waggle-sensor/sensors/sensors/README.md

<!--
waggle_topic=IGNORE
-->

# Chem_conv and beehive_plot

* **Chem_conv**: Codes in Chem_conv folder convert chemsense reading (in nA) stored in beehive database to ppm
* **conv_only**: Codes in conv_only folder convert chemsense reading, but no downloading data from beehive
* **beehive_plot**: Codes in beehive_plot folder plot temperature, humidity, and pressure data (easily add other parameters)
* **MetAddOn**: Datasheets for decagon soil moisture sensor and OnSet rain gauge
* **airsense**: Datasheets for all sensors on metsense board
* **lightsense**: Datasheets for all sensors on lightsense board
* **chemsense**: Datasheets for all sensors on chemsense board
* **opc**: Datasheets and relative data for opc particle sensor
* **images**: Images for the sensor boards
