waggle-sensor/sensors/sensors/conv_only/README.md

<!--
waggle_topic=IGNORE
-->

# Documentation:

 python scripts for Linux or Mac in this directory can be used to create new sensor data csv file. 
 You much have numpy and math python libraries, and sensor_data_set.csv and calib_data.csv files.
 
Usage:

$ python3 beehive_csv.py
