waggle-sensor/sensors/v4/documentation/README.md

<!--
waggle_topic=/sensors/v4.1,Data Format v4.1
-->

# Sensor Format V4.1

Please refer to [v4dataExchange.pdf](https://github.com/waggle-sensor/sensors/blob/master/v4.1/documentation/v4dataExchange.pdf).

If you do not have the file or the file is not found, use the following command to create it.

```bash
make
```
