waggle-sensor/sensors/v3/documentation/sensor-documentation/README.md

<!--
waggle_topic=/sensors/v3,Data Format v3
-->

# Sensor Format V3

Please refer to [sensorStreamFormat.pdf](https://github.com/waggle-sensor/waggle/blob/master/coresensors/docs/sensorStreamFormat/sensorStreamFormat.pdf).

If you do not have the file or the file is not found, use the following command to create it.

```bash
make
```
