waggle-sensor/sensors/v4/documentation/v4dataExchange.tex

\documentclass{article}

\usepackage{longtable}
\usepackage{footnote}

\usepackage{indentfirst}
\usepackage{tabto}

\usepackage[utf8]{inputenc}
\usepackage[T1]{fontenc}
\usepackage{fancyhdr}
\usepackage{geometry}
\usepackage{array}
\usepackage[usenames,dvipsnames,svgnames,table]{xcolor}
\usepackage{multirow}
\usepackage{morefloats}
\usepackage{float}
\usepackage{soul}
\usepackage{color}
\usepackage{seqsplit}
\usepackage{gensymb}
\usepackage{siunitx}
\usepackage{graphicx}
\usepackage{pdfpages}
\usepackage[framemethod=TikZ]{mdframed}
\setcounter{secnumdepth}{3}

\usepackage[procnames]{listings}
\usepackage{color}

\definecolor{keywords}{RGB}{255,0,90}
\definecolor{comments}{RGB}{0,0,113}
\definecolor{red}{RGB}{160,0,0}
\definecolor{green}{RGB}{0,150,0}

\lstset{language=Python,
        basicstyle=\ttfamily\small,
        keywordstyle=\color{keywords},
        commentstyle=\color{comments},
        stringstyle=\color{red},
        % showstringspaces=false,
        identifierstyle=\color{green},
        procnamekeys={def,class}}

\restylefloat{table}

\fontfamily{cmss}\selectfont

\geometry{top = 1in, bottom = 1in, left = 0.5in, right = 0.5in}

\setlength{\parindent}{4em}
\setlength{\parskip}{1em}
\renewcommand{\baselinestretch}{1.5}

\pagestyle{fancy}
\renewcommand{\footrulewidth}{1pt}
\lhead{Waggle Sensor Array}
\chead{Interface and Data Format Specification}
\rhead{Version 1.0}
\lfoot{Waggle Group}
\rfoot{info@wa8.gl, park708@purdue.edu}

\setlength{\tabcolsep}{10pt}
\renewcommand{\arraystretch}{1.0}

%%%%%%%%%%%%%%%%%%%%%%%%%%%%%%%%%%%%%%%%%%%%%%%%%%%%%%%%%%%%%%%%%%%%%%%%%%%%

\begin{document}

\begin{titlepage}
   \vspace*{\stretch{1.0}}
   \begin{center}
        \Huge\textbf{\textsc{Interface and \\ Data Format Specification \\ for sensors \\
        \Large\textsc(v3 sensor boards with Alpha sensor, \\ Firmware version 4.1)}}\\[0.5cm]
        \Large\textsc{Waggle Group \\ Waggle Sensor Array}\\[1cm]
        \large\textsc{November 2017, }
        \large\textsc{Version 1.0}\\
   \end{center}
   \vspace*{\stretch{2.5}}
\end{titlepage}

\tableofcontents
\newpage

\input{interfaceImg.tex}
\input{packetStructure.tex}
\input{SensorData.tex}
\input{SensorDataMetLight.tex}
\input{SensorDataChem.tex}
\input{SensorDataAlpha.tex}
\input{DataUnits.tex}

\end{document}
