waggle-sensor/sensors/v3/documentation/additional-sensors-documentation/interfaceImg.tex

\section{Physical Connections and Interfaces}

Physical connections between a Metsense board and additional sensor will be shown in a figure below.
The sensors will be connected through male-female connectors.
