waggle-sensor/sensors/v3.8/structure_design/waggle_cs_fw_structure_design.pptx

FW

Plugin + config
(HRF → packet)

Sensor

- config
- enable
- disable
- read
- write

Bus

- read
- write

Multiple Plugin in NC
(customized plugin for each user)

Sensor

- init
- config
- read
- write

Bus

- read
- write

single FW in CS

Driver + config

Sensor

- config
- enable
- disable
- read
- write

Bus

- read
- write

Single Drive in NC

request

request

answer

answer

## Slide 2

FW

Reading method

Sensor_id
(representative)

- i2c
- rs232
- spi
- analog
- digital

Function

- i2c
- rs232
- spi
- analog
- digital

- init (called when FW starts)
- config
- read
- write

Sensor

- Core
- New Added

- read
- write

## Slide 3

Sensor

Type

Functions

Sensor

Type

Functions

TMP112

i2c

init read

Onset-rain

digital

interrupt init(pin)

HTU21D

HIH4030

i2c

analog

read

read

soil-moisture

Water-level

rs232

analog

init(serial on) read

read

BMP180

i2c

Init (coeff) read

PMS7003

rs232

init(serial on) read

PR103J2

TSL250

analog

analog

read

read

PMS3003

rs232

init(serial on) read

MMA

i2c

analog

init (coeff) read

SPV

TSYS01

i2c

read

init(coeff) read

HMC

HIH6130

i2c

i2c

Init read

read

MCP(mux)

i2c

init(chip) read

→ APDS, TSL250, TSL260, MLX, ML (5 sensors)

TMP421

Chem

i2c

rs232

read

init(serial on) read

Alpha

spi

Init(pw on) config read
