waggle-sensor/sensors/v4/documentation/v4dataExchange.pdf

# Interface and

# Data Format Specification

# for sensors

(v3 sensor boards with Alpha sensor,

## Firmware version 4.1)

Waggle Group

Waggle Sensor Array

November 2017, Version 1.0

Waggle Sensor Array | Interface and Data Format Specication | Version 1.0

## Contents

1 Physical Connections and Interfaces | 2
2 Data Transmission | 3
3 Sub-packets from Coresense | 7
4 Sensor Data Units | 17
Waggle Group | 1 | info@wa8.gl, park708@purdue.edu

## 1 Physical Connections and Interfaces

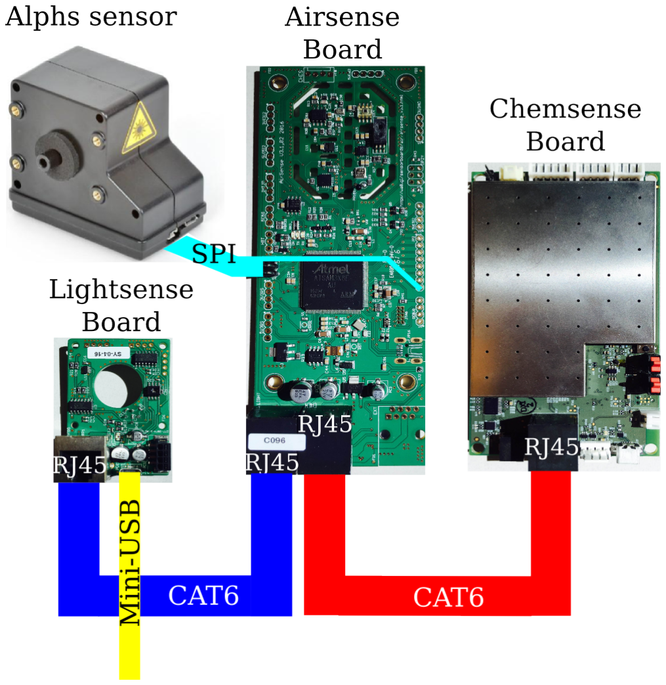
[picture p17: figure]

Figure 1: Connections between the sensor boards and the sensor

`v3 sensor boards with alpha sensor' means a set of sensors that are implemented on a v3.1 Metsense board, a v3.1

Lightsense board, and a Chemsense board and an independent alpha sensor.

Physical connections between sensor boards and an alpha sensor are shown in the Figure 1. A lightsense board

and a chemsense board are connected to a metsense board through CAT6 cable. The metsense and the lightsense deliver

data through I2C communication, and the chemsense board delivers data through serial3 communication. Alpha sensor is

conncted to the metsense on SPI pins and one of GPIT pins. User requests and collects data from alpha sensor using SPI

communication. All sensor data from metsense board, lightsense board, chemsense board, and alpha sensor are delivered to

nodecontroller thourgh USB line attached on lightsense board using Serial communication.

Waggle Group | 2 | info@wa8.gl, park708@purdue.edu

## 2 Data Transmission

The data from the sensor boards are packetized in a transmission pacekt with the form of as they had read from

the sensor. A transmission packet can be composed of several data sub-packets, each of which carries information pertaining

to the parameter. The transmission packet format and the data sub-packets are described here.

2.1 Transmission Packet

A transmission packet can be separated into 6 segments. The structure of the transmission packet relies on posi-

tions of Bytes and predened values for those Byte segments. Table 1 below illustrates how the segments are organized in a

transmission packet.

Preamble | a a | Data Length | b b | Data | CRC | Postscript
1st Byte | 2nd Byte | 3rd Byte | 4th Byte | next Bytes up to 255 Bytes | Penultimate Byte | Final Byte
aPacket Type | Protocol Version
bLast Packet Flag | Sequence

Table 1: Transmission Packet structure

A description how the segments are organized in a transmission packet is shown in table 2 below.

Field | Value | Segment | Length
Preamble | 0xAA | 1 | 1 Byte
Packet Type | 0x00: request 0x01: sensor reading 0x02: bus reading | 2 | 1 Nibble
Protocol version | 0x02 | | 1 Nibble
Length of data | Variable | 3 | 1 Byte
Last Packet ag | 0x01: last packet for one request 0x00: not last packet | 4 | 1 bit
Packet sequence | Variable | | 7 bits
Data | Variable | 5 | Variable
CRC of data | Variable | 6 | 1 Byte
Postscript | 0x55 | 7 | 1 Byte

Table 2: Transmission Packet Segments

Waggle Group | 3 | info@wa8.gl, park708@purdue.edu

The rst segment is the start byte, or the preamble. The preamble is followed by the packet type and protocol

version, each of which are 4 bits long and are together packed into a single byte. Packet type is diered with regard to the

purpose of the packet. When the packet sent from plugin to rmware, the type is requres, and when the packet sent from

rmware, type of the packet could be sensor reading or bus reading. Type sensor reading means the data packetized in

the packet are readings from sensors, which are sorted with sensor id given by Waggle group, and bus reading means the

data packetized in the packet are readings from sensors that do not have given sensor id but connected on metsense board

so that rmware can collect data from. Next, one byte eld that reports the rst 1 bit of last packet ag and 7 bit sequence

number. Following byte reports length of the data which comes along until its immediately. The data segment is followed

by a single CRC byte, and nally the packet ends with a one byte crc and postscript. Table 2 lists the packet and the static

values, if any, for each of the segments.

2.2 Data Sub-packets

The data segment of the transmission packet can be further separated into many sub-packets. Two types of sub-

packets are implemented, each of sub-packets are for sending request from coresense plugin to coresense rmware and visa

versa.

Table 3 below shows the organization of a sub-packet requesting sensor data. The sub-pacekt starts with 4-bits call

function id and 4-bits parameter length including source identier, which is sensor id. The next bytes are parameters starting

with target sensor id. Additional parameters can be attached after the sensor id. For more detail, refer sensor description

le (SDF).

Table 4 below shows the organization of a sub-packet sending sensor reading. The sub-packet starts with a source

identier, which is sensor id. One bit validity eld and seven bits length of the sub-packet eld are packed together as the

next byte. The length eld counts the number of bytes following it which make up the sub-packet. The validity bit is set to

1 if the sensor reading is valid and set to 0 if the sensor is dead, disabled, unconnected, unresponsive or if data could not be

collected from the sensor in the time window. The size of the sub-packet is restricted to 127 Bytes by the seven bits length eld.

Call Function ID | 1-bit Acknowledge | Parameter Length | Parameters a
1 byte | 1 Byte | up to 252 Bytes

aFor sensors have sensor id, 1st Byte is SENSOR ID; For sensors collect data through bus functions, 1st Byte is bus type and 2nd Byte is BUS

ADDRESS

Table 3: Transmission Packet Segments from plugin to rmware

Waggle Group | 4 | info@wa8.gl, park708@purdue.edu

Source ID | 1-bit Validity [0: invalid, 1: valid] | 7-bits Data Length | Data a
1 Byte | 1 Byte | up to 127 Bytes

aFor sensors have sensor id, 1st Byte is SENSOR ID; For sensors collect data through bus functions, 1st Byte is bus type and 2nd Byte is BUS

ADDRESS

Table 4: Transmission Packet Segments

2.3 Data Packer CRC

To validate the data transmitted from and to the sensor board, a CRC value for the data is calculated and transmitted

as part of the data packet. The Maxim 1-Wire CRC polynomial is used for calculating the CRC. On receiving the packet,

the CRC is recalculated and compared with the value transmitted as part of the packet. If the two CRC values match, the

transmission is error-free. The equivalent polynomial function of the CRC is shown in Equation 1.

CRC = x

8 + x

5 + x

4 + 1 | (1)

Further description of the Maxim 1-Wire CRC is available in Maxim Application Note 27. Below are the Python

and C implementations of the CRC calculator. The CRC implementations below take a data Byte and the previous CRC as

inputs, and return the new CRC as return value.

Python Code:

def calc_crc ( data_Byte , CRC_Value )

CRC_Value = ord( data_Byte ) ^ CRC_Value

for j in range (8):

if ( CRC_Value | & 0x01 ):
CRC_Value | = ( CRC_Value | >> 0x01) ^ 0x8C

else :

CRC_Value | = | CRC_Value | >> 0x01

return CRC_Value

C Code:

unsigned char CRC_CALC ( unsigned char data , unsigned char crc)

{

unsigned char i;

Waggle Group | 5 | info@wa8.gl, park708@purdue.edu

crc ^= data ;

for (i=0 x00; i < 0x08; i++)

{

if (crc & 0x01 ) { crc = (crc >> 0x01 )^0 x8C ; }

else { crc = crc >> 0x01 ; }

}

return (crc );

}

Waggle Group | 6 | info@wa8.gl, park708@purdue.edu

## 3 Sub-packets from Coresense

As shortly explained in document section 2.2, data sub-packets from metsense board, lightsense board, chemsense

board, and alpha sensor are generated depending on its data reading from each sensor if valid. The rst byte of the sub-

packets from those sensor boards/sensor is sensor ID, and the rst bit of second byte means validity of the packet and next

7 bits of the second byte is length of the sensor data. Data length and type of sensor reading are shown in Table 5. Detail

of sub-packet and sensor data will be explined following sections.

3.1 Parameters

The sensor boards output a set of parameters which are identied by a unique ID. Each parameter has a set of

values associated with it which are encoded in an appropriate data format. The table below lists the various parameters

produced by the sensor boards, the unique source ID used to identify them, the values produced by them.

Table 5: Data sub-packet structure (each row is a chunk)

Parameter | Source ID | Values | Data Length
Firmware version | 0xFF | Version (HW/SW) | 2 bytes
| | Build time | 4 bytes
| | Build git | 2 bytes

Metsense board

Metsense/Lightsense MAC address | 0x00 | MAC Address | 6 bytes
TMP112 | 0x01 | Temperature | 2 bytes
HTU21D | 0x02 | Temperature | 2 bytes
| | Relative humidity | 2 bytes
HIH4030 | 0x03 | Relative humidity | 2 bytes
BMP180 | 0x04 | Temperature | 2 bytes
| | Pressure | 3 bytes
PR103J2 | 0x05 | Temperature | 2 bytes
TSL250RD | 0x06 | Visible Light | 2 bytes
MMA8452Q | 0x07 | Acceleration in X | 2 bytes
| | Acceleration in Y | 2 bytes
| | Acceleration in Z | 2 bytes
SPV1840LR5H-B | 0x08 | RMS Sound Level | 128 bytes

Continued on next page

Waggle Group | 7 | info@wa8.gl, park708@purdue.edu

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

3.2 Data packets

The context of each parameter, its utility and the arrangement of its values is described below. In all the tables

below, the validity bit is set to 1, which means the data is valid. The parameter described below are aggregated based on

the sensor-board they are situated on - Metsense, Lightsense and Chemsense.

3.2.1 Firmware Version

This is a 8 bytes version information that identies hardware version, software version, and build information of the

waggle node. The build time and the build git are included to varify the eectiveness of the software. Firmware version is

bit masked and encoded through format 1, and build git is encoded through format 1.

0xFD | 0x88 | Firmware version | Build time | Build git
Byte[0] | Byte[1] | Bytes[2 3] | Bytes[4 7] | Bytes[8 9]

Table 6: Sub-packet of Firmware version

3 bit major HW ver. | 3 bit minor HW ver. | 2 bit major SW ver. | Byte[2]
2 bit major SW ver. | minor SW ver. × 10 + sub SW ver. | Byte[3]

Table 7: Firmware version

3.2.2 | Metsense
- Metsense/Lightsense MAC address: | This is a 6-byte ID that uniquely identies each Airsense board. This MAC

address is also applied to each Lightsense board which has the same board number. The ID is provided by a DS2401 1-Wire

DSN chip. The 1-byte family ID and CRC provided by the DSN chip are omitted, and the rest 6 bytes are used as the Unique

ID.

0x00 | 0x86 | MAC address
Byte[0] | Byte[1] | Bytes[2 7]

Table 8: Sub-packet of met/lightsense board MAC address

- TMP112, HIH4030, PR103J2, TSL250RD, TSYS01: TMP112, PR103J2, and TSYS01 are temperature sensors,

HIH4030 is a humidity sensor, and TSL250RD is a light sensor. The coresense rmware collectes data from TMP112 through

I2C, and from other sensors using analog read. All the reading values from the sensors are packetized as the raw value as

they are collected. The raw reading will be converted relatively to temperature in centigrade, humidity in %RH, and light in

lux.

Waggle Group | 10 | info@wa8.gl, park708@purdue.edu

Sensor ID (0x01, 0x03, 0x05, 0x06, 0x09) | 0x82 | Raw sensor reading
Byte[0] | Byte[1] | Bytes[2 3]

Table 9: Sub-packet for the sensor listed above

- HTU21D: HTU21D is a temperature and relative humidity sensor. The coresense rmware collects data from HTU21D

through I2C and the readings are packetized as the raw value as they are collected. The raw readings will be converted to

temperature in centigrate, humidity in %RH.

0x02 | 0x84 | Raw temperature reading | Raw humidity reading
Byte[0] | Byte[1] | Bytes[2 3] | Bytes[4 5]

Table 10: Sub-packet of a temperature and relative humidity sensor, HTU21D

- BMP180: BMP180 is a temperature and barometric pressure sensor. The coresense rmware collects data from BMP180

through I2C and the readings are packetized as the raw value as they are collected. The raw readings will be converted to

temperature in centigrade and barometric pressure in hPa.

0x04 | 0x84 | Raw temperature reading | Raw pressure reading
Byte[0] | Byte[1] | Bytes[2 3] | Bytes[4 5]

Table 11: Sub-packet of a temperature and barometric pressure sensor, BMP180

- MMA8452Q: MMA8452Q is a three-axis accelerometer. The accelerations in three orthogonal directions, x, y and z,

as a multiple of acceleration due to gravity (g) are obtained from the sensor. The coresense rmware collects data from this

sensor through I2C and the readings are packetized as the raw value as they are collected. The raw reading will be converted

to a vibration value (represented as multiple of g) and three directional acceleration in g.

0x07 | 0x86 | Raw Ax reading | Raw Ay reading | Raw Az reading
Byte[0] | Byte[1] | Bytes[2 3] | Bytes[4 5] | Bytes[6 7]

Table 12: Sub-packet of a three-axis accelerometer, MMA8452Q

- SPV1840LR5H-B: SPV1840LR5H is a MEMS microphone that is sampled at high frequency to obtain the peaks and

calculate the sound intensity for a time window. The coresense rmware collects data from this sensor through analog read

and the readings are packetized as the raw value as they are collected. The raw readings will be converted to sound level in dB.

Waggle Group | 11 | info@wa8.gl, park708@purdue.edu

0x08 | 0xFF | 64 times of Raw reading
Byte[0] | Byte[1] | Bytes[2 129]

Table 13: Sub-packet of a sound level sensor, SPV1840LR5H-B

3.2.3 Lightsense

- HMC5883L: HMC5883L is a three-axis magnetometer. The magnetic eld strengths in three orthogonal directions, x,

y and z are obtained from the sensor. The coresense rmware collects data from this sensor through I2C and the readings

are packetized as the raw value as they are collected. The raw readings will be converted to three directional magnetic eld

in G.

0x0A | 0x86 | Raw Hx reading | Raw Hy reading | Raw Hz reading
Byte[0] | Byte[1] | Bytes[2 3] | Bytes[4 5] | Bytes[6 7]

Table 14: Sub-packet of a three-axis magnetometer, HMC5883L

- HIH6130: HIH6130 is a temperature and relative humidity sensor. The coresense rmware collects data from HIH6130

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

temperature in centigrate, humidity in %RH.

0x0B | 0x84 | Relative Humidity in Format 6 | Temperature in Format 6
Byte[0] | Byte[1] | Bytes[2 3] | Bytes[4 5]

Table 15: Sub-packet of a temperature and relative humidity sensor, HIH6130

- APDS-9006-020, TSL260, TSL250, MLX75305, and ML8511: APDS-9006-020, TSL260, TSL250, MLX75305,

and ML8511 are light sensors that produce the analog voltage representing in general luminance, irradiance measured in

µW/cm²
, or UV index. The coresense rmware collects data from sensors listing above through I2C and the reading is

packetized as the raw value as it is collected. The raw reading will be converted to temperature in centigrate, humidity in

%RH.

Sensor ID (0x0C ∼ 0x10) | 0x82 | Voltage output in Format 1
Byte[0] | Byte[1] | Bytes[2 3]

Table 16: Sub-packet of light intensity sensors, APDS-9006-020, TSL260, TSL250, MLX75305, and ML8511

Waggle Group | 12 | info@wa8.gl, park708@purdue.edu

- TMP421: TMP421 is a temperature sensor. The coresense rmware collects data from TMP421 through I2C and the

reading is packetized as the raw value as it is collected. The raw reading will be converted to temperature in centigrate.

0x13 | 0x82 | Temperature in Format 6
Byte[0] | Byte[1] | Bytes[2 3]

Table 17: Sub-packet of a temperature sensor, TMP421

3.2.4 Chemsense:

Chemsense board sends data through Serial3 communication line in metsense board. All sensor values from chem-

sense board are caluated in its own rmware. The raw serial readings from the board are packetized as the raw value as they

are collected, and the reading will be sorted out in database.

- Chemsense reading: To fully collect all the data from chemsense board, the rmware collect data three times in a row,

so that coresense rmware sends three packets when it gets request of reading of chemsense board.

0x2A | Varies | Raw reading
Byte[0] | Byte[1] | Bytes[Vareis]

Table 18: Sub-packet of a chemsense board

- Chemsense rmware conguration: THIS DATA DO NOT FOLLOW CORESENSE PACKET FORMAT,

NO FORMAT AT ALL Chemsense Fiwmware conguration is one-time collectable charactor data, when the board is

powered on. The coresense rmware collectes data when the board is powered on, and store the data into an array. The user

can call this data with their own plugin (request and answer collecting functions).

1st line | Start sending Chemsense FW conguration
2nd 48th line | Each raw reading line (Character)
last line | End sending Chemsense FW conguration

Table 19: Sub-packet of chemsense rmware conguration

3.2.5 Alpha Sensor:

Coresense rmware communicates with alpha sensor through SPI. The raw SPI readings from the board are packe-

tized as the raw value as they are collected, and the reading will be sorted out in database. In this document, concise Alpha

sensor information is provided. For more information, refer to `Firmware commands version 18.xls' and `OPC-N2

Manual Issue December 2015.pdf ' at `waggle/docs/alphasense-opc-n2'.

Waggle Group | 13 | info@wa8.gl, park708@purdue.edu

- Histogram Histogram of alpha sensor is 62 bytes of reading. This parameter provides various information as listed

below. All data from the alpha sensor is LSB rst.

0x28 | 0xBE | Various sensor information as listed above
Byte[0] | Byte[1] | Bytes[2 63]

Table 20: Sub-packet Alpha sensor histogram

- Bin Counts (Bin0 - Bin15) are unsinged 16 bit integer variables (Bytes[2 33]).
- An unsigned 8-bit integer represents the average amount of time that particles sized in the stated bin took cross the

laser beam of the sensor. Value 10 represents 3.33 µs (Bytes[34 37]).

- The sample ow rate in ml/s is provided as a oat variable (Bytes[38 41]).
- Temperature and Pressure alternating. Temperature is an unsigned 32-bit integer that represents temperature in

Celsious multiplied by 10. Pressure is an unsigned 32-bit integer that represents pressure in pascals (Bytes[42 45]).

- Actual sampling period of a measure of the historgam in seconds provided as 4 bytes of oat variables (Bytes[46 49]).
- The least signicat 16-bit of the sum of the counts in all the histogram bins is provided by unsigned 16bit integers

(Bytes[50 51]).

- A oat variable occupying 4 bytes for PM1. Unit is µg/m³
(Bytes[52 55]).
- A oat variable occupying 4 bytes for PM2.5. Unit is µg/m³ (Bytes[56 59]).
- A oat variable occupying 4 bytes for PM10. Unit is µg/m³ (Bytes[60 63]).
Parameter | Data location
Bin Count (32 Bytes) | Bytes[2 - 33]
Average Time (4 Bytes) | Bytes[34 37]
Sample ow rate (4 Bytes) | Bytes[38 41]
Temp/Pressure(alter) (4 Bytes) | Bytes[42 45]
Sampling period (4 Bytes) | Bytes[46 49]
Sum of the counts (2 Bytes) | Bytes[50 51]
PM1 (4 Bytes) | Bytes[51 55]
PM2.5 (4 Bytes) | Bytes[56 59]
PM10 (4 Bytes) | Bytes[60 63]

Table 21: Detail sub-packet of Alpha sensor histogram

- Serial Serial of alpha sensor is 20 bytes of reading. This parameter provides the serial number of the alpha sensor by

character.

Waggle Group | 14 | info@wa8.gl, park708@purdue.edu

0x29 | 0x94 | Raw values
Byte[0] | Byte[1] | Bytes[2 21]

Table 22: Sub-packet of Alpha sensor serial number

- Firmware Firmware of alpha sensor is 2 bytes of reading. This parameter provides the Firmware version of the alpha

sensor by two unsigned 8-bit integer.

0x30 | 0x82 | Raw values
Byte[0] | Byte[1] | Bytes[2 3]

Table 23: Sub-packet of Alpha sensor rmware

- Status Status of alpha sensor is 4 bytes of reading. This parameter provides status of the alpha sensor in terms of if fan

and laser are on/o and DAC value of the fan and laser.

0x2B | 0x84 | Raw values
Byte[0] | Byte[1] | Bytes[2 5]

Table 24: Sub-packet of Alpha sensor rmware

Parameter | Data location
Fan on/o (1 Byte, 0 or 1) | Bytes[2]
Laser on/o (1 Byte, 0 or 1) | Bytes[3]
Fan DAC value (1 Byte) | Bytes[4]
Laser DAC value (1 Byte) | Bytes[5]

Table 25: Detail sub-packet of Alpha sensor histogram

- Conguration THIS DATA DO NOT FOLLOW CORESENSE PACKET FORMAT, NO FORMAT AT

ALL Conguration of alpha sensor is 256 bytes of reading. This parameter provides various information as listed below.

Since this conguration data is too long to t into a sub-packet, the data are not packed into coresense packet.

1st line | Start sending alpha sensor conguration
2nd line | 256 bytes of raw reading (Binary)
last line | End sending alpha sensor conguration

Table 26: Sub-packet of alpha sensor conguration

Waggle Group | 15 | info@wa8.gl, park708@purdue.edu

- Bin Boundaries (BB0 - BB14) are unsinged 16 bit integer variables, and two spare bytes.
- Bin Particle Volumes (BPV0 - BPV15) are oat variables occupyting 4 bytes each.
- Bin Particle Densities (BPD0 BPD15) are oat variables occupying 4 bytes each.
- Bin Sample Volume Weightings (BSVW0 BSVW15) are oat variables occupying 4 bytes each.
- Gain Scaling Coecient (GSC) is oat variable occupying 4 bytes.
- Sample ow rate is a oat variable occupying 4 bytes.
- Laser DAC value is unsigned 8bit interger variable.
- Fan DAC value is unsigned 8bit integer variable.
- Time of Flight to Sample Flow Rate conversion factor is unsigned 8bit integer variable.
- 21 spare bytes follow Conguration variables.
Parameter | Data location
Bin Boundaries (32 Bytes) | Bytes[0 31]
Bin Particle Volumes (64 Bytes) | Bytes[32 95]
Bin Particle Densities (64 Bytes) | Bytes[96 159]
Bin Sample Volume Weightings (64 Bytes) | Bytes[160 223]
Gain Scaling Coecient (4 Bytes) | Bytes[224 227]
Sample Flow Rate (4 Bytes) | Bytes[228 231]
Laser DAC (1 Byte) | Byte[232]
Fan DAC (1 Byte) | Byte[233]
Conversion factor (1 Byte) | Byte[244]
Spare Bytes (21 Bytes) | Bytes[245 255]

Table 27: Detail second lind of Alpha sensor conguration

Waggle Group | 16 | info@wa8.gl, park708@purdue.edu

4 | Sensor Data Units
4.1 | Raw and Processed

The sensor boards output a set of raw readings which need to be calculated for proper units for each of data. The

table below lists the various units for each sensor values. `Current Units' in the table means the unit after conversion through

designated equations stored in database currently (Nov, 2017), and `Processed Units' means the unit which will be updated

in the future.

Table 28: Sensor units

Sensor/Parameter | Current Units | Processed Units | Comments
Firmware version | No Units | No Units

Airsense board

Met/Lightsense MAC | No Units | No Units
TMP112 | ◦C | ◦C
HTU21D | ◦C, %RH | ◦C, %RH
BMP180 | ◦C, Pa | ◦C, Pa
PR103J2 | ◦C | ◦C
TSL250RD | Raw reading* | µw/m²
MMA8452Q | g, g, g | g, g, g, g
SPV1840LR5H-B | Raw reading*
TSYS01 | ◦C | ◦C

Lightsense board

HMC5883L | G, G, G | G, G, G
HIH6130 | ◦C, %RH | ◦C, %RH
APDS-9006-020 | Raw reading | lux
TSL260RD | Raw reading* | µw/m²
TSL250RD | Raw reading* | µw/m²
MLX75305 | Raw reading* | µw/m²
ML8511 | Raw reading* | UV index
TMP421 | ◦C | ◦C

Chemsense board

Chemsense conguration | No unit | No unit | Don't need conversions
Chemsense reading | Raw reading* | See Table 29

Continued on next page

Waggle Group | 17 | info@wa8.gl, park708@purdue.edu

Table 28 continued from previous page

Sensor/Parameter | Current Units | Processed Units | Comments

Alpha sensor

Serial | No unit | No unit
Firmware | No unit | No unit

Alpha sensor Status

FanON | No unit | No unit
LaserON | No unit | No unit
FanDACVal | No unit | No unit
LaserDACVal | No unit | No unit

Alpha sensor Histogram

Bin count | No unit | No unit
Average time | Raw reading* | µs | value 10 = 3.33 µs
Sample ow rate | Raw reading* | ml/s
Temp/Pressure(alter) | Raw reading* | ◦C / hPa (alter)
Sampling period | Raw reading* | s
Sum of the counts | No unit | No unit
PM1 | Raw reading* | µg/m³
PM2.5 | Raw reading* | µg/m³
PM10 | Raw reading* | µg/m³

Alpha sensor Conguration

Bin boundaries | No unit | No unit
Bin particle volumes | Raw reading*
Bin particle densities | Raw reading*
Bin sample volume weightings | Raw reading*
Gain scaling coecient | Raw reading*
Sample ow rate | Raw reading*
Laser DAC | Raw reading*
Fan DAC | Raw reading*
Conversion factor | Raw reading*
Spare bytes | No unit | No unit

*Raw reading means the reading has no unit currently, and conversion equation for the sensor is not implemented in database. The data stored

in database for this sensor is just integer form of raw reading.

Waggle Group | 18 | info@wa8.gl, park708@purdue.edu

Source ID | Parameter | Current Units | Processed Units | Comments
0x15 | Total reducing gases | Raw reading* | ppm
0x17 | Nitrogen dioxide
0x18 | Ozone
0x19 | Hydrogen sulphide
0x1A | Total oxidizing gases
0x1B | Carbon monoxide
0x1C | Sulfur dioxide
0x1D | SHT25 | 100ths of ◦C / %RH | ◦C, %RH
0x1E | LPS25H | 100ths of ◦C, Pa | ◦C, Pa
0x1F | Si1145 | Raw reading* | | Uncompleted FW
0x20 | Intel MAC address | No Units | No Units
0x21 | CO ADC temp | 100ths of ◦C | ◦C
0x22 | IAQ IRR ADC temp
0x23 | O3 NO2 ADC temp
0x24 | SO2 H2S ADC temp
0x25 | CO LMP temp
0x26 | Accelerometer | Raw reading* | | Not in Chem v2 Uncompleted for v1&2
0x27 | Gyro | Raw reading*

*Raw reading means the reading has no unit currently, and conversion equation for the sensor is not implemented in database. The data stored

in database for this sensor is just integer form of raw reading.

Table 29: Transmission packet structure of chemsense board reading

Waggle Group | 19 | info@wa8.gl, park708@purdue.edu
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
