waggle-sensor/sensors/v3/documentation/sensortable/SensorTable.pdf

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

Waggle Sensor Array Sensors Version 0.2 alpha 3 Table 1 Continued from previous page Parameter ID Values Sensor Output FW Output Beehive Output Decoder Output Conguration D 0x34 Bin Sample Vol Weightings B raw register raw register n/a raw register Gain Scaling Coecient Sample Flow Rate Laser DAC and Fan DAC Conversion factor Space Bytes Rain Gauge Rain Gauge 0xFC Rainfall voltage event counts n/a in. or mm Soil Moisture Sensor (5TE Decagon) Soil Sensor 0xFB Dielectric permittivity No Unit No Unit n/a No Unit Electric conductivity dS/m dS/m n/a dS/m Temperature

◦C

◦C | n/a

◦C

* Decoder means a decoder for testing coresense rmware, which is in waggle/coresense/v3/integrated/software.

* If output of Beehive and Decoder are dierent, that means conversion equation used in decoder is not yet completely veried.

* Conversion equations used in the decoder are explained in Waggle Doc (v3dataExchange.pdf) in waggle/coresense/v3/docs.

* Data from Alpha sensor using SPI communication is not yet completed, which is through the coresense FW. The data can just translated into human readable

values through coresense decoder.

Waggle Group 4 info@wa8.gl, park708@purdue.edu
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
