waggle-sensor/sensors/sensors/conv_only/calib_data.csv

088726-0013 | 5410EC38B845 | 042617010352 | 110902 | RESP | 1705 | -62.19 | 042617050316 | 999078 | SO2 | 1705 | 11.76 | 051217020232 | 999036 | O3 | 1705 | -84.4 | 042617030318 | 110802 | IAQ | 1705 | 17.00 | 042617040431 | 999062 | H2S | 1705 | 320.75 | 051217010238 | 999061 | NO2 | 1705 | -29.96 | 042617020231 | 110109 | CO | 1705 | 3.40 | 51.288675692313 | 13.6226477391924 | 8.33108934220041 | 171.78732369033 | 37.236515228787 | 22.0693620740967 | 3.12767524618886 | 3.5651 | 37.6159333333333 | 1.28136666666667 | 5.05256666666667 | 0.762066666666667 | 0.5216 | 10.9864 | 12.5733 | 124.719033333333 | 3.438 | 12.0967666666667 | 0.3472 | 0.871666666666667 | 52.0714333333333 | 40.0782333333333 | 436.0858
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
