waggle-sensor/sensors/v3/qa_testing/design_dev_tests/Airsense_Initialization/coresense/README.md

<!--
waggle_topic=IGNORE
-->

## Testing Procedure
*   Setup 1:
    -   Complete electrical connections.
    -   Perform test by issuing command *make run* in the coresense directory.

*   Setup 2:
    ~~-  In the Wagman folder - First issue the command *make install*.~~
    -  On completing the above, perform test by issuing command *make run* in the coresense directory.

*   Setup 3:
    -   Complete electrical connections.
    -   Perform test by issuing command *make run* in the coresense directory.

## Example Output
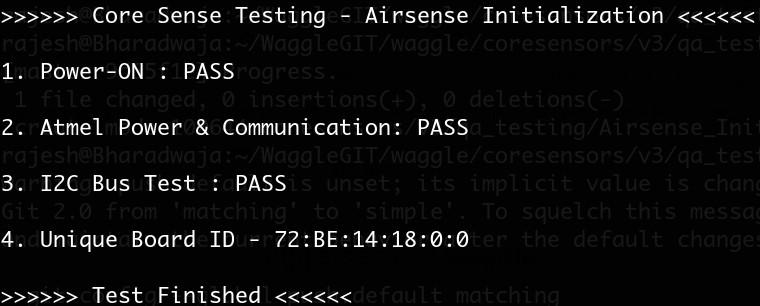
[picture p18: v3/qa_testing/production_tests/Board_Tests_Air+Light/resources/TestOutput.jpg]
