waggle-sensor/sensors/v3/testing/integrated_old/README.md

#Core sensors
TODO: describe what this software does along with the sensors.
