waggle-sensor/sensors/v3/qa_testing/design_dev_tests/Airsense_Heartbeat/README.md

<!--
waggle_topic=IGNORE
-->

# Test Scope and Coverage

This test evaluates the following aspects of Airsense design. </br>
*   Airsense's ability to generate a heartbeat signal which can be sensed by Wagman. </br>

# Test Setup Procedure

## Test Events Timeline
* Wagman is loaded with firmware that tests the presence of Airsense heartbeat.
* Airsense is loaded with firmware that generates the heartbeat.

## Electrical Connection
-   Connect Lightsense to Airsense using CAT6 cable between Lightsense's RJ45 jack and Airsense's RJ45 jack
    labeled __Light__.  </br>
    
-   Connect a micro USB cable between Lightsense and QA computer.
-   Connect the 4 wires (Red, Black, White and Yellow) between Lightsense and Wagman's Port 3 (J6). </br>
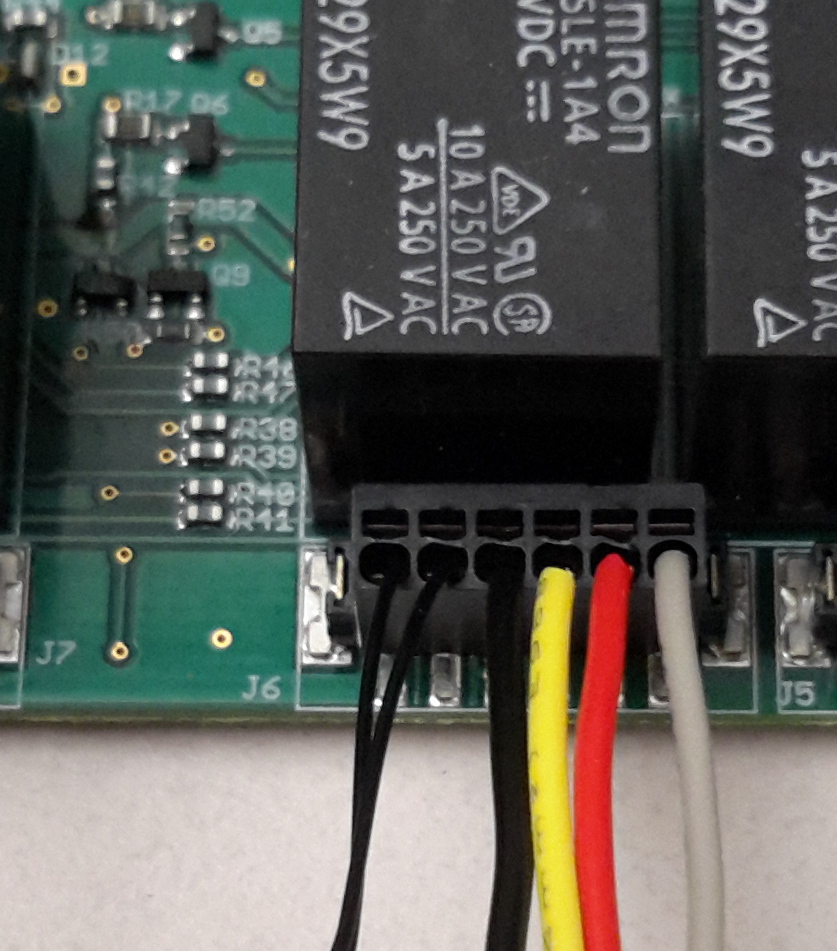
[picture p23: v3/qa_testing/design_dev_tests/Airsense_Heartbeat/resources/Wagman_LightSense.jpg]
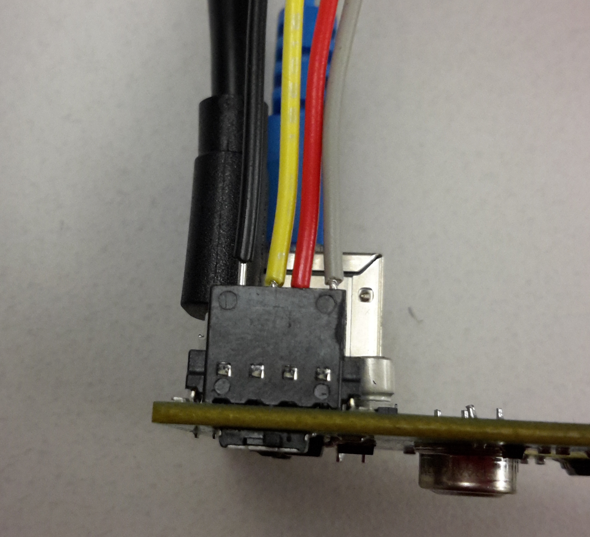
[picture p24: v3/qa_testing/design_dev_tests/Airsense_Heartbeat/resources/Light_sense_Wagman_connection.jpg]
    
-   Set the mode slide switch on Lightsense toward the left (closer to R1 label on the board).</br>
    
-   Connect micro-USB cable between Wagman's J3 and QA computer.
-   Connect 5V DC power to Wagman.

__Please make sure only the Wagman, Airsense and Lightsense under test are connected to the QA computer.
No other Arduino Micro and Due/derivatives can be connected at this time.__

## Testing Procedure
__The Coresense boards are powered by Wagman during the test.__</br>

*  In the Wagman folder - First issue the command *make program*.
*  On completing the above, change to the coresense folder, and issue command *make program*
*  On completing the above, change back to the Wagman folder and issue the command *make test*

__To exit the screen session created for the test, press Control+a, followed by k and y.__

## Test Log
This test is evaluated and scored on the __Coresense QA Test__ document.

# Success Criteria
The test is considered __PASSED__ if all the sub-tests under the Airsense Heartbeat Test pass.
