waggle-sensor/sensors/v3/qa_testing/design_dev_tests/Airsense_Heartbeat/wagman/README.md

<!--
waggle_topic=IGNORE
-->

## Testing Procedure
__Only the Coresense boards are powered by Wagman during the test.__</br>
__The Odroids XU4 and C1P have to be powered on independently.__</br>
*  In the Wagman folder - First issue the command *make program*.</br>
~~*  On completing the above, change to the coresense folder, and issue command *make program*~~</br>
*  On completing the above, change back to the Wagman folder and issue the command *make test*
