waggle-sensor/sensors/v3/integrated/tests/alphasense_opcn2/Dat2_PM1_Multispace.pdf

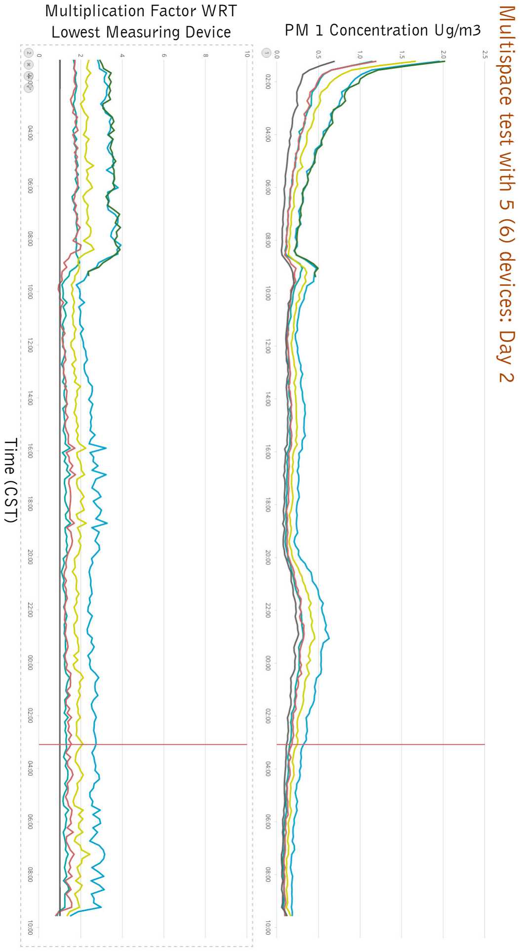
[picture p26: page 1]

Time (CST)

Multiplication Factor WRT
Lowest Measuring Device | PM 1 Concentration Ug/m3

## Multispace test with 5 (6) devices: Day 2
