waggle-sensor/sensors/v3/integrated/tests/alphasense_opcn2/Day2_PM2.5_Multispace.pdf

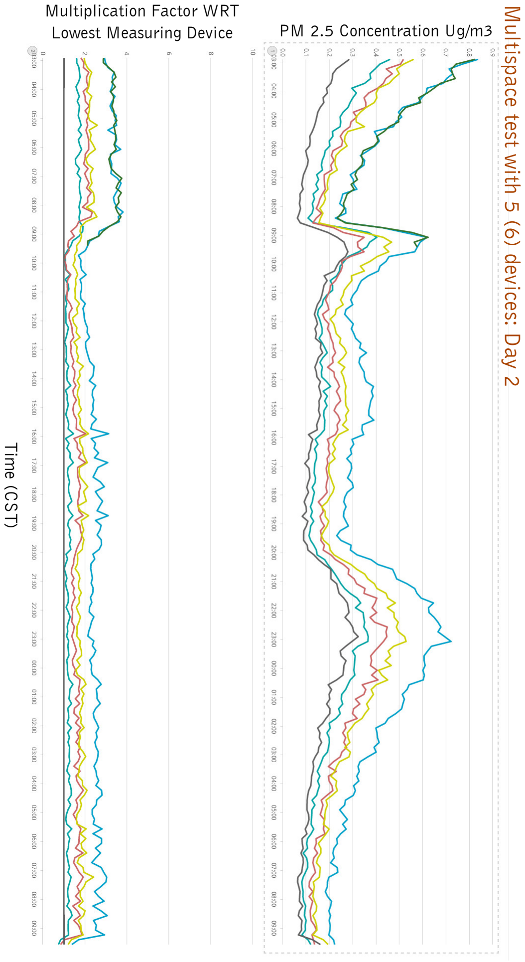
[picture p27: page 1]

Time (CST)

Multiplication Factor WRT
Lowest Measuring Device | PM 2.5 Concentration Ug/m3

## Multispace test with 5 (6) devices: Day 2
