waggle-sensor/sensors/v3/qa_testing/production_tests/QA_Scoresheet/QA_Test.ods

 | Pass / Fail | Coresense QA Test |  | H/W Ver 3.1 2016/Mar/27
Board Unique ID: |  |  |  | Doc Rev. 0.1
S.No | Test | Output | Result | Test Result
I | Airsense Initialization |  |  | Pass / Fail
Setup 1
1 | Power-ON |  | Pass / Fail
2 | Atmel Power & Communication |  | Pass / Fail
3 | I2C Bus Test |  | Pass / Fail
4 | Unique ID |  | Pass / Fail
Setup 2
1 | Power-ON |  | Pass / Fail
2 | Atmel Power & Communication |  | Pass / Fail
3 | I2C Bus Test |  | Pass / Fail
4 | Unique ID |  | Pass / Fail
Setup 3
1 | Power-ON |  | Pass / Fail
2 | Atmel Power & Communication |  | Pass / Fail
3 | I2C Bus Test |  | Pass / Fail
4 | Unique ID |  | Pass / Fail
II | Airsense Heartbeat |  |  | Pass / Fail
1 | Hearbeat Test |  | Pass / Fail
III | Airsense-Lightsense Connectivity |  |  | Pass / Fail
1 | Connectivity Test |  | Pass / Fail
IV | Chemsense Power Control and Connectivity |  |  | Pass / Fail
1 | Serial Connectivity |  | Pass / Fail
2 | Heartbeat and Reset |  | Pass / Fail
3 | Powercontrol
V | External RJ45 Connectivity Test |  |  | Pass / Fail
1 | I2C communication Test. |  | Pass / Fail
VI | Airsense Environmental Sensors Test |  |  | Pass / Fail
1 | TMP112 |  | Pass / Fail
2 | HTU21D |  | Pass / Fail
3 | HIH4030 |  | Pass / Fail
4 | BMP180 |  | Pass / Fail
5 | PR103J2 |  | Pass / Fail
6 | TSL250RD |  | Pass / Fail
7 | MMA8452Q |  | Pass / Fail
8 | SPV1840LR5H-B |  | Pass / Fail
9 | TSYS01 |  | Pass / Fail
10 | HMC5883L |  | Pass / Fail
VII | Lightsense Environmental Sensors Test |  |  | Pass / Fail
1 | HIH6130 |  | Pass / Fail
2 | APDS-9006-020 |  | Pass / Fail
3 | TSL260RD |  | Pass / Fail
4 | TSL250RD |  | Pass / Fail
5 | MLX75305 |  | Pass / Fail
6 | ML8511 |  | Pass / Fail
7 | MLX90614 |  | Pass / Fail
8 | TMP421 |  | Pass / Fail
VIII | OPC-N2 Connectivity Test |  |  | Pass / Fail
1 | Connectivity Test |  | Pass / Fail
