waggle-sensor/sensors/v3/integrated/tests/alphasense_opcn2/Day1_PM10_Outdoor.pdf

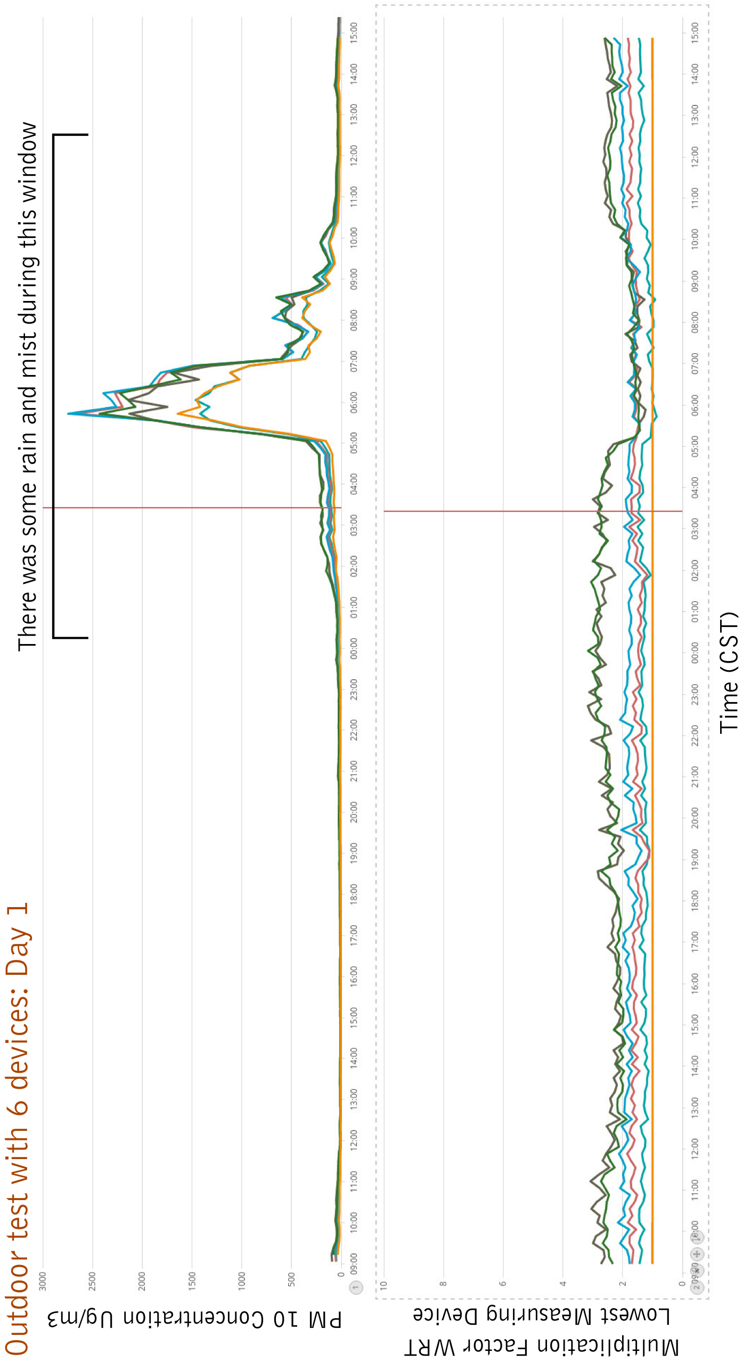
[picture p28: page 1]
