waggle-sensor/sensors/v3/integrated/tests/alphasense_opcn2/Day1_PM1_Outdoor.pdf

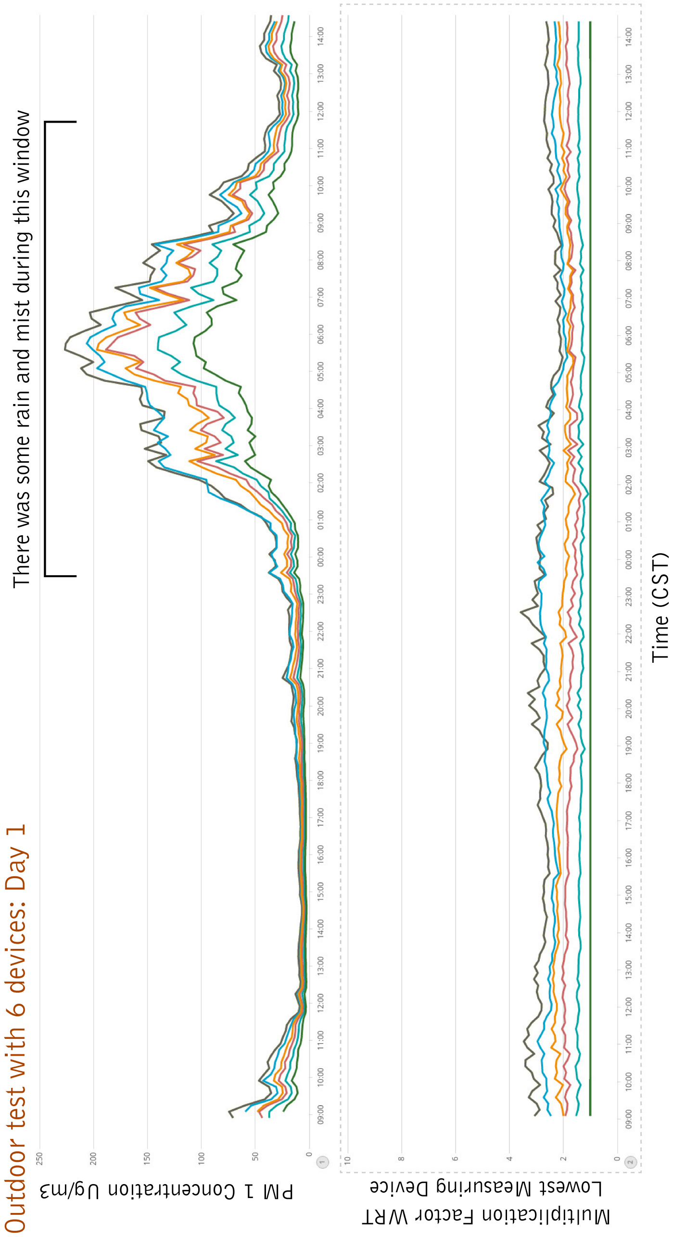
[picture p29: page 1]
