waggle-sensor/sensors/v3/integrated/tests/alphasense_opcn2/Day1_PM2.5_Outdoor.pdf

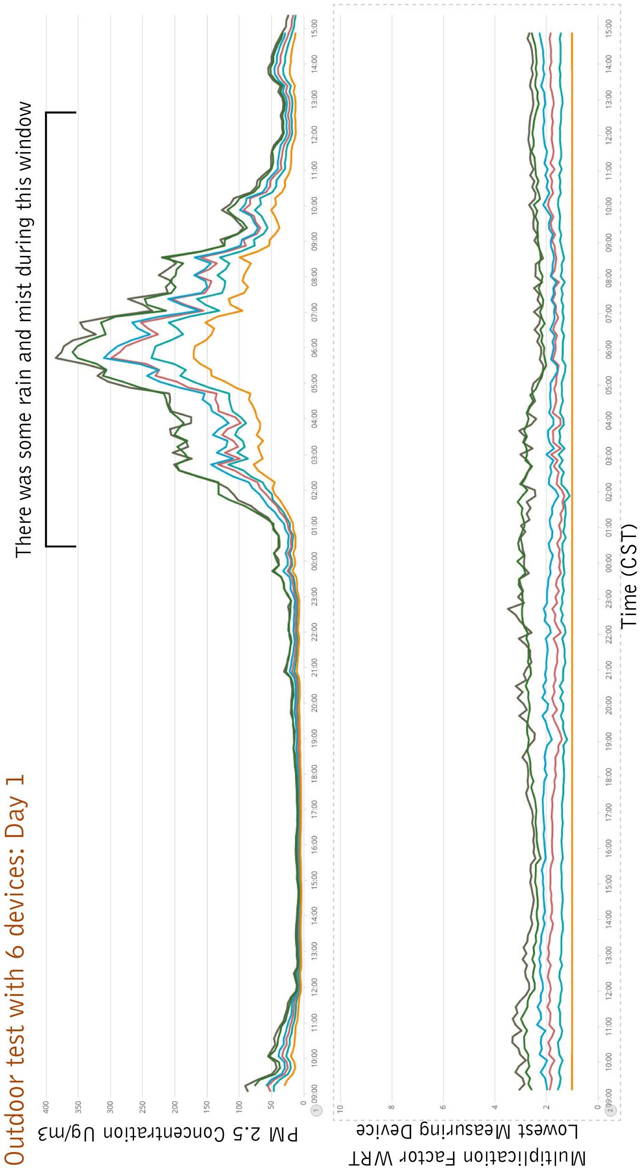
[picture p30: page 1]
