waggle-sensor/sensors/v3/integrated/tests/met_sense/combined_tests/humid_HTU21D_goretex_pod_nopod.pdf

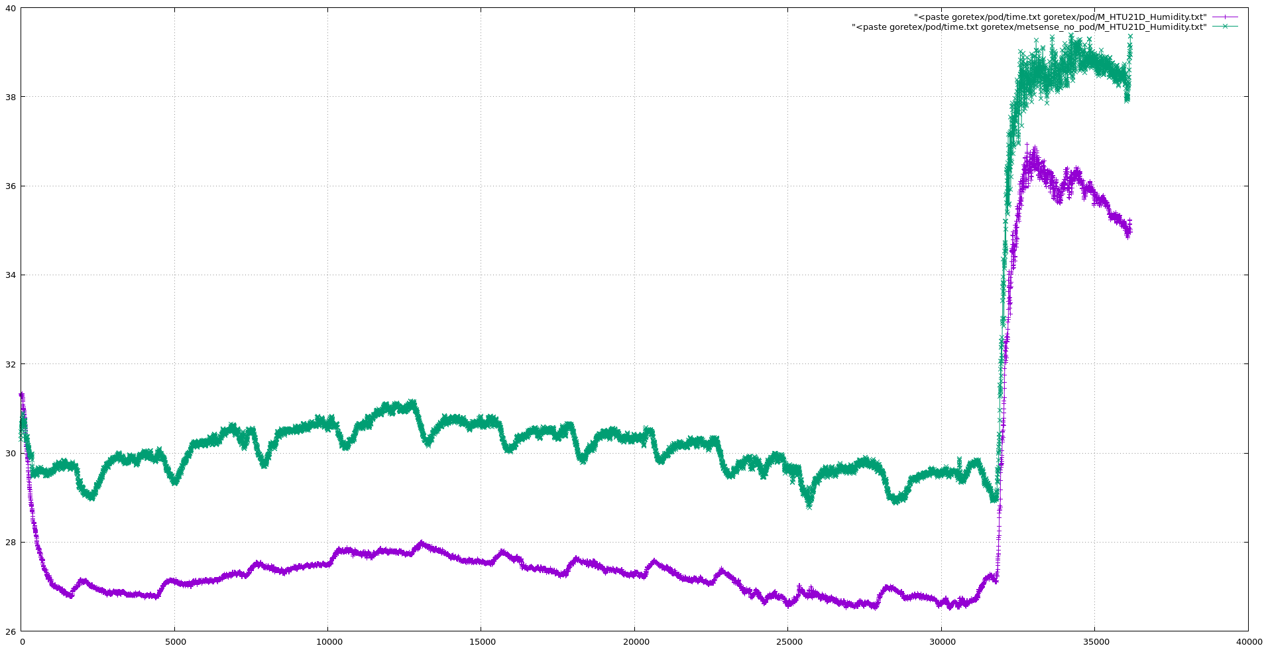
[picture p31: page 1]
