waggle-sensor/sensors/v3/integrated/tests/met_sense/combined_tests/humid_HTU21D_nogoretex_pod_nopod.pdf

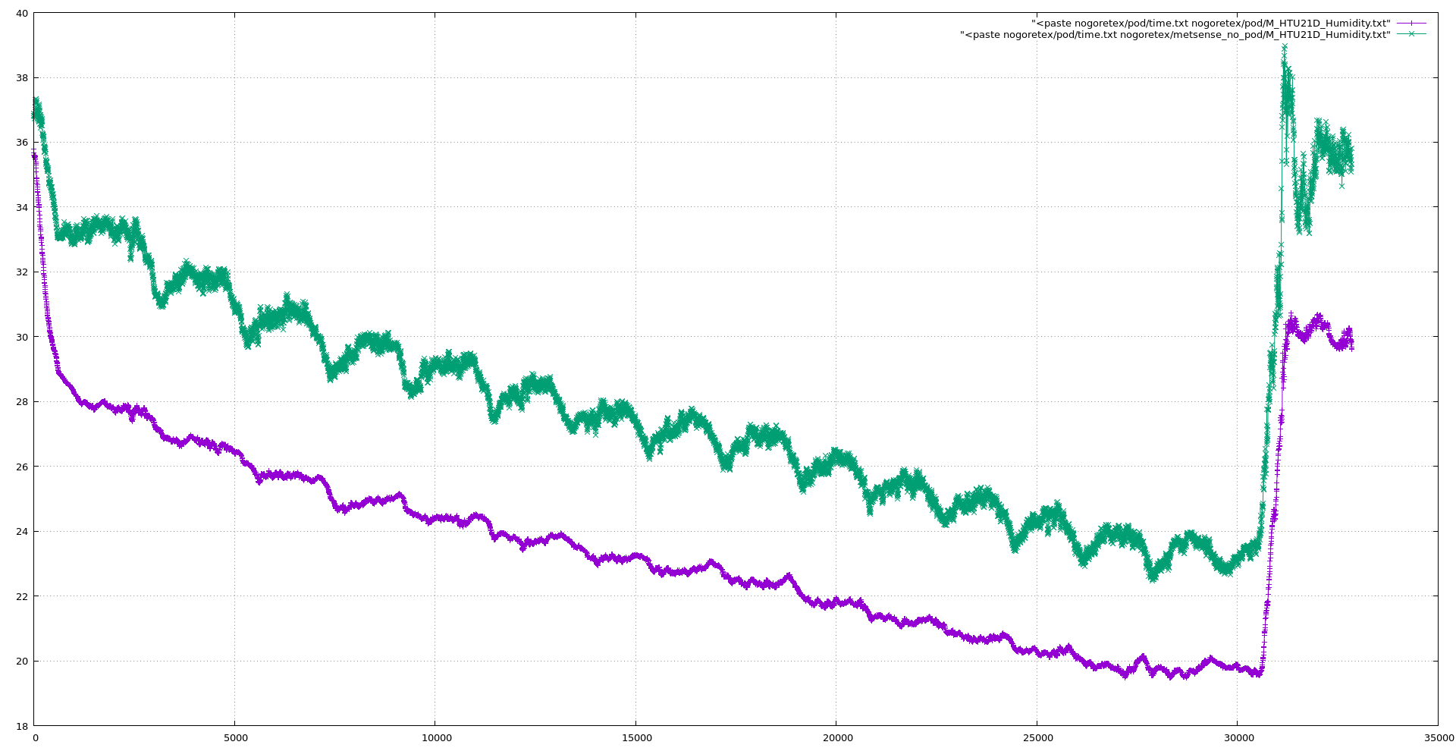
[picture p32: page 1]
