waggle-sensor/sensors/v3/integrated/tests/met_sense/combined_tests/pressure_BMP180_goretex_pod_nopod.pdf

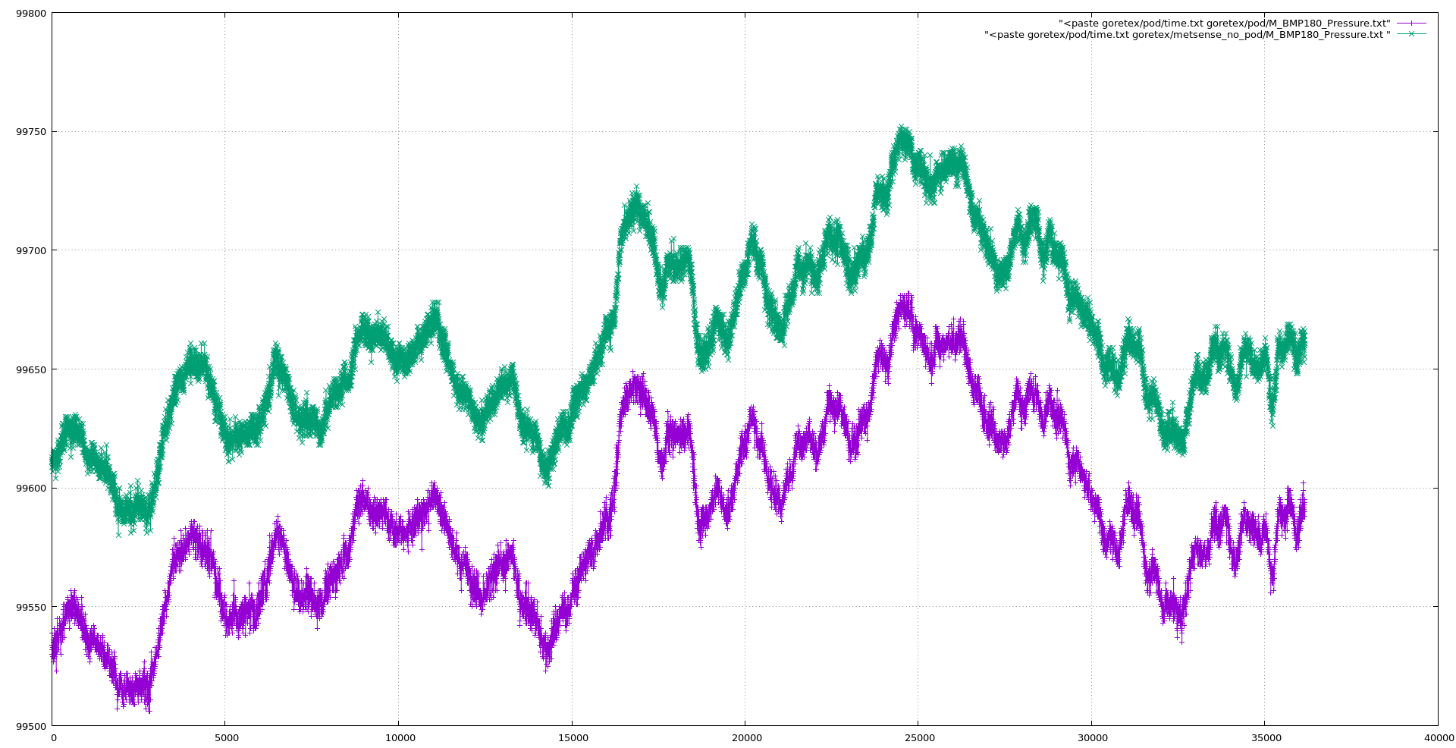
[picture p33: page 1]
