waggle-sensor/sensors/v3/integrated/tests/met_sense/combined_tests/pressure_BMP180_nogoretex_pod_nopod.pdf

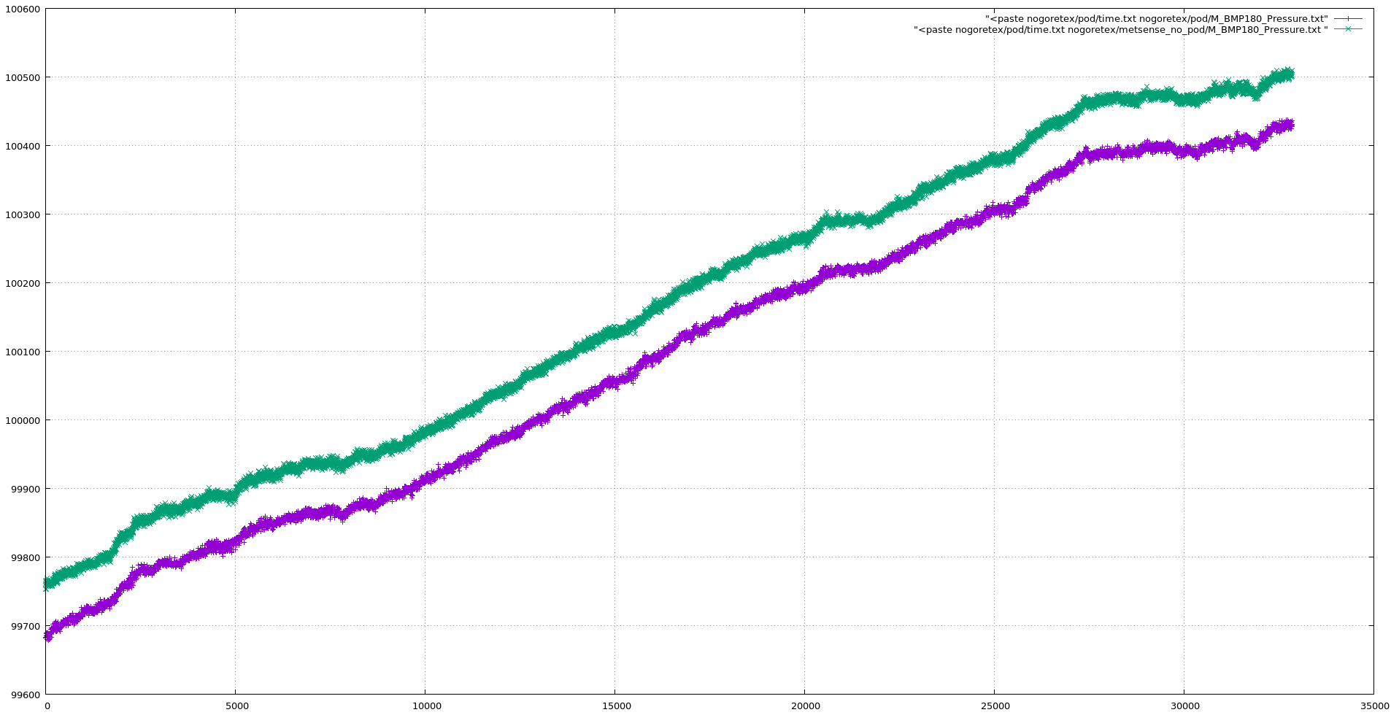
[picture p34: page 1]
