waggle-sensor/sensors/v3/integrated/tests/met_sense/combined_tests/temp_diff_with_goretex.pdf

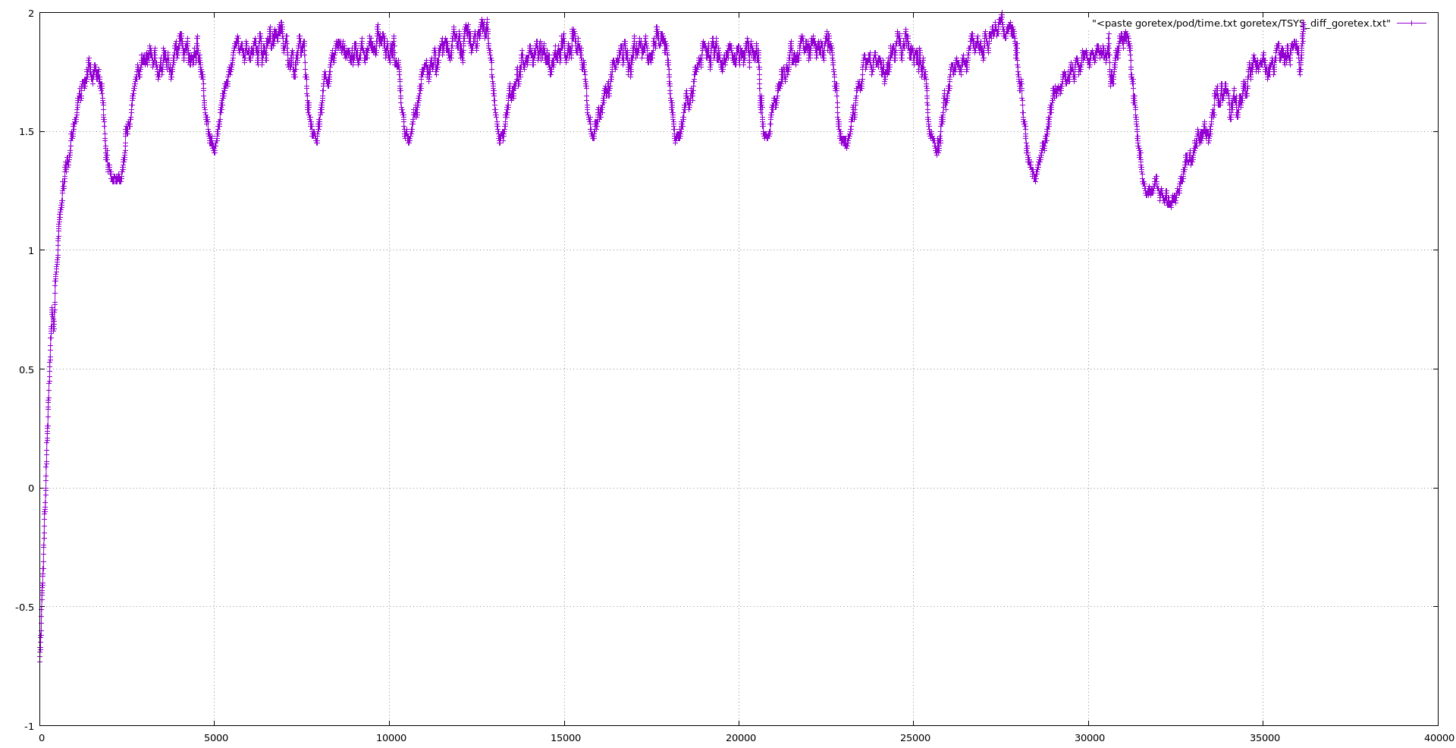
[picture p35: page 1]
