waggle-sensor/sensors/v3/integrated/tests/met_sense/combined_tests/temp_diff_with_nogoretex.pdf

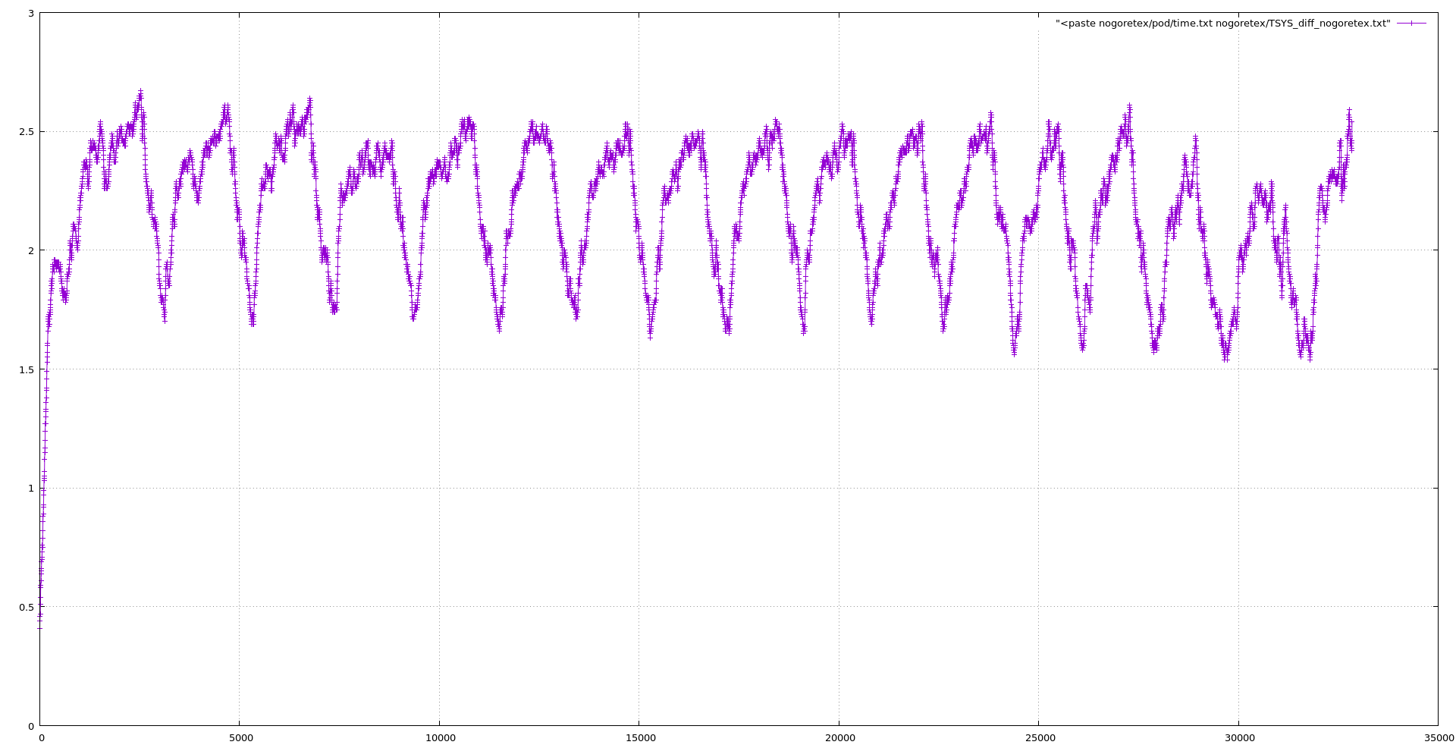
[picture p36: page 1]
