waggle-sensor/sensors/v3/integrated/tests/met_sense/combined_tests/temp_TSYS_goretex_pod_nopod.pdf

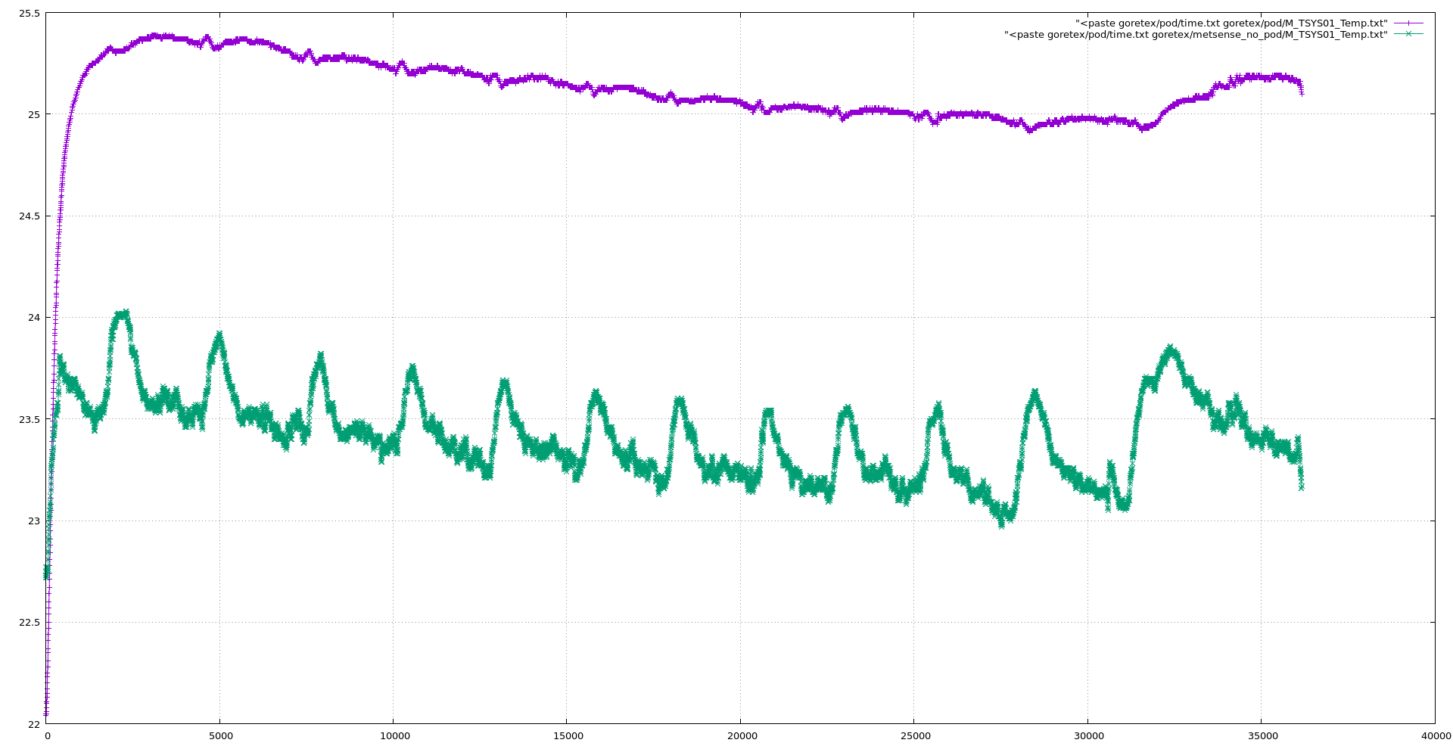
[picture p37: page 1]
