waggle-sensor/sensors/v3/integrated/tests/met_sense/combined_tests/temp_TSYS_nogoretex_pod_nopod.pdf

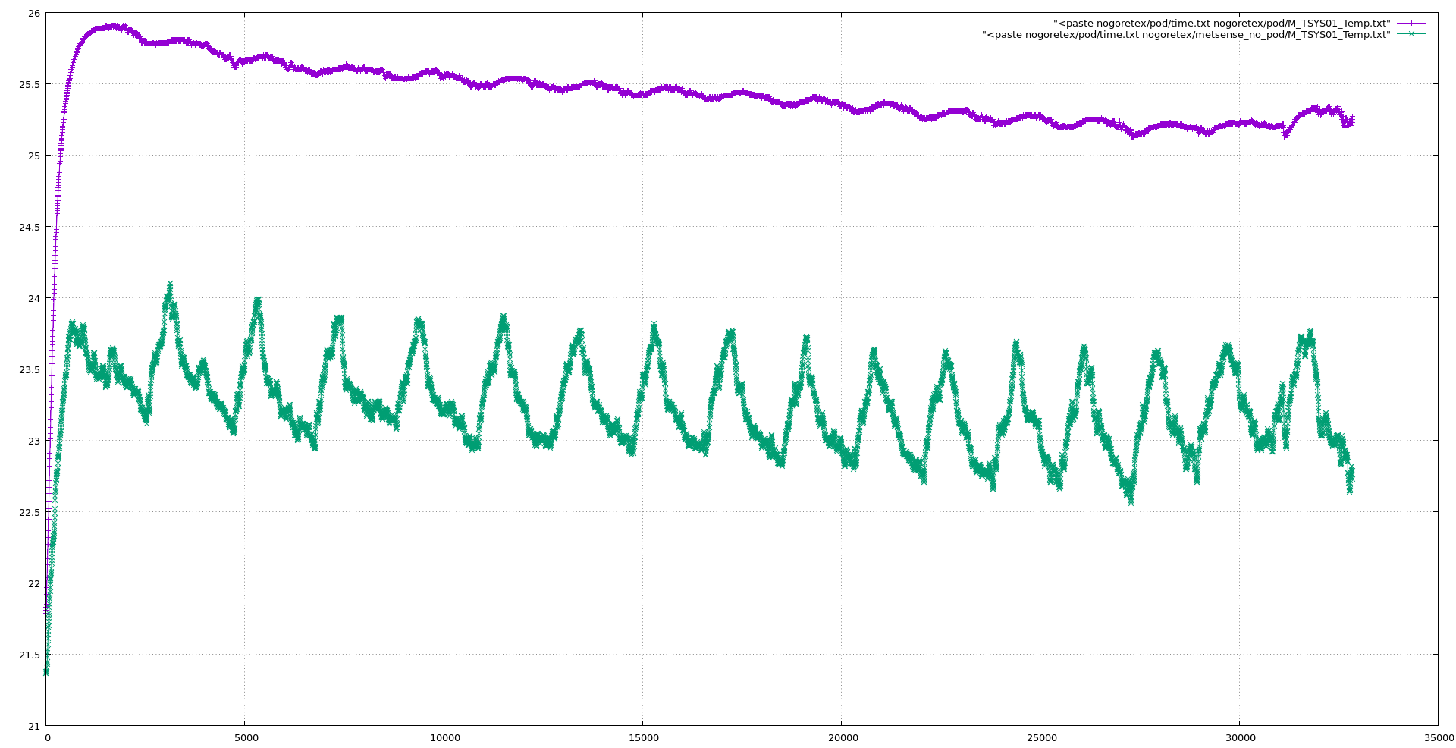
[picture p38: page 1]
