waggle-sensor/sensors/v3/integrated/tests/met_sense/board_tests/cold_boot_short_test/ATM_Pressure.pdf

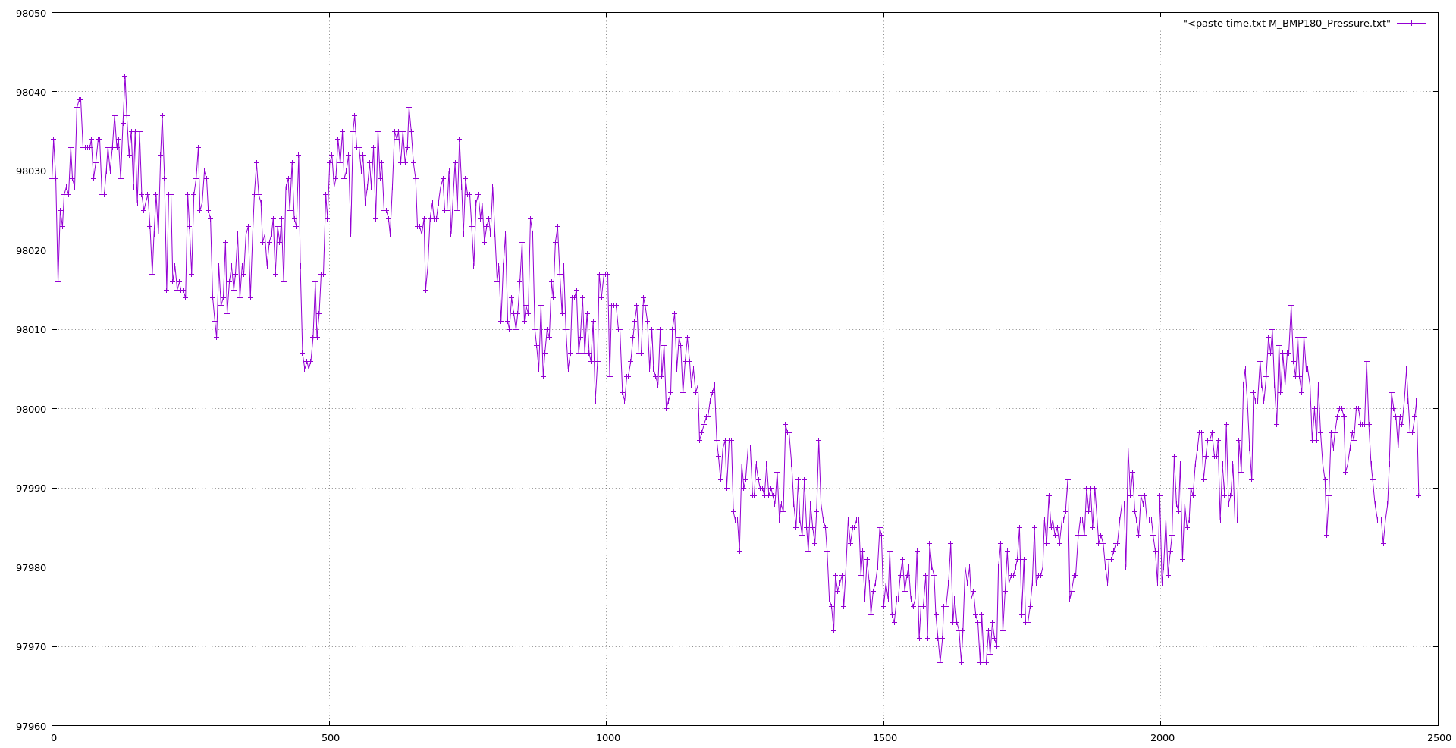
[picture p39: page 1]
