waggle-sensor/sensors/v3/integrated/tests/met_sense/board_tests/cold_boot_short_test/HTU_TSYS_Temp_Diff.pdf

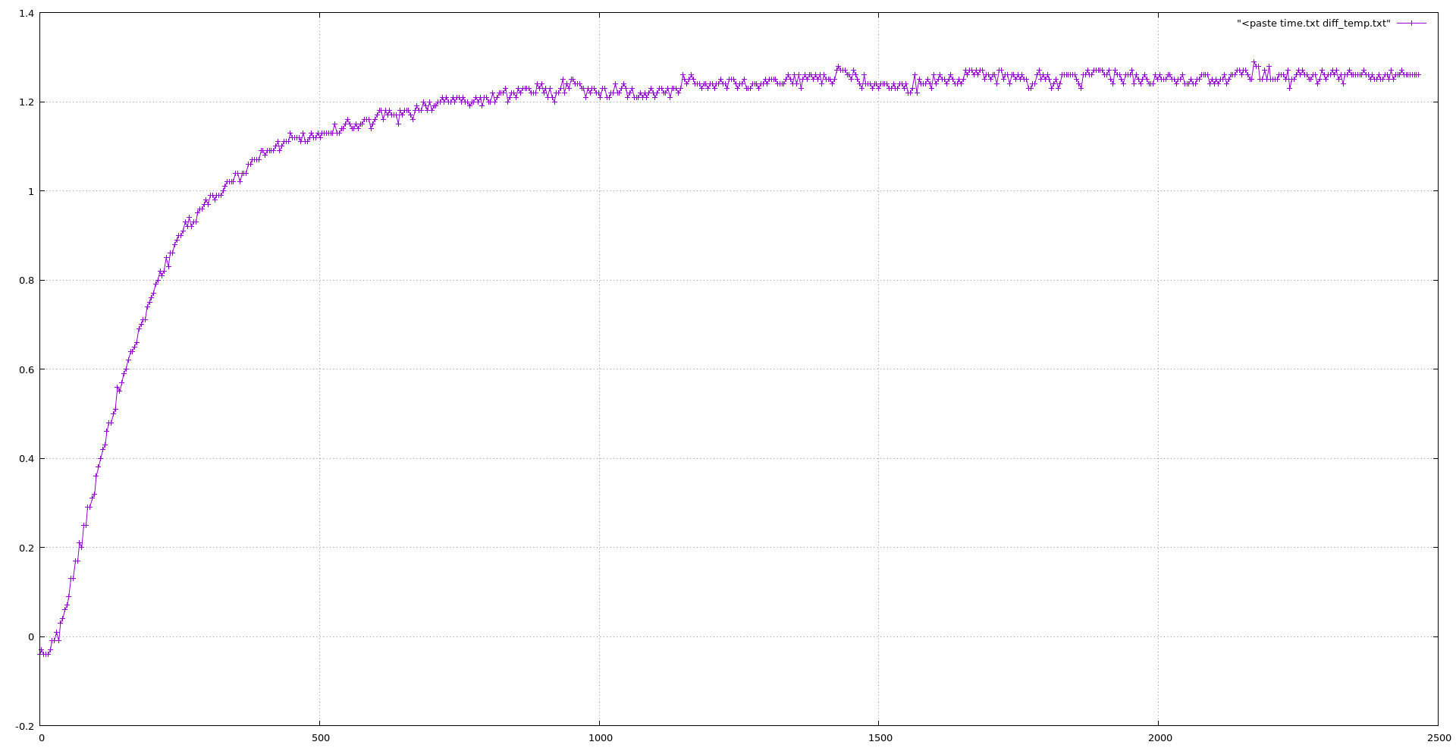
[picture p40: page 1]
