waggle-sensor/sensors/v3/integrated/tests/met_sense/board_tests/cold_boot_short_test/Humidity.pdf

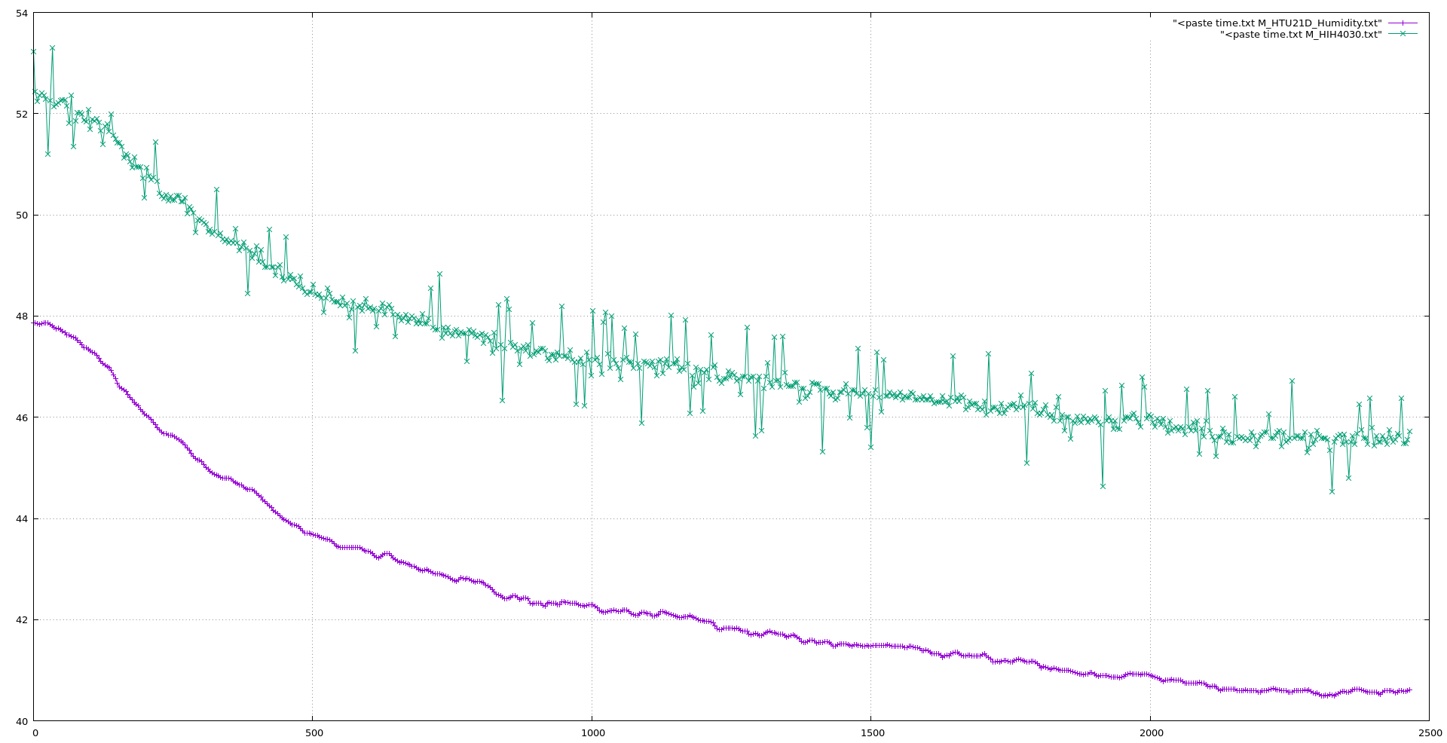
[picture p41: page 1]
