waggle-sensor/sensors/v3/integrated/tests/met_sense/board_tests/cold_boot_short_test/Temp_Humid_Delta.pdf

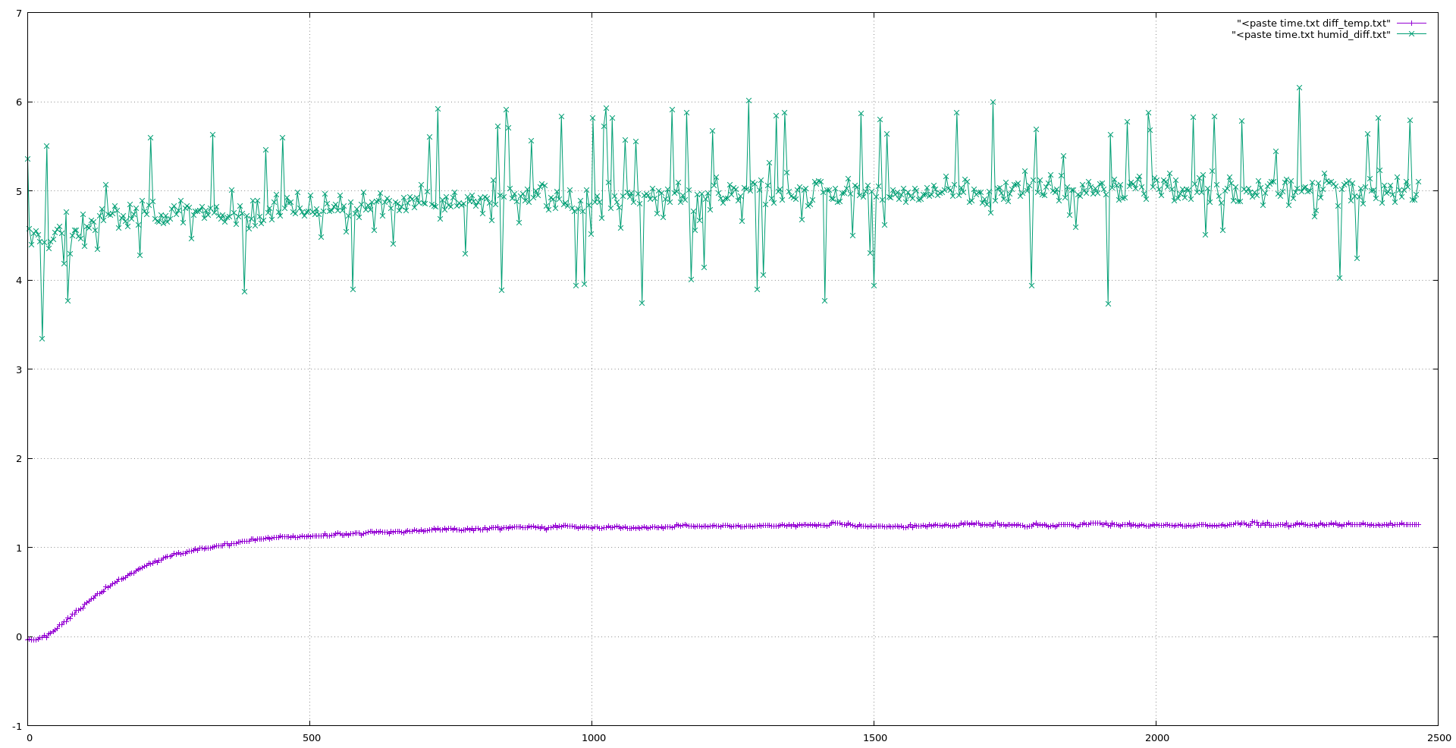
[picture p42: page 1]
