waggle-sensor/sensors/v3/integrated/tests/met_sense/board_tests/cold_boot_short_test/Temp_initial.pdf

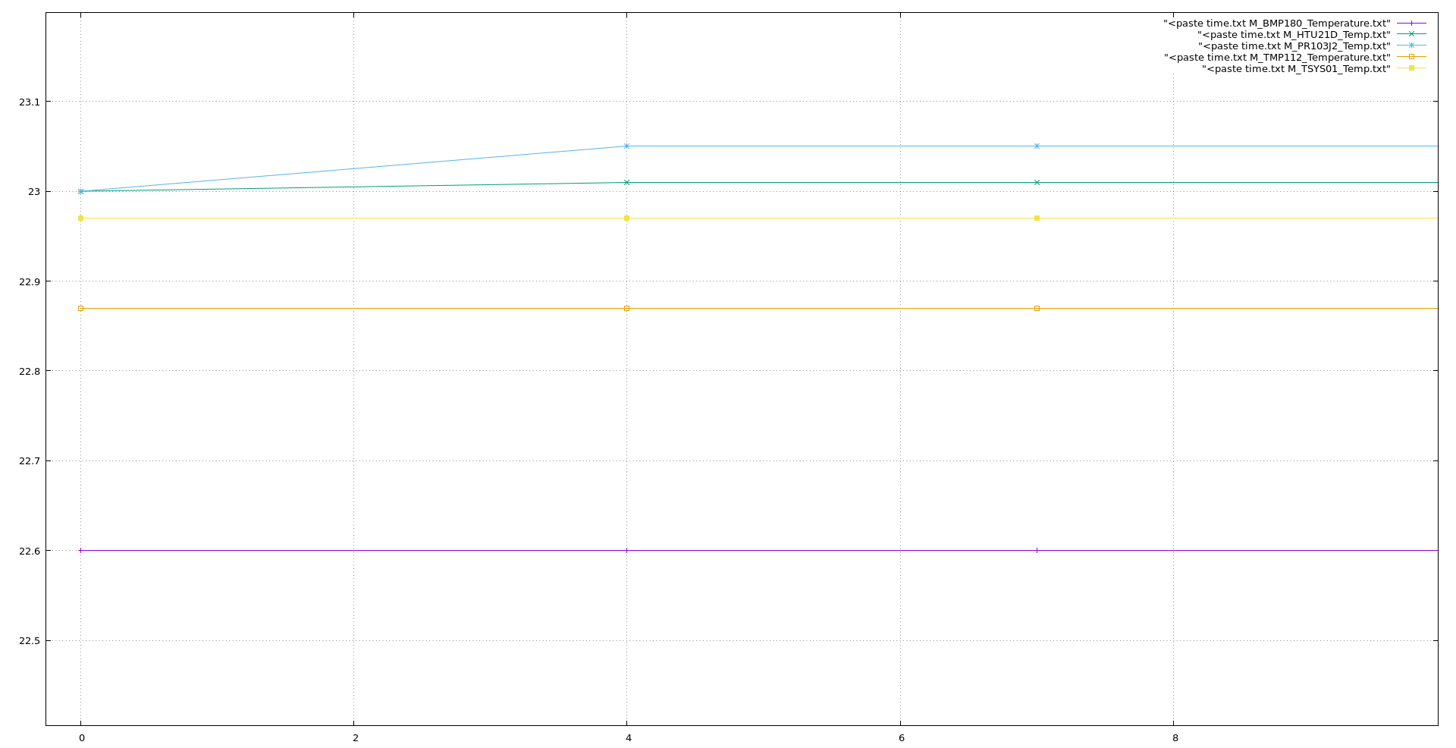
[picture p43: page 1]
