waggle-sensor/sensors/v3/integrated/tests/met_sense/board_tests/cold_boot_short_test/Temp_initial_Divergence.pdf

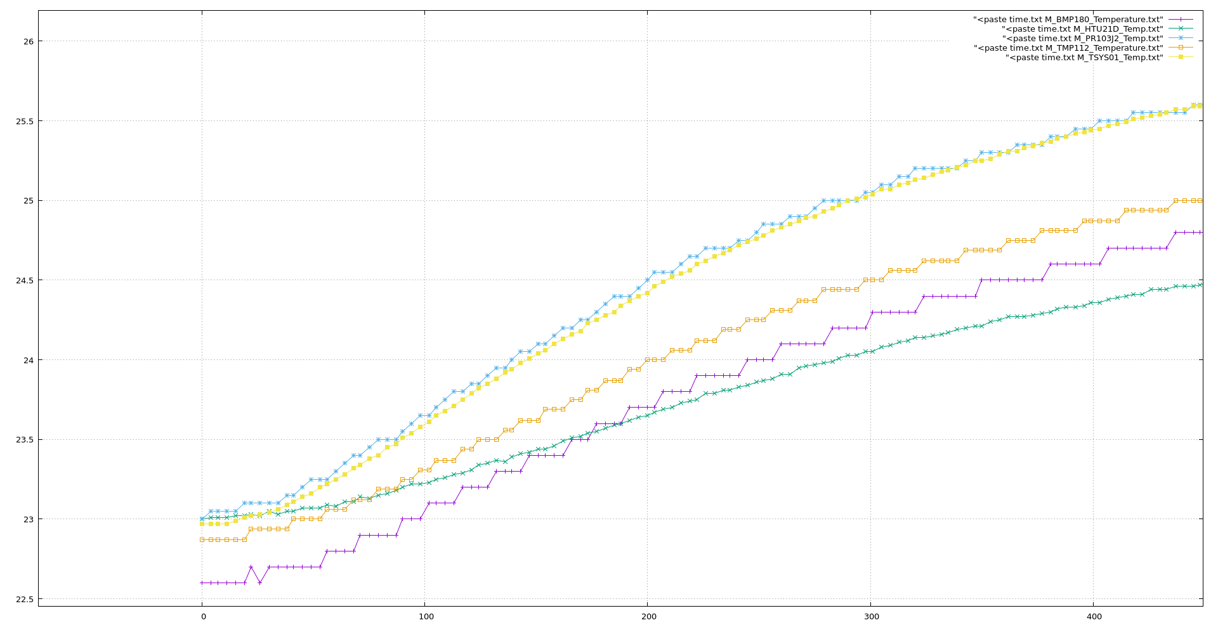
[picture p44: page 1]
