waggle-sensor/sensors/v3/integrated/tests/met_sense/board_tests/cold_boot_short_test/Temperature.pdf

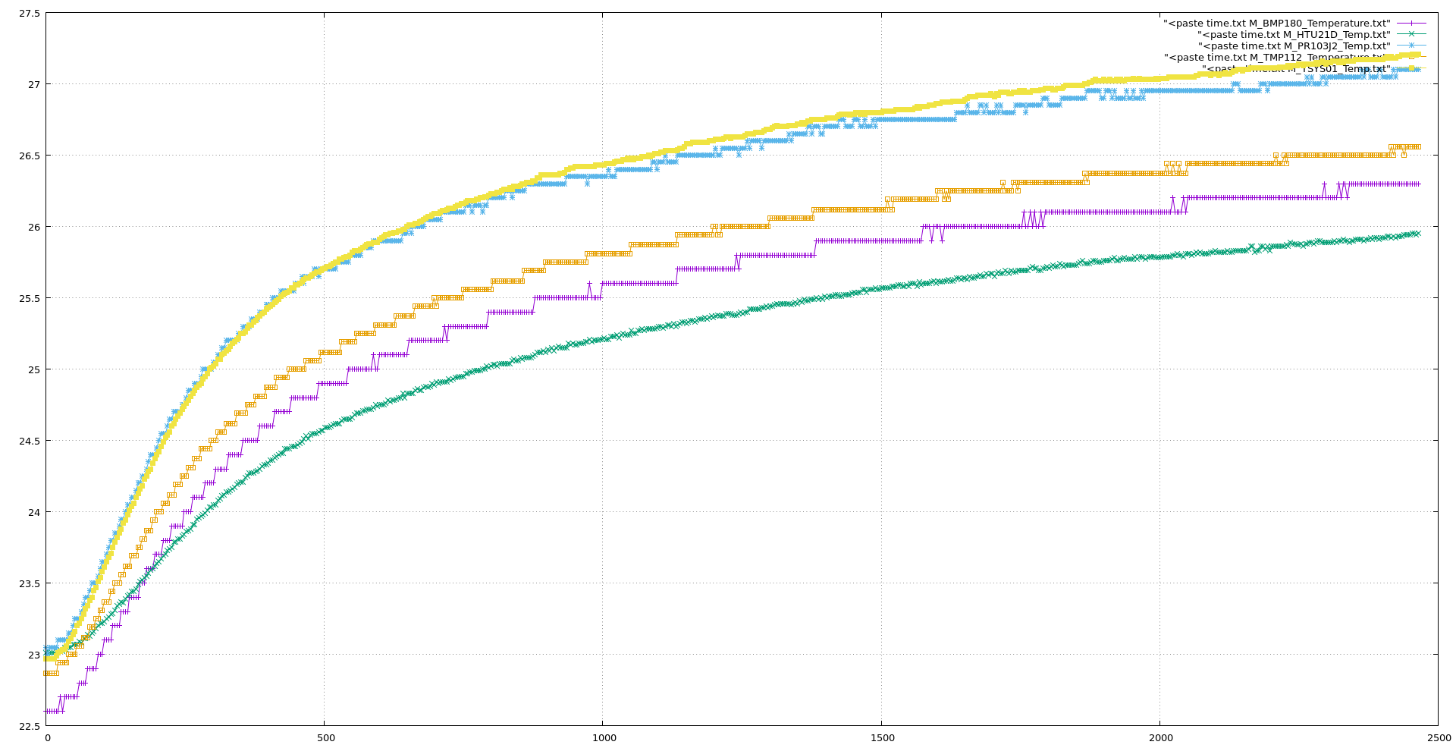
[picture p45: page 1]
