waggle-sensor/sensors/v3/integrated/tests/met_sense/board_tests/freezer_test/HTU_TSYS_Temp_Diff.pdf

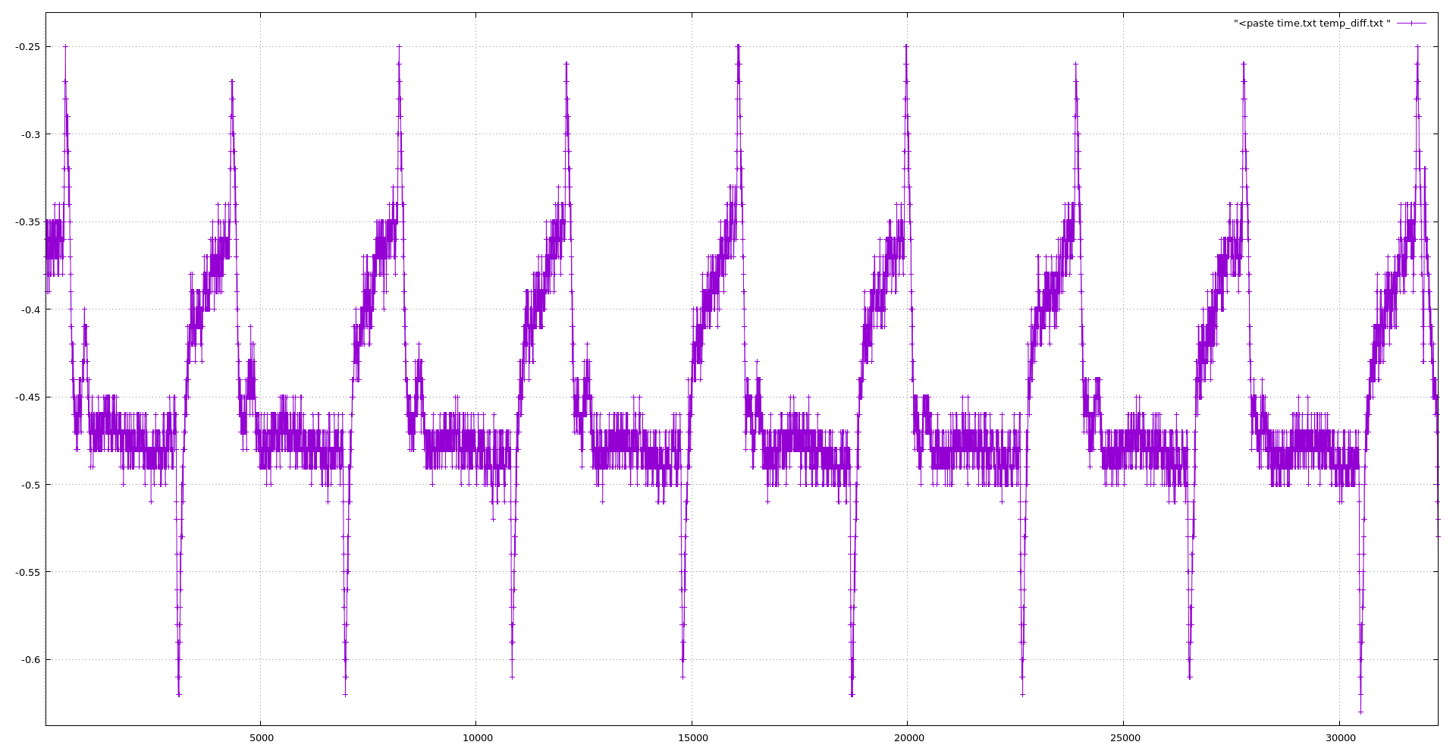
[picture p46: page 1]
