waggle-sensor/sensors/v3/integrated/tests/met_sense/board_tests/freezer_test/Humidity.pdf

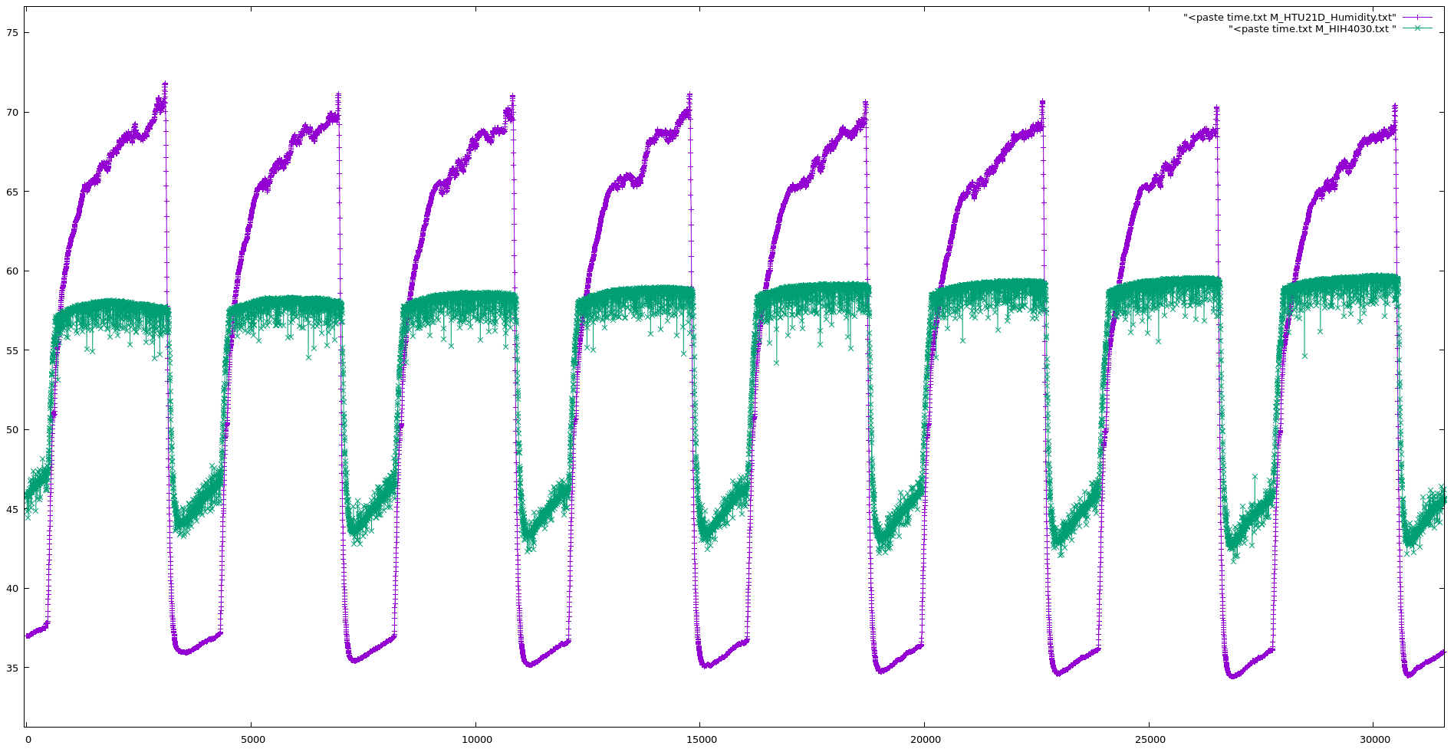
[picture p47: page 1]
