waggle-sensor/sensors/v3/integrated/tests/met_sense/board_tests/freezer_test/Humidity_Cycle.pdf

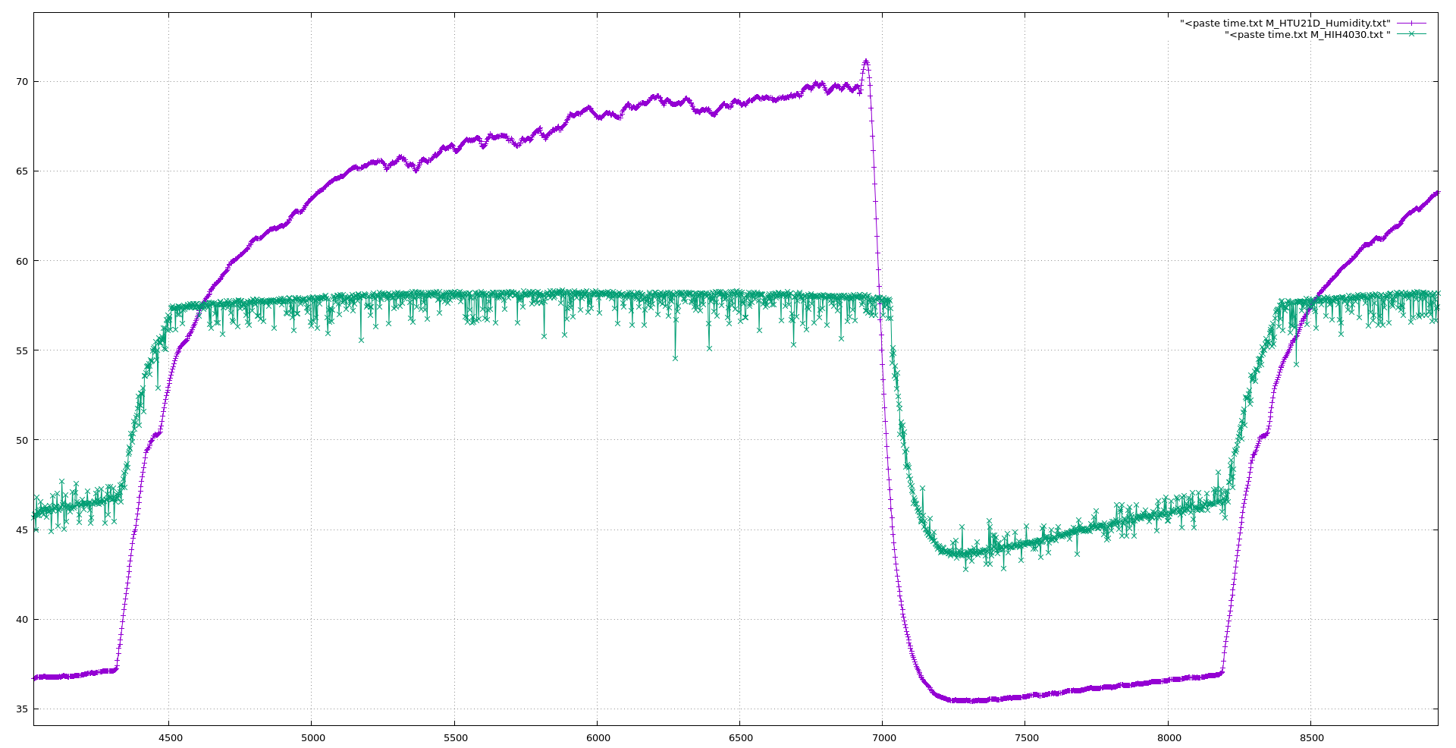
[picture p48: page 1]
