waggle-sensor/sensors/v3/integrated/tests/met_sense/board_tests/freezer_test/Temperature.pdf

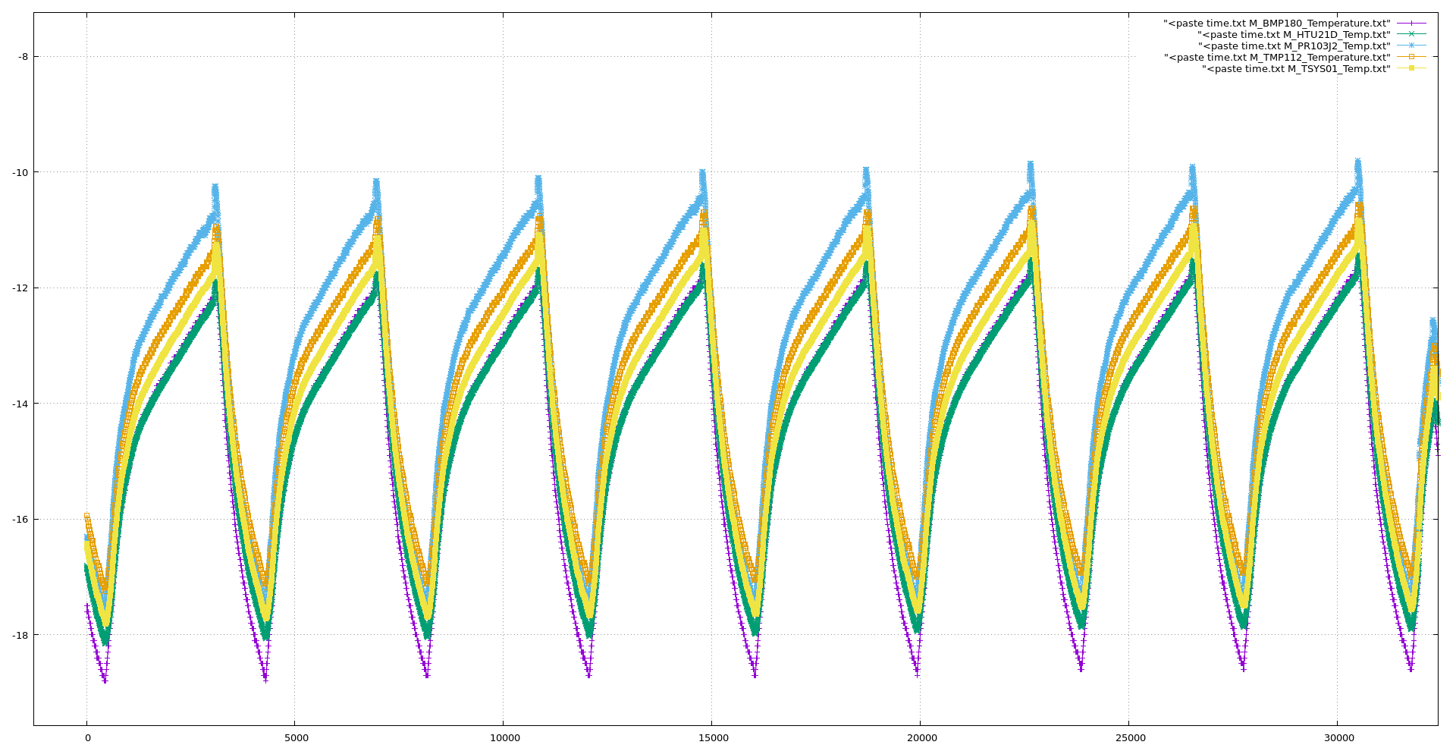
[picture p49: page 1]
