waggle-sensor/sensors/v3/integrated/tests/met_sense/board_tests/freezer_test/Temperature_cycle.pdf

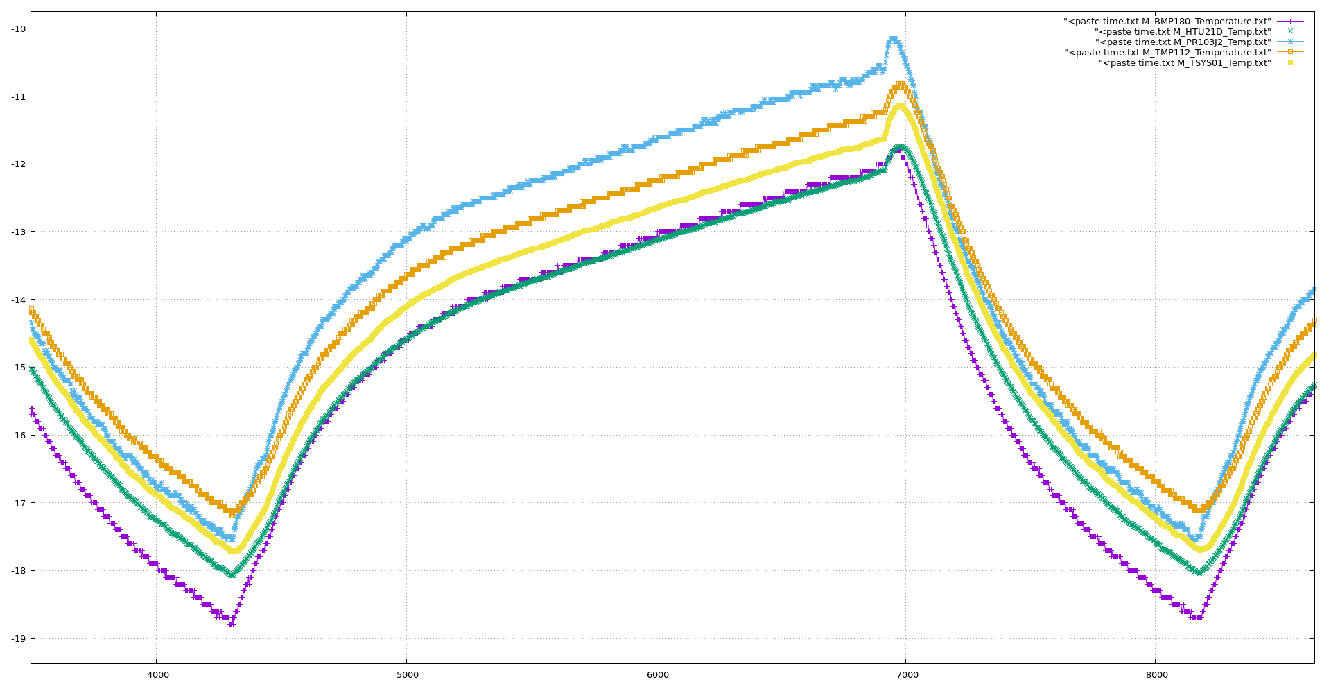
[picture p50: page 1]
