waggle-sensor/sensors/v3/integrated/tests/met_sense/board_tests/freezer_test/Temperature_diff_close_up.pdf

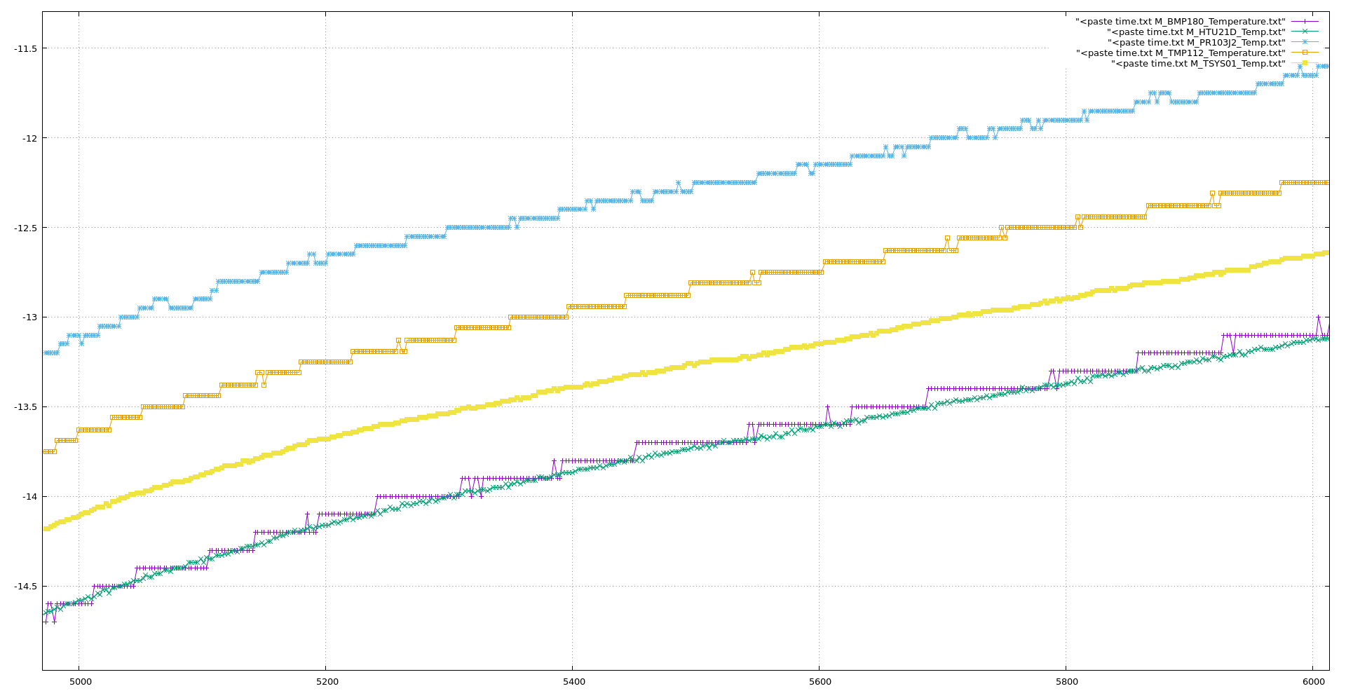
[picture p51: page 1]
