waggle-sensor/sensors/v3/integrated/tests/met_sense/board_tests/freezer_test/Tempereature_initial.pdf

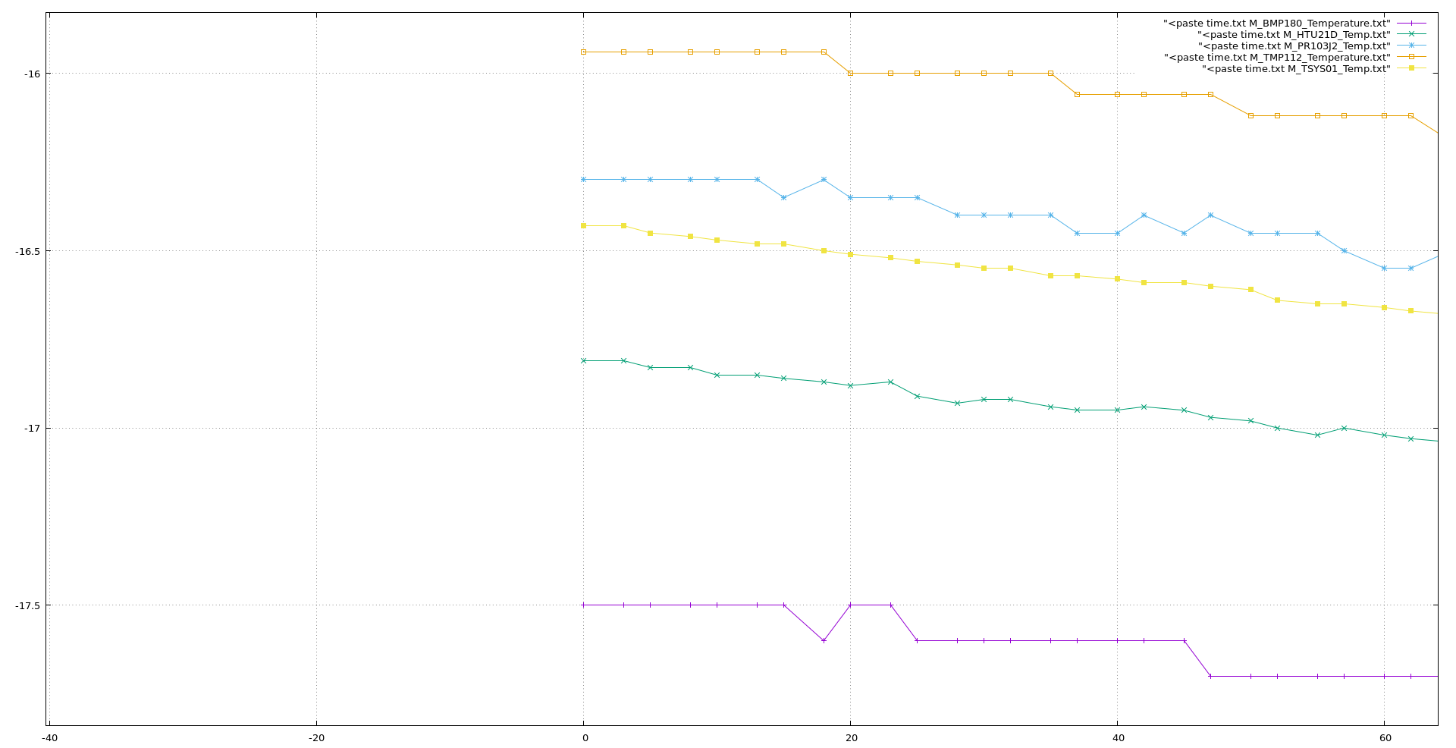
[picture p52: page 1]
