waggle-sensor/sensors/v3/integrated/tests/met_sense/board_tests/heater_test/ATM_Barometric.pdf

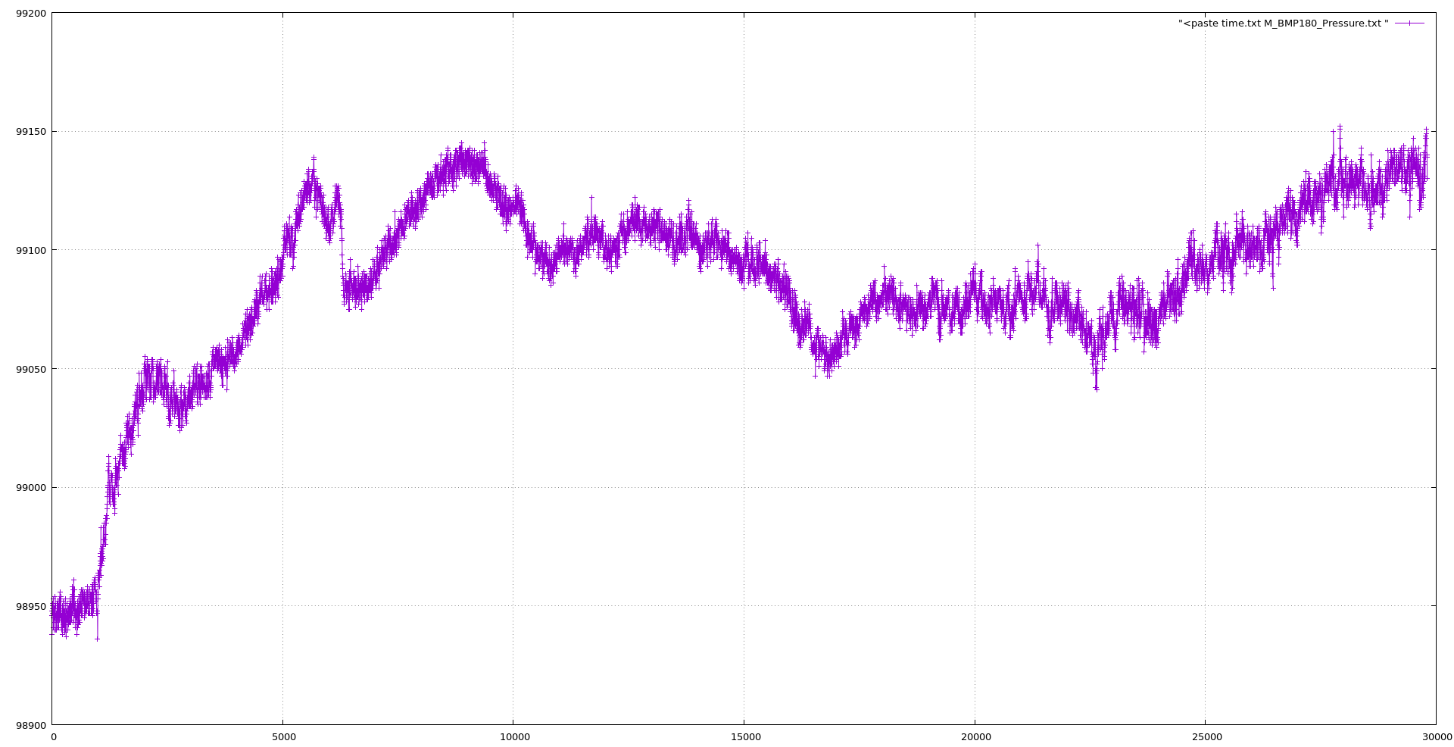
[picture p53: page 1]
