waggle-sensor/sensors/v3/integrated/tests/met_sense/board_tests/heater_test/Humidity.pdf

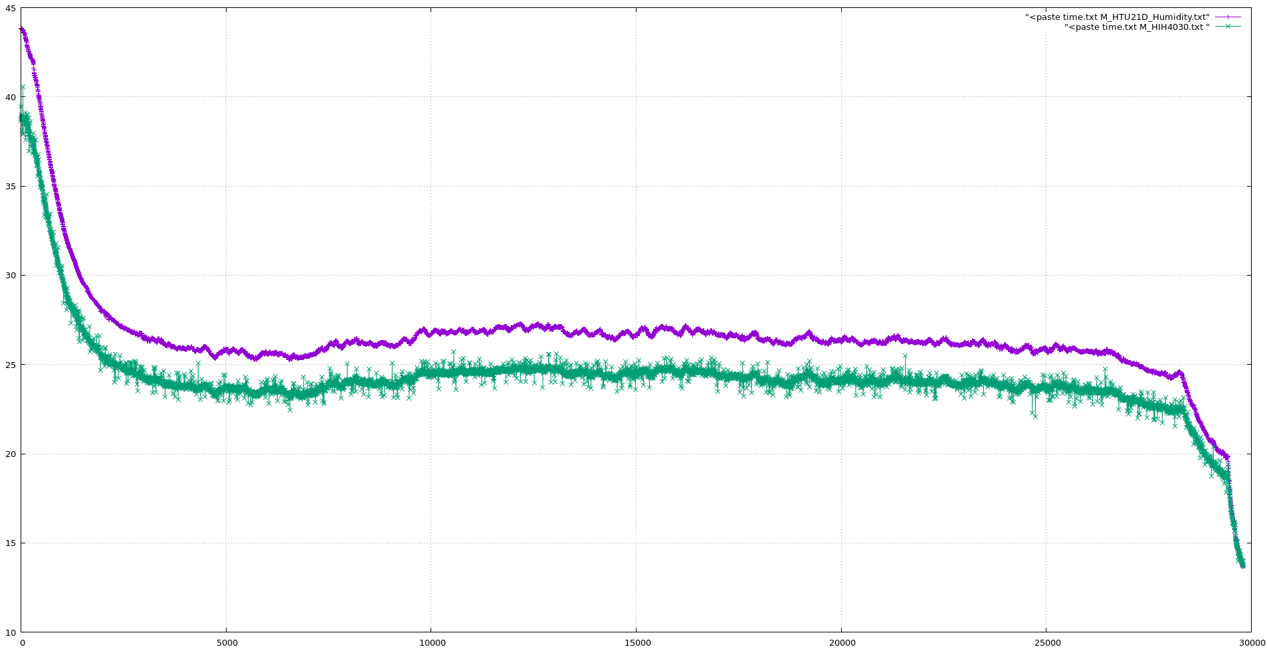
[picture p54: page 1]
