waggle-sensor/sensors/v3/integrated/tests/met_sense/board_tests/heater_test/Humidity_fall_on_heating_quickly.pdf

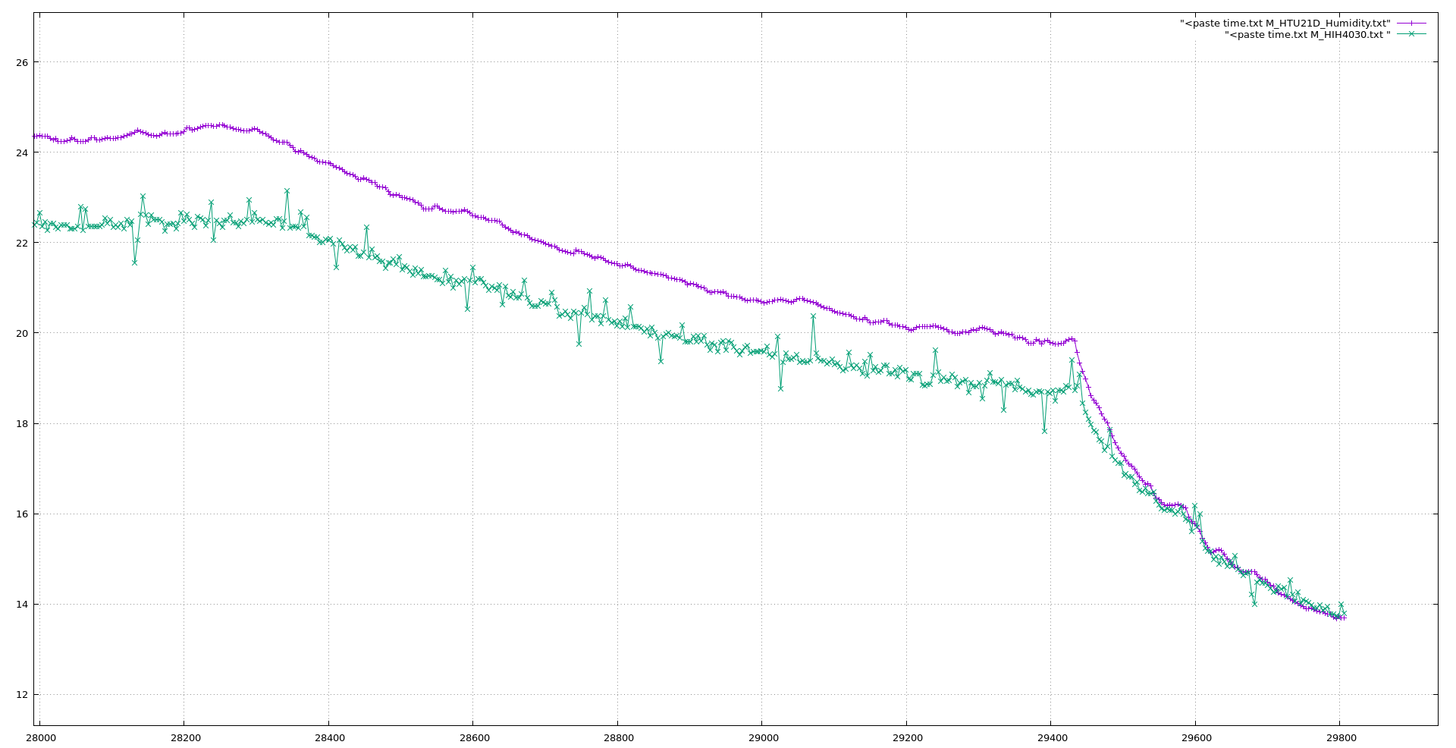
[picture p55: page 1]
