waggle-sensor/sensors/v3/integrated/tests/met_sense/board_tests/heater_test/Humidity_Initial.pdf

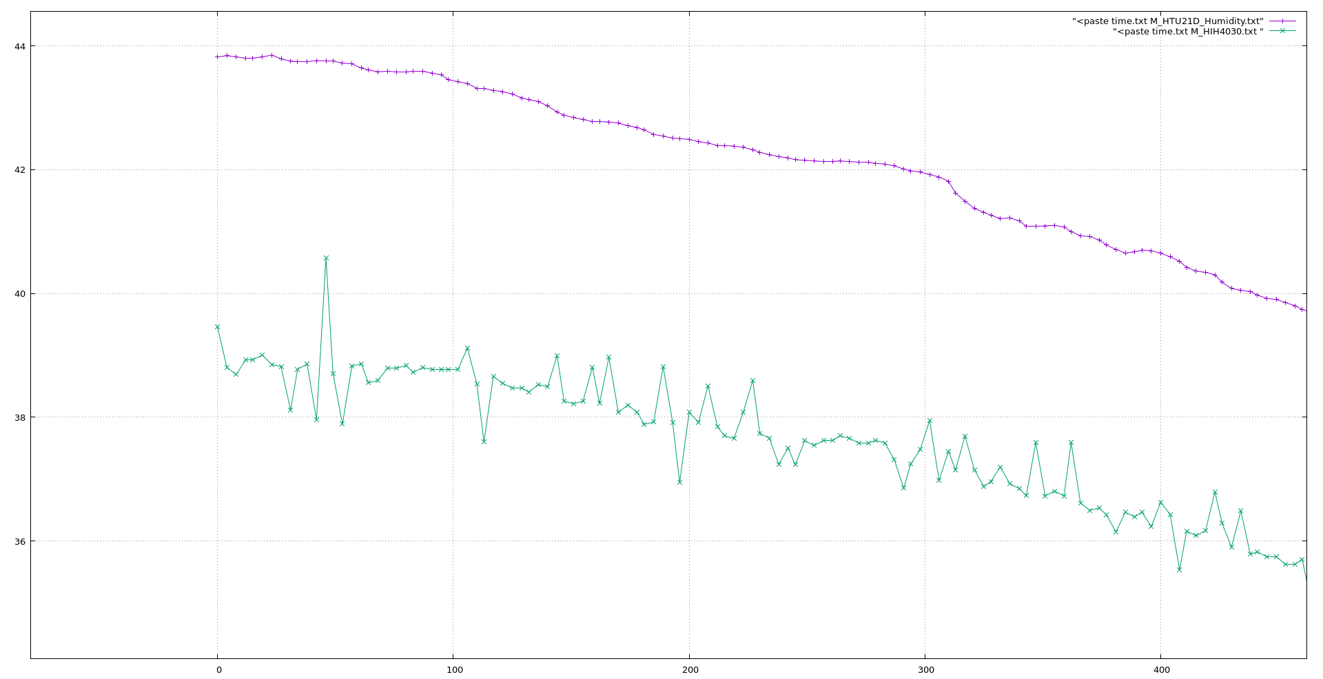
[picture p56: page 1]
