waggle-sensor/sensors/v3/integrated/tests/met_sense/board_tests/heater_test/Temp_quick_raise.pdf

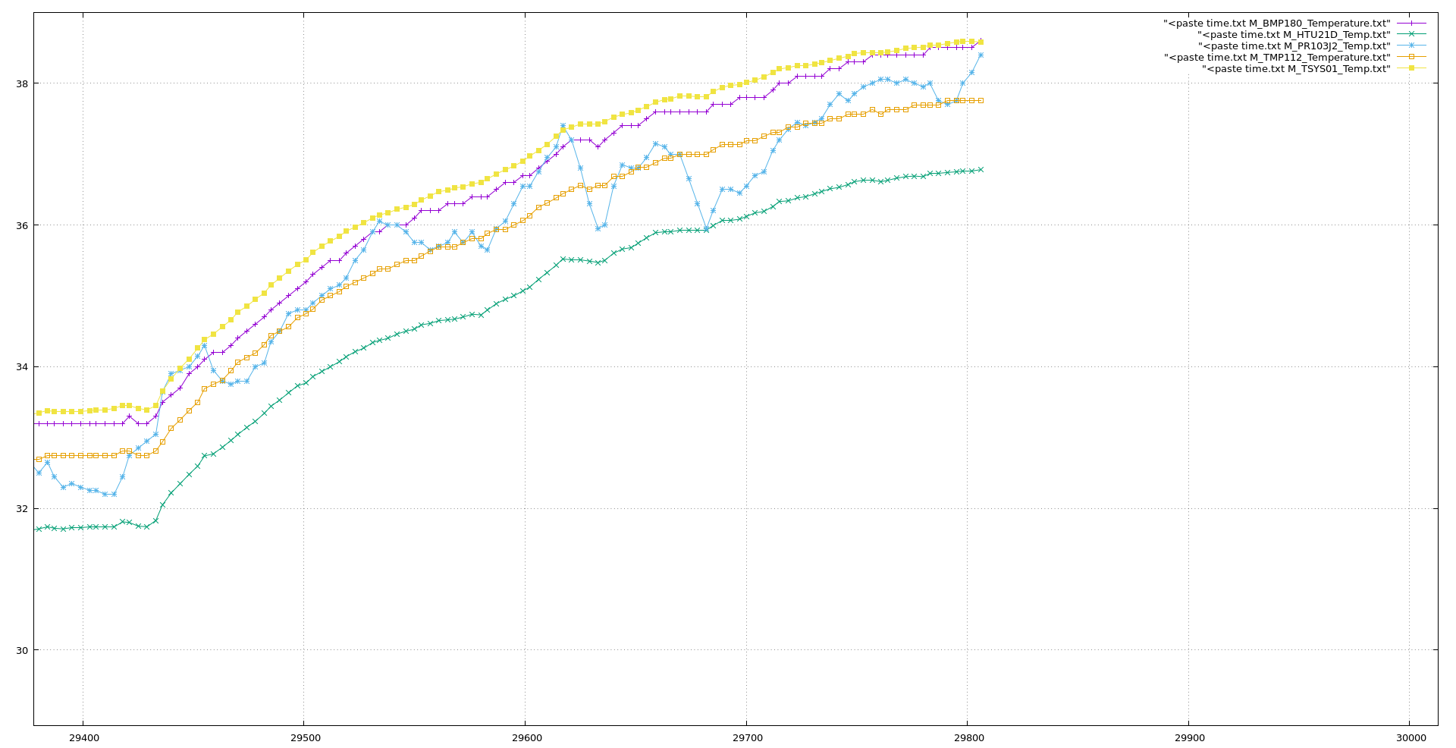
[picture p57: page 1]
