waggle-sensor/sensors/v3/integrated/tests/met_sense/board_tests/heater_test/Temperate_stable_segment.pdf

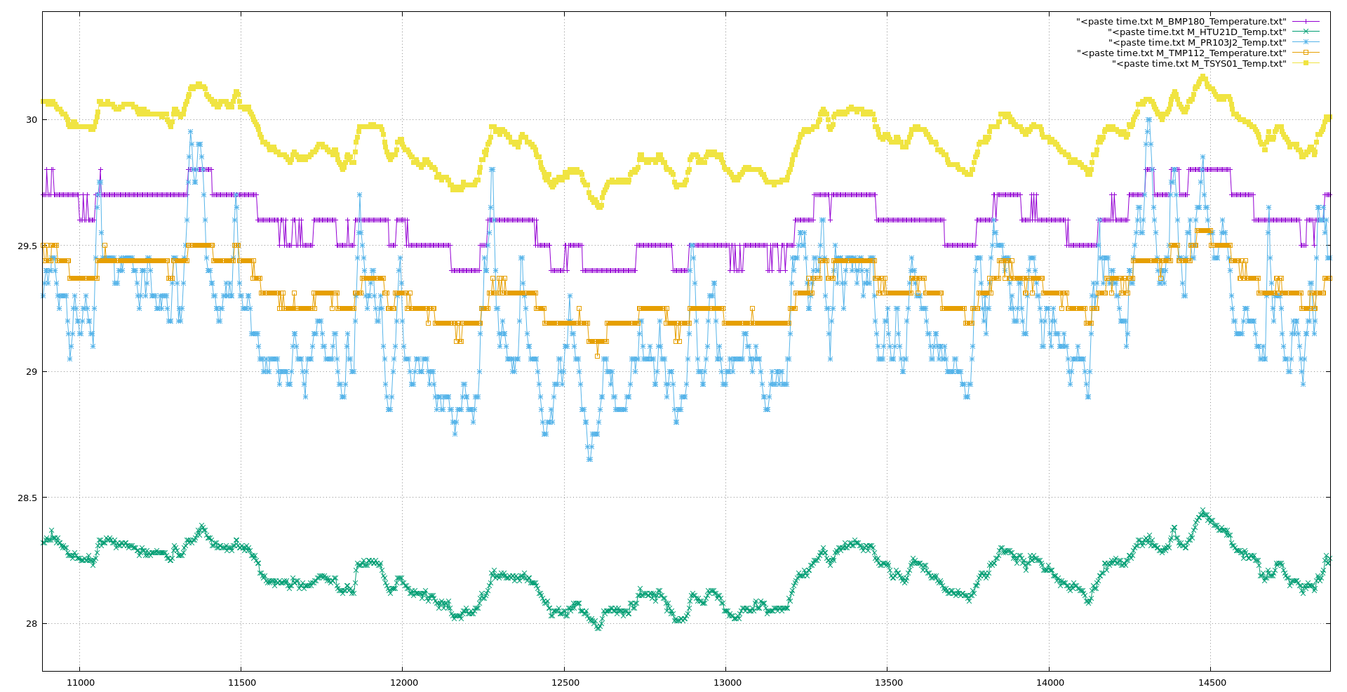
[picture p58: page 1]
