waggle-sensor/sensors/v3/integrated/tests/met_sense/board_tests/heater_test/Temperature.pdf

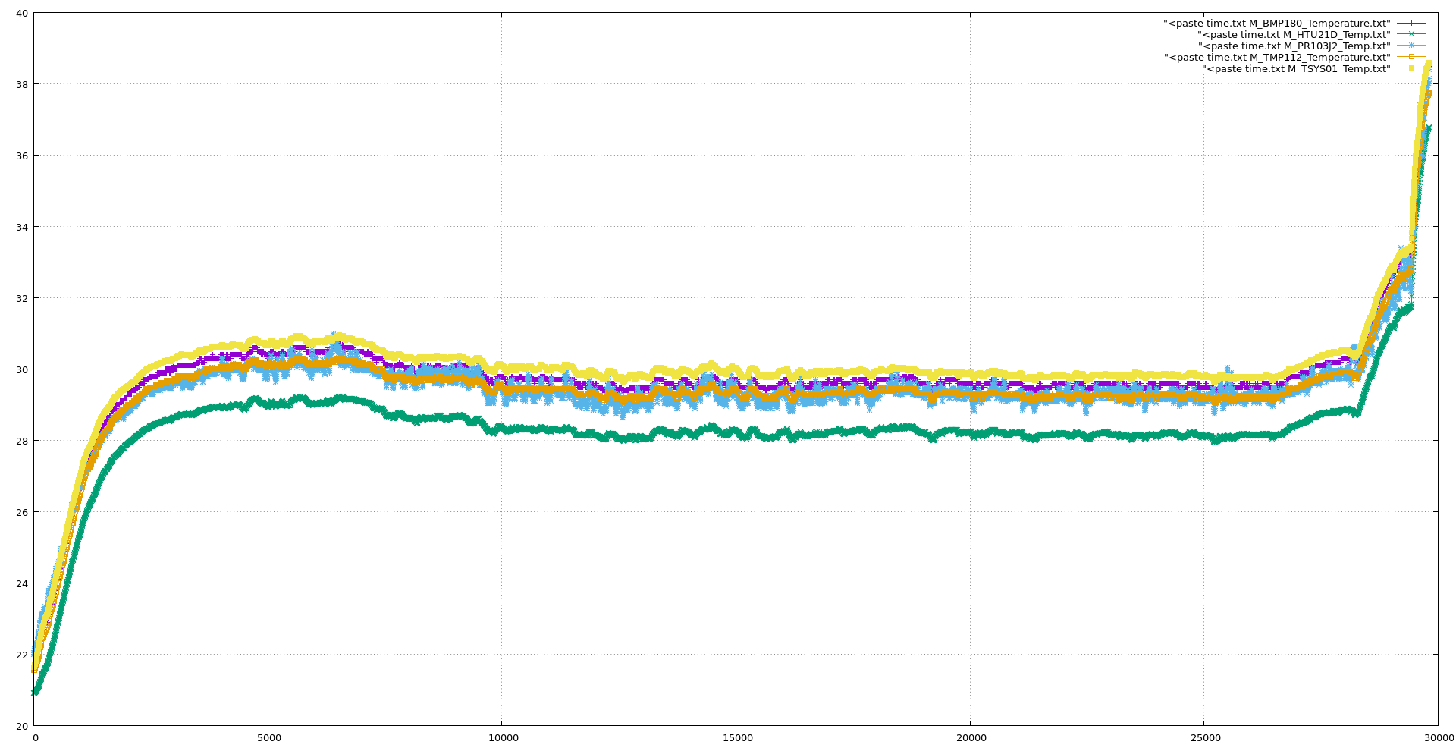
[picture p59: page 1]
