waggle-sensor/sensors/v3/integrated/tests/met_sense/board_tests/heater_test/Temperature_diff.pdf

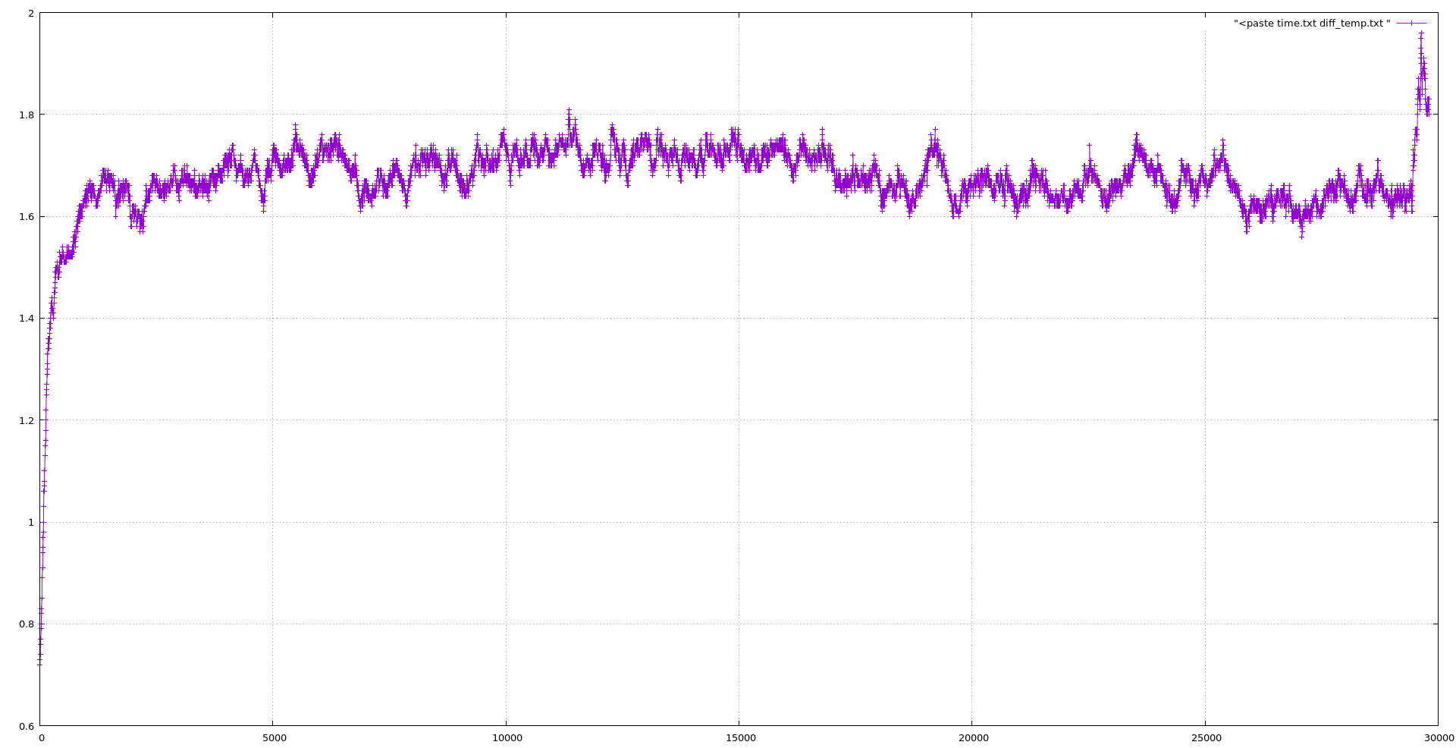
[picture p60: page 1]
