waggle-sensor/sensors/v3/integrated/tests/met_sense/board_tests/heater_test/Temperature_Raise1.pdf

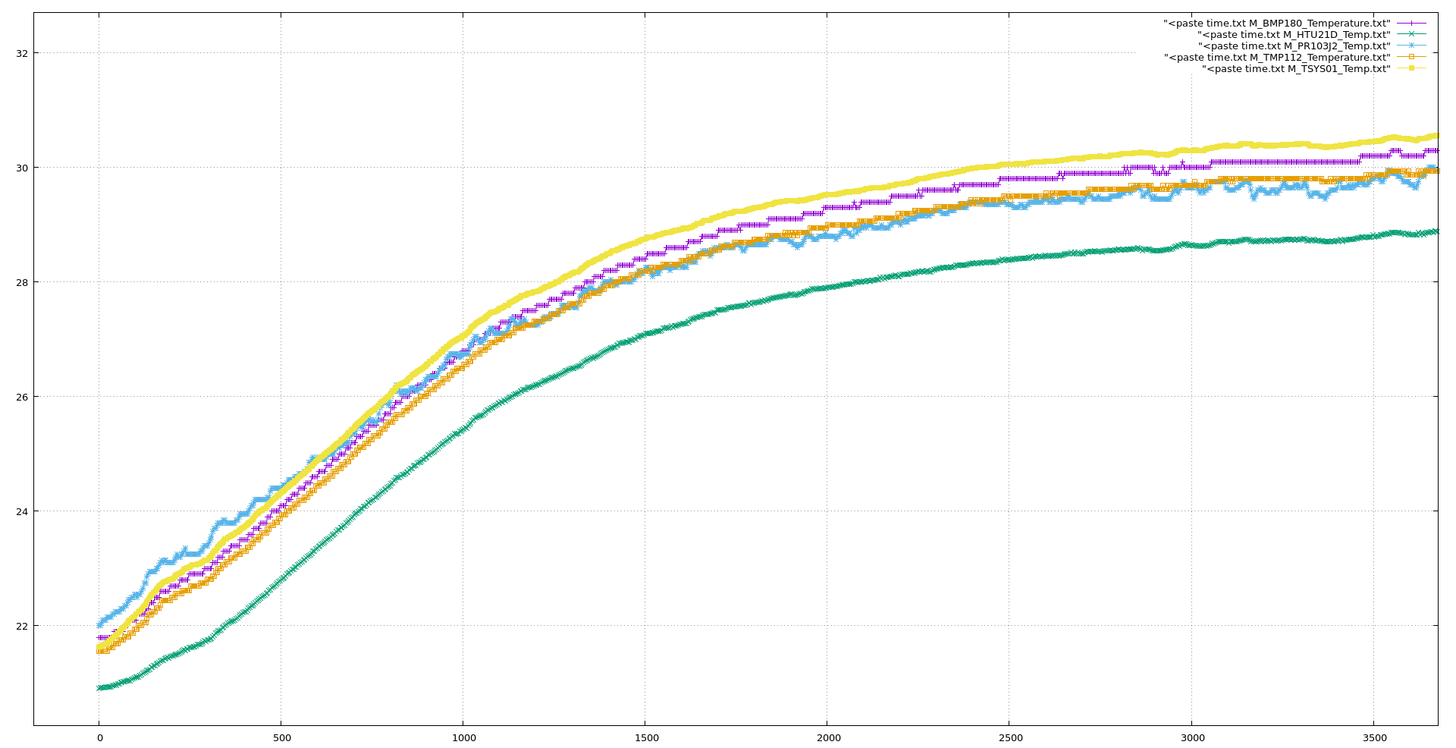
[picture p61: page 1]
