waggle-sensor/sensors/v3/integrated/tests/met_sense/pod_tests/longterm_pod_coldboot_test/ATM_pressure.pdf

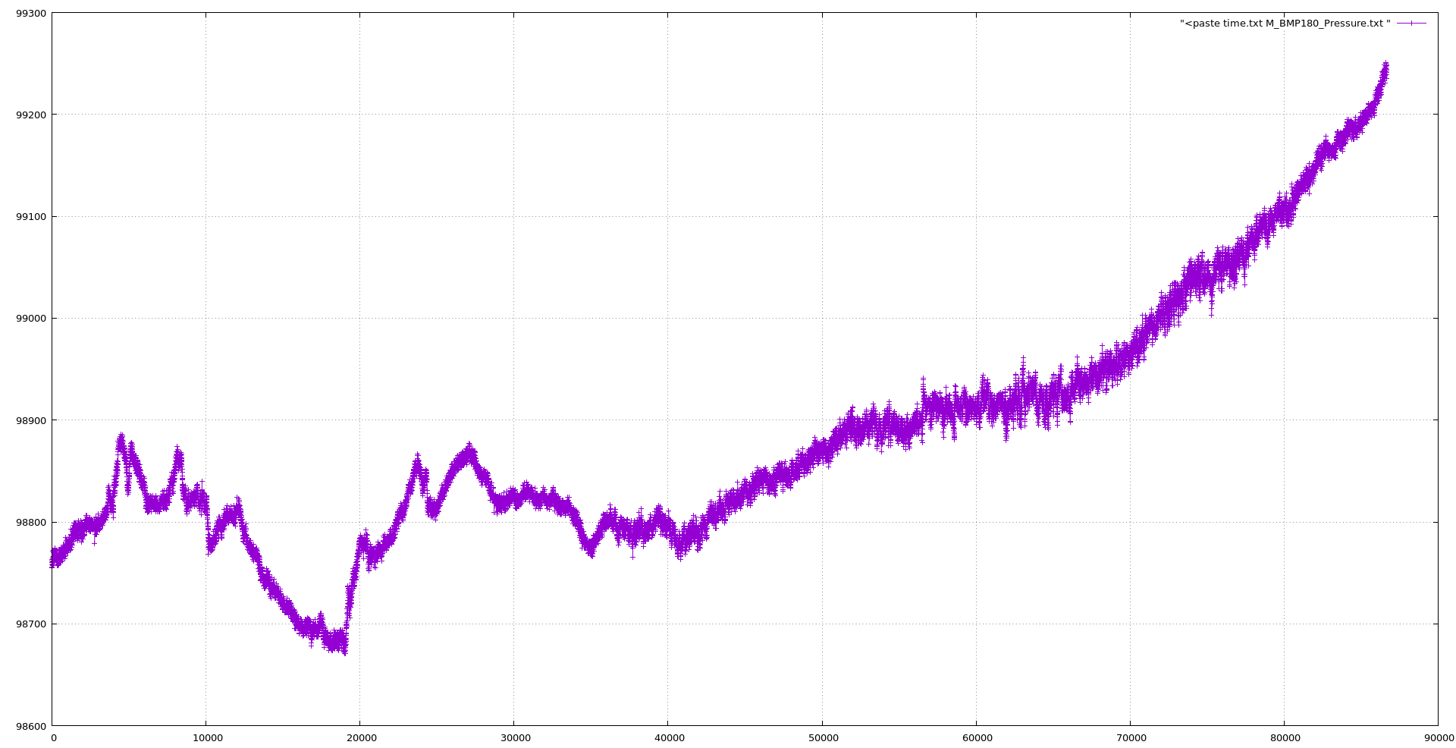
[picture p62: page 1]
