waggle-sensor/sensors/v3/integrated/tests/met_sense/pod_tests/longterm_pod_coldboot_test/Humidity.pdf

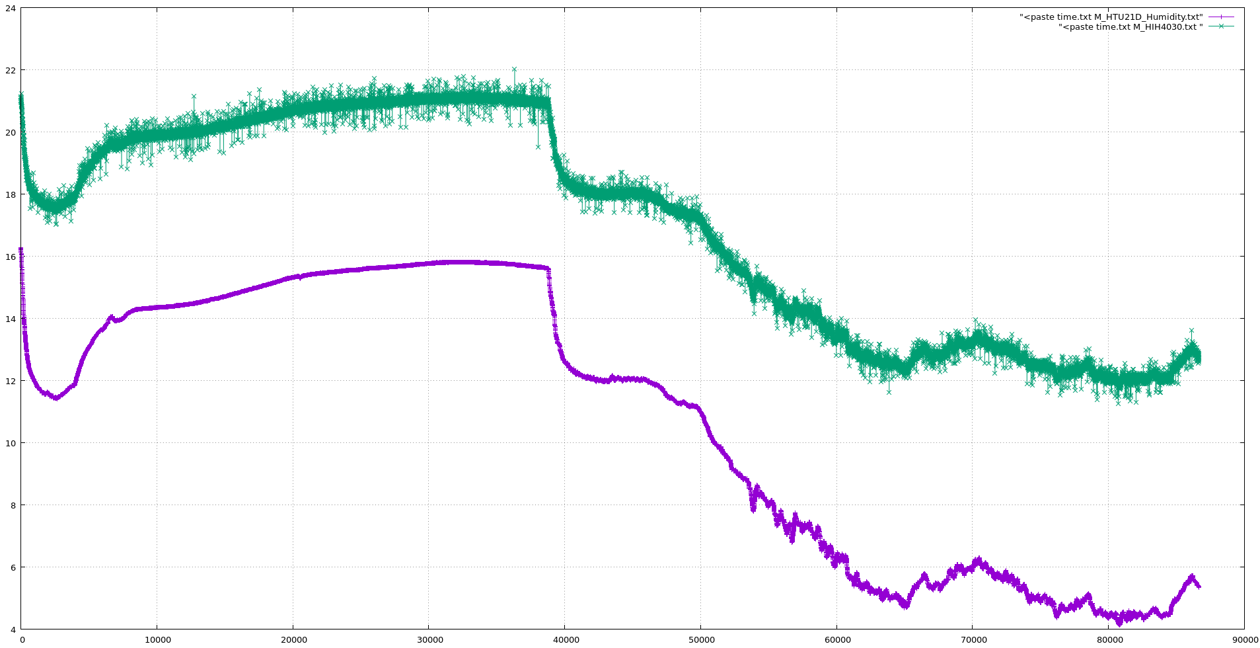
[picture p63: page 1]
