waggle-sensor/sensors/v3/integrated/tests/met_sense/pod_tests/longterm_pod_coldboot_test/Humidity_diff.pdf

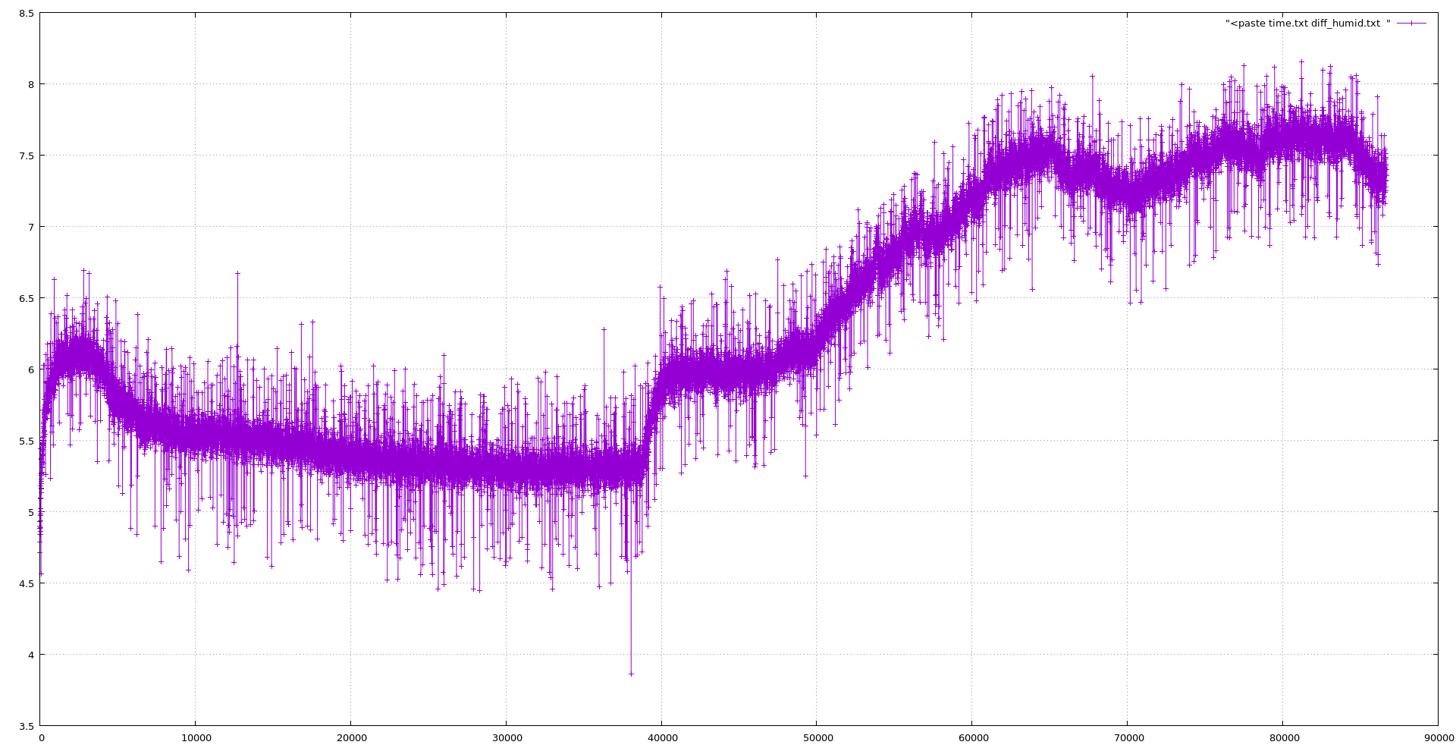
[picture p64: page 1]
