waggle-sensor/sensors/v3/integrated/tests/met_sense/pod_tests/longterm_pod_coldboot_test/Temp_diff.pdf

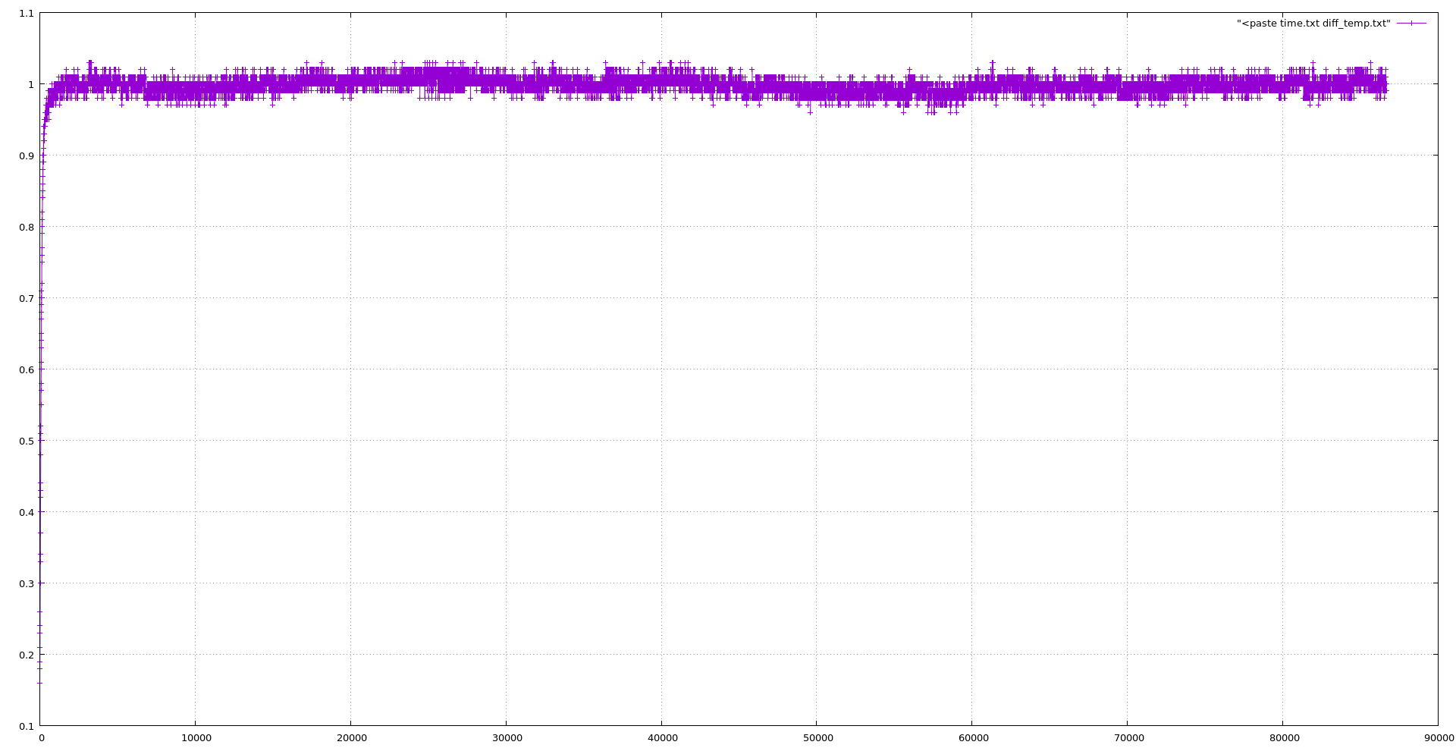
[picture p65: page 1]
