waggle-sensor/sensors/v3/integrated/tests/met_sense/pod_tests/longterm_pod_coldboot_test/Temp_diff_raise.pdf

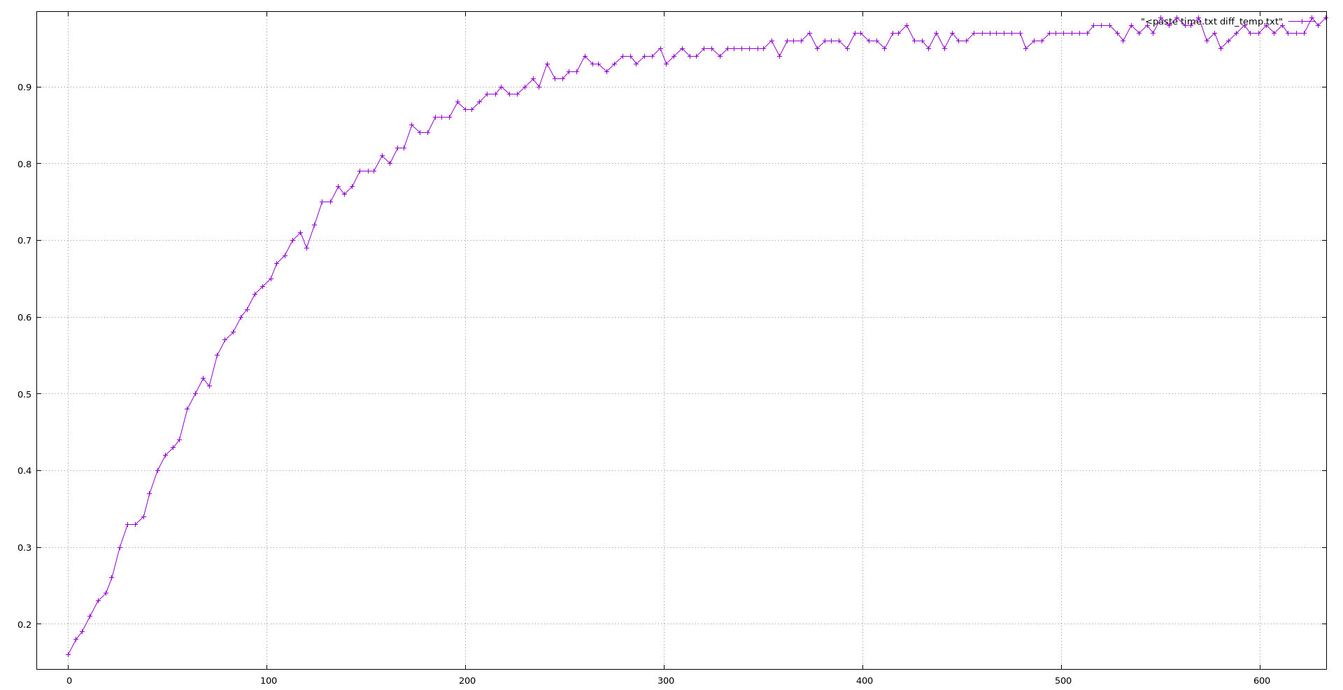
[picture p66: page 1]
