waggle-sensor/sensors/v3/integrated/tests/met_sense/pod_tests/longterm_pod_coldboot_test/Temp_steady_state.pdf

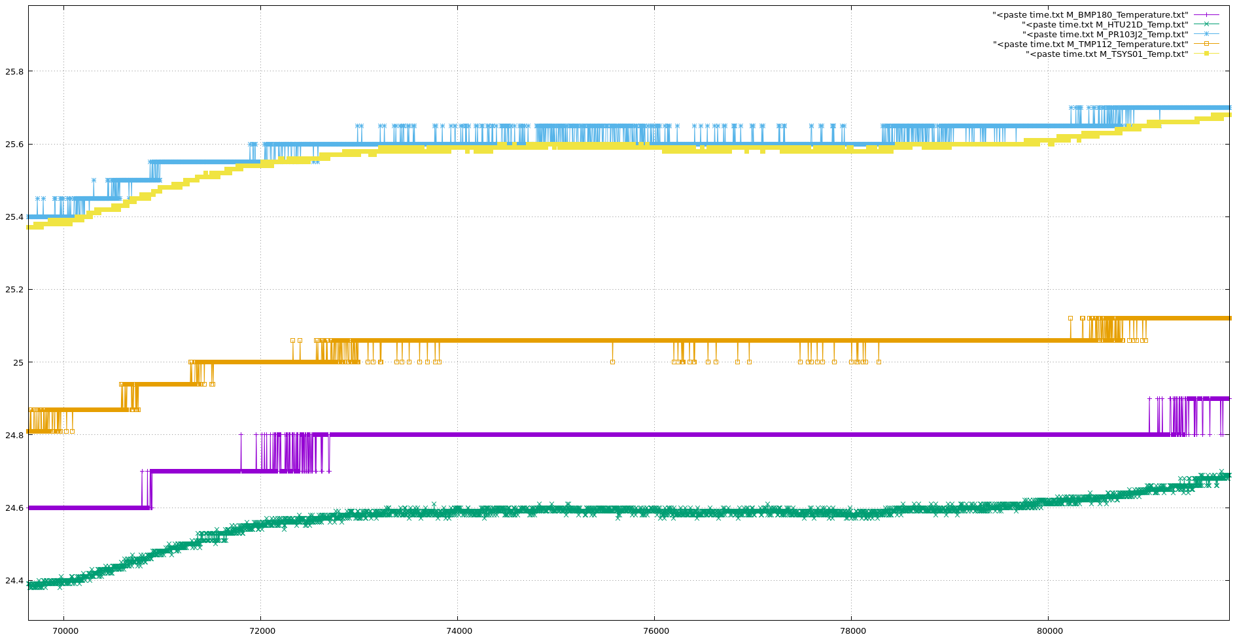
[picture p68: page 1]
