waggle-sensor/sensors/v3/integrated/tests/met_sense/pod_tests/longterm_pod_coldboot_test/Temperature_diverge.pdf

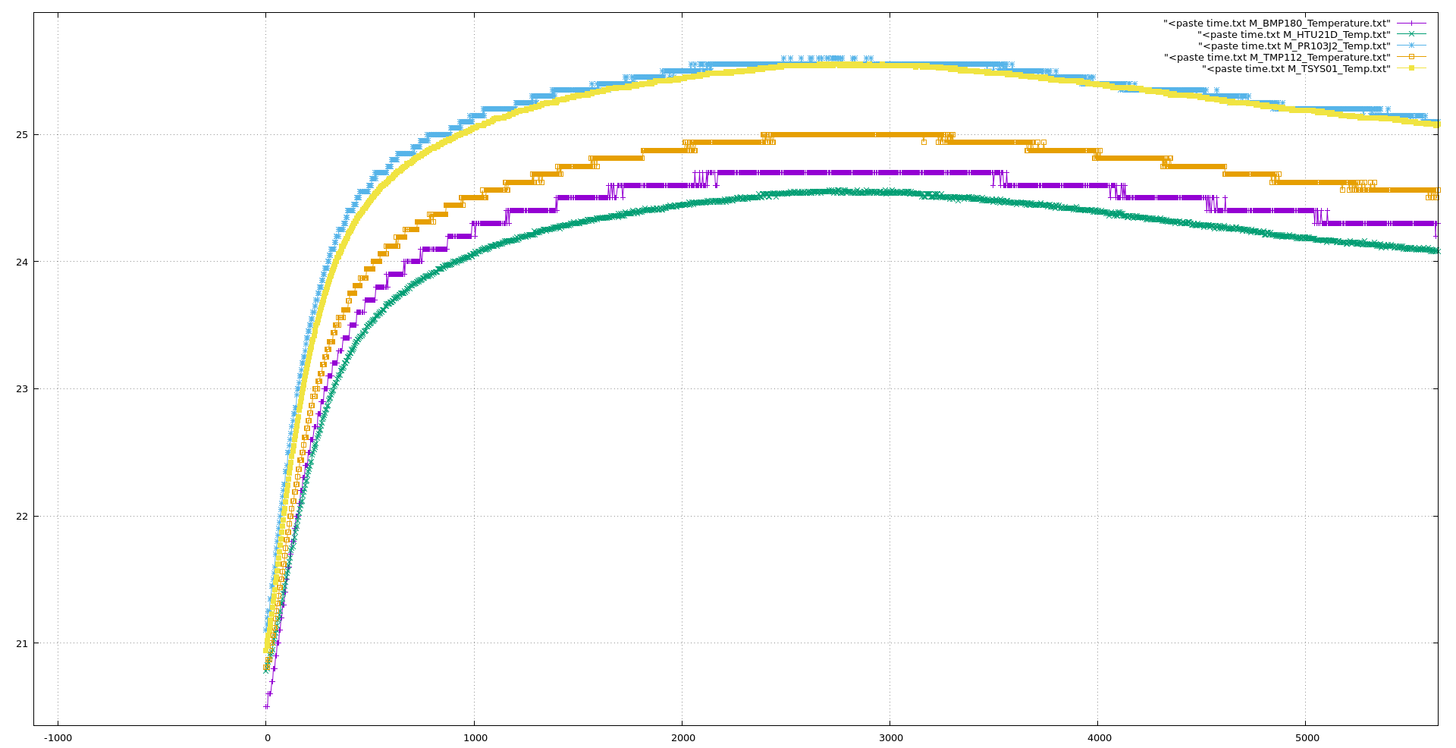
[picture p70: page 1]
