waggle-sensor/sensors/(threads)

Thread 9 (2019-03-22):

Recovery from repeated read errors

seanshahkarami, 2019-03-22:
I noticed recently that the board can just repeatedly keep reading bad values from the bus. We may want to change the logic so that we can automatically reset the bus logic or stop heartbeating to allow a full reset.

Thread 10 (2019-05-07):

Handle nonexistent sensor request gracefully.

seanshahkarami, 2019-05-07:
I _think_ that if a nonexistent sensor is queried, an error value is included in the sensor stream. We may want a way to handle this case gracefully, too.

(Of course, in practice, this may look the same as just a bad sensor... which is fine.)

seanshahkarami, 2019-05-07:
The main motivation for this is being able to just run a common config of everything we'd _like_ to query and gracefully handle excluding things which aren't detected.

I've found that even if the firmware / plugin support reading a specific sensor, we also have to handle a config per-node to read what we want and exclude error values for ones we don't want.
