waggle-sensor/sensors/sensors/user_sensor_ensembles/northwestern/waterLevel/waterLevelSensor.pdf

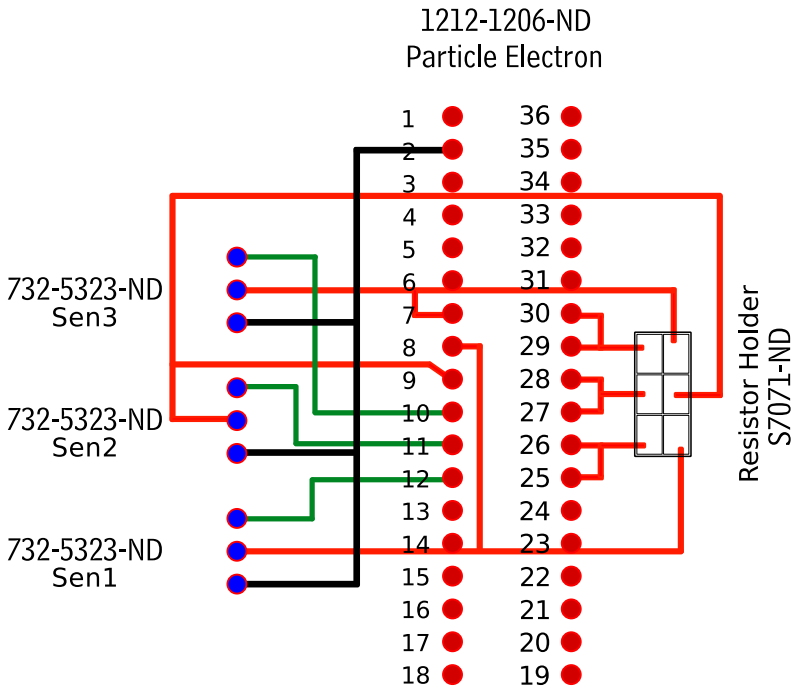
[picture p71: page 1]
