waggle-sensor/sensors/v4/sensor_definition/sensor_definition.pdf

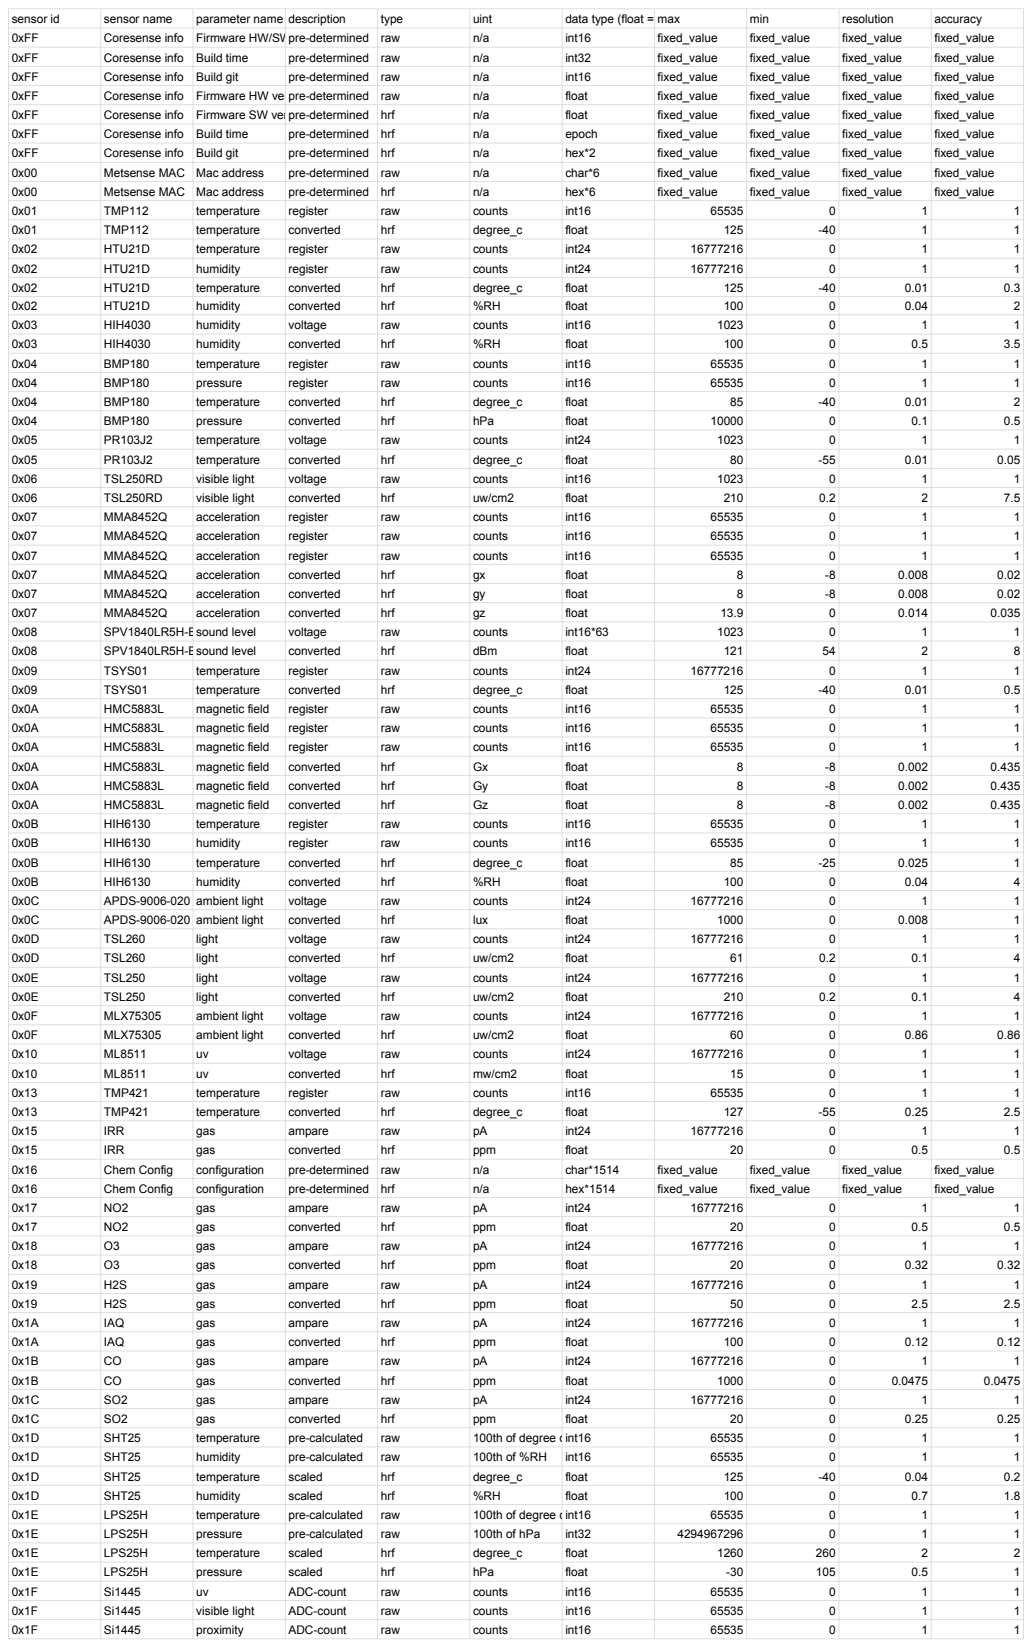
[picture p72: page 1]
sensor id; sensor name; parameter name description; type; uint; data type (float = binary32) max; min; resolution; accuracy; 0xFF; Coresense info Firmware HW/SW version pre-determined raw; int16; fixed_value; Coresense info Build time; pre-determined raw; int32; Coresense info Build git; Coresense info Firmware HW version pre-determined raw; float; Coresense info Firmware SW version pre-determined hrf; pre-determined hrf; epoch; hex*2; Metsense MAC Mac address; char*6; hex*6; TMP112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

0x1F | Si1445 | uv | converted | hrf | TBN | float | TBN | TBN | TBN | TBN
0x1F | Si1445 | visible light | converted | hrf | TBN | float | TBN | TBN | TBN | TBN
0x1F | Si1445 | proximity | converted | hrf | TBN | float | TBN | TBN | TBN | TBN
0x20 | Chemsense MACMac address | pre-determined raw | n/a | char*6 | 65535 | 0 | 1 | 1
0x20 | Chemsense MACMac address | pre-determined hrf | n/a | hex*6 | n/a | n/a | n/a | n/a
0x21 | at0 | temperature | pre-calculated | raw | 100th of degree cint16 | 65535 | 0 | 1 | 1
0x21 | at0 | temperature | pre-calculated | hrf | degree_c | float | TBN | TBN | TBN | TBN
0x22 | at1 | temperature | pre-calculated | raw | 100th of degree cint16 | 65535 | 0 | 1 | 1
0x22 | at1 | temperature | pre-calculated | hrf | degree_c | float | TBN | TBN | TBN | TBN
0x23 | at2 | temperature | pre-calculated | raw | 100th of degree cint16 | 65535 | 0 | 1 | 1
0x23 | at2 | temperature | pre-calculated | hrf | degree_c | float | TBN | TBN | TBN | TBN
0x24 | at3 | temperature | pre-calculated | raw | 100th of degree cint16 | 65535 | 0 | 1 | 1
0x24 | at3 | temperature | pre-calculated | hrf | degree_c | float | TBN | TBN | TBN | TBN
0x25 | lt0 | temperature | pre-calculated | raw | 100th of degree cint16 | 65535 | 0 | 1 | 1
0x25 | lt0 | temperature | pre-calculated | hrf | degree_c | float | TBN | TBN | TBN | TBN
0x26 | BMI160 | acceleration | register | raw | counts | int16 | 65535 | 0 | 1 | 1
0x26 | BMI160 | acceleration | register | raw | counts | int16 | 65535 | 0 | 1 | 1
0x26 | BMI160 | acceleration | register | raw | counts | int16 | 65535 | 0 | 1 | 1
0x26 | BMI160 | acceleration | register | raw | counts | int24 | 16777216 | 0 | 1 | 1
0x26 | BMI160 | acceleration | converted | hrf | g | float | TBN | TBN | TBN | TBN
0x26 | BMI160 | acceleration | converted | hrf | g | float | TBN | TBN | TBN | TBN
0x26 | BMI160 | acceleration | converted | hrf | g | float | TBN | TBN | TBN | TBN
0x26 | BMI160 | acceleration | converted | hrf | g | float | TBN | TBN | TBN | TBN
0x27 | BMI160 | gyro | register | raw | counts | int16 | 65535 | 0 | 1 | 1
0x27 | BMI160 | gyro | register | raw | counts | int16 | 65535 | 0 | 1 | 1
0x27 | BMI160 | gyro | register | raw | counts | int16 | 65535 | 0 | 1 | 1
0x27 | BMI160 | gyro | register | raw | counts | int24 | 16777216 | 0 | 1 | 1
0x27 | BMI160 | gyro | converted | raw | degree/sec | float | TBN | TBN | TBN | TBN
0x27 | BMI160 | gyro | converted | raw | degree/sec | float | TBN | TBN | TBN | TBN
0x27 | BMI160 | gyro | converted | raw | degree/sec | float | TBN | TBN | TBN | TBN
0x27 | BMI160 | gyro | converted | raw | degree/sec | float | TBN | TBN | TBN | TBN
0x28 | Alpha sensor | bin count | count | raw | counts | int16*16 | 65535 TBN | TBN | TBN
0x28 | Alpha sensor | average time | register | raw | counts | int8*4 | 256 TBN | TBN | TBN
0x28 | Alpha sensor | sample flow rate pre-determined raw | n/a | int32 | 4294967296 TBN | TBN | TBN
0x28 | Alpha sensor | temp/pressure (alter) rgister | raw | degree_c/hPa (alter) int32 | 4294967296 TBN | TBN | TBN
0x28 | Alpha sensor | sampling period pre-determined raw | /s | int32 | 4294967296 TBN | TBN | TBN
0x28 | Alpha sensor | checksum | pre-calculated | raw | n/a | int16 | n/a | n/a | n/a | n/a
0x28 | Alpha sensor | PM 1 | register | raw | counts | int32 | 4294967296 TBN | TBN | TBN
0x28 | Alpha sensor | PM 2.5 | register | raw | counts | int32 | 4294967296 TBN | TBN | TBN
0x28 | Alpha sensor | PM 10 | register | raw | counts | int32 | 4294967296 TBN | TBN | TBN
0x28 | Alpha sensor | bin count | converted | hrf | n/a | int16*16 | TBN | TBN | TBN | TBN
0x28 | Alpha sensor | average time | converted | hrf | us | int8*4 | TBN | TBN | TBN | TBN
0x28 | Alpha sensor | sample flow rate converted | hrf | ml/s | float | TBN | TBN | TBN | TBN
0x28 | Alpha sensor | temp/pressure (alter) converted | hrf | degree_c/hPa (alter) float | TBN | TBN | TBN | TBN
0x28 | Alpha sensor | sampling period converted | hrf | /s | int32 | TBN | TBN | TBN | TBN
0x28 | Alpha sensor | checksum | converted | hrf | n/a | int16 | n/a | n/a | n/a | n/a
0x28 | Alpha sensor | PM 1 | converted | hrf | ug/m3 | float | TBN | TBN | TBN | TBN
0x28 | Alpha sensor | PM 2.5 | converted | hrf | ug/m3 | float | TBN | TBN | TBN | TBN
0x28 | Alpha sensor | PM 10 | converted | hrf | ug/m3 | float | TBN | TBN | TBN | TBN
0x29 | Alpha sensor | Serial | pre-determined raw | n/a | char*20 | fixed_value | fixed_value | fixed_value | fixed_value
0x29 | Alpha sensor | Serial | pre-determined hrf | n/a | hex*20 | fixed_value | fixed_value | fixed_value | fixed_value
0x2A | Chemsense | All Chemsense pre-calculated | raw | various | various | various | various | various | various
0x2A | Chemsense | All Chemsense converted | hrf | various | various | various | various | various | various
0x2B | Alpha sensor | Status | bool | raw | n/a | int8*4 | 1 | 0 | 1 | 1
0x2B | Alpha sensor | Status | converted | hrf | n/a | int8*4 | 1 | 0 | 1 | 1
0x30 | Alpha sensor | Firmware | pre-determined raw | n/a | int8*2 | fixed_value | fixed_value | fixed_value | fixed_value
0x30 | Alpha sensor | Firmware | converted | hrf | n/a | int8*2 | fixed_value | fixed_value | fixed_value | fixed_value
0x31 | Alpha sensor | bin boundaries | pre-determined raw | n/a | int16*15 | fixed_value | fixed_value | fixed_value | fixed_value
0x31 | Alpha sensor | bin particle volumespre-determined raw | n/a | int32*16 | fixed_value | fixed_value | fixed_value | fixed_value
0x31 | Alpha sensor | bin particle dencities pre-determined raw | /cm3 | int32*16 | fixed_value | fixed_value | fixed_value | fixed_value
0x31 | Alpha sensor | bin sample volume weightings pre-determined raw | n/a | int32*16 | fixed_value | fixed_value | fixed_value | fixed_value
0x31 | Alpha sensor | gain scaling coeifficient pre-determined raw | n/a | int32 | fixed_value | fixed_value | fixed_value | fixed_value
0x31 | Alpha sensor | sampling flow ratepre-determined raw | ml/s | int32 | fixed_value | fixed_value | fixed_value | fixed_value
0x31 | Alpha sensor | laser DAC | pre-determined raw | n/a | int8 | fixed_value | fixed_value | fixed_value | fixed_value
0x31 | Alpha sensor | fan DAC | pre-determined raw | n/a | int8 | fixed_value | fixed_value | fixed_value | fixed_value
0x31 | Alpha sensor | conversion factor pre-determined raw | n/a | int8 | fixed_value | fixed_value | fixed_value | fixed_value
0x31 | Alpha sensor | spare bytes | spare | raw | n/a | int8*21 | fixed_value | fixed_value | fixed_value | fixed_value
0x31 | Alpha sensor | bin boundaries | pre-determined hrf | n/a | float*15 | fixed_value | fixed_value | fixed_value | fixed_value
0x31 | Alpha sensor | bin particle volumespre-determined hrf | n/a | float*16 | fixed_value | fixed_value | fixed_value | fixed_value
0x31 | Alpha sensor | bin particle dencities pre-determined hrf | n/a | float*16 | fixed_value | fixed_value | fixed_value | fixed_value
0x31 | Alpha sensor | bin sample volume weightings pre-determined hrf | n/a | float*16 | fixed_value | fixed_value | fixed_value | fixed_value
0x31 | Alpha sensor | gain scaling coeifficient pre-determined hrf | n/a | float | fixed_value | fixed_value | fixed_value | fixed_value
0x31 | Alpha sensor | sampling flow ratepre-determined hrf | ml/s | float | fixed_value | fixed_value | fixed_value | fixed_value
0x31 | Alpha sensor | laser DAC | pre-determined hrf | n/a | int8 | fixed_value | fixed_value | fixed_value | fixed_value
0x31 | Alpha sensor | fan DAC | pre-determined hrf | n/a | int8 | fixed_value | fixed_value | fixed_value | fixed_value
0x31 | Alpha sensor | conversion factor pre-determined hrf | n/a | int8 | fixed_value | fixed_value | fixed_value | fixed_value
0x31 | Alpha sensor | spare bytes | spare | n/a | n/a | int8*21 | fixed_value | fixed_value | fixed_value | fixed_value
0x2C | Rain gauge | precipitation | count | raw | counts | int16 | 65535 | 0 | 1 | 1
0x2C | Rain gauge | precipitation | converted | hrf | mm | float | 16645.89 | 0 | 0.254 | 0.254
0x2D | Decagon | volumetric water content register | raw | n/a | int16 | 65535 | 0 | 1 | 1
0x2D | Decagon | electric conductivityregister | raw | dS/m | int16 | 65535 | 0 | 1 | 1
0x2D | Decagon | temperature | register | raw | degree_c | int16 | 65535 | 0 | 1 | 1
0x2D | Decagon | volumetric water content converted | hrf | n/a | float | 1 | 80 | 0.75 | 1
0x2D | Decagon | electric conductivityconverted | hrf | dS/m | float | 23 | 0 | 0.05 | 0.7

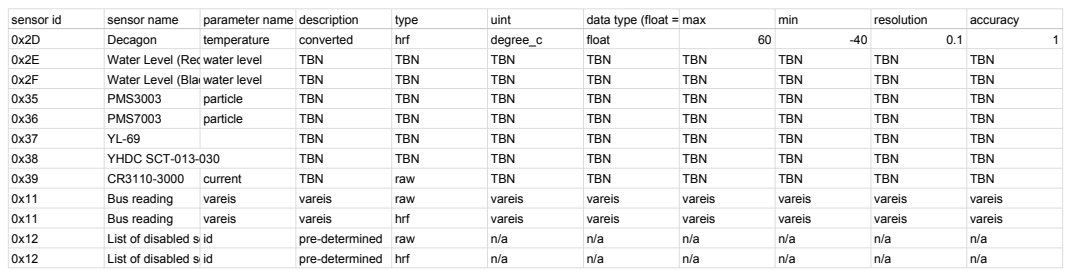
[picture p73: page 3]
Decagon; temperature; converted; hrf; degree_c; float; Water Level (Red)water level; TBN; Water Level (Black) water level; PMS3003; particle; PMS7003; YHDC SCT-013-030; current; raw; Bus reading; vareis; List of disabled sensors id; pre-determined raw; pre-determined hrf
