waggle-sensor/sensors/v3/integrated/tests/met_sense/board_tests/multi_board_test/HIH6130.pdf

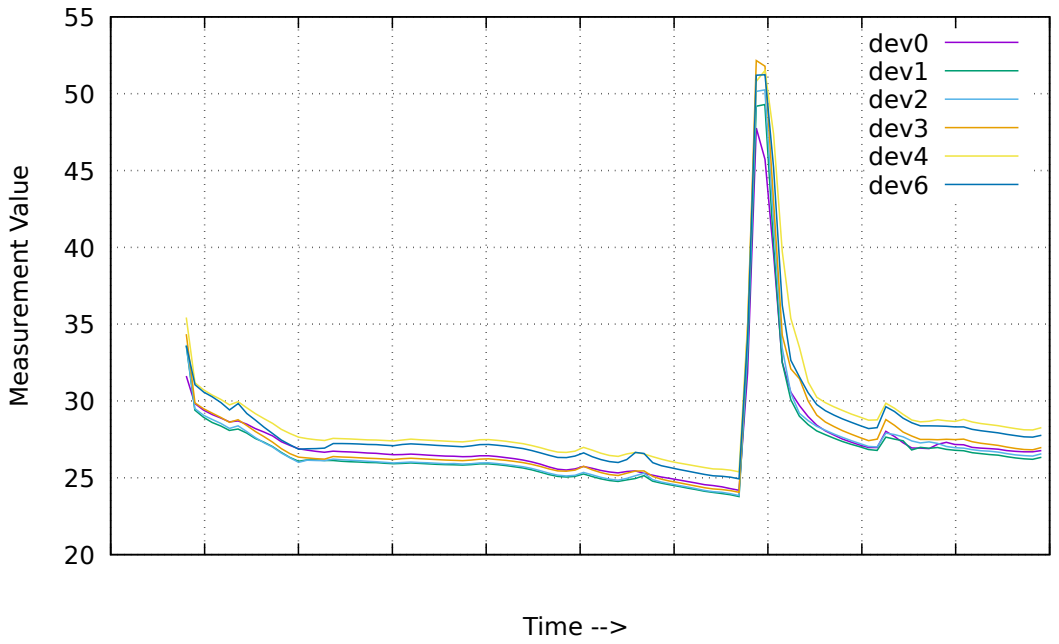
[picture p77: page 1]
Measurement Value; Time -->; dev0 dev1 dev2 dev3 dev4 dev6
