waggle-sensor/sensors/v4/sensor_definition/sensor_details.pdf

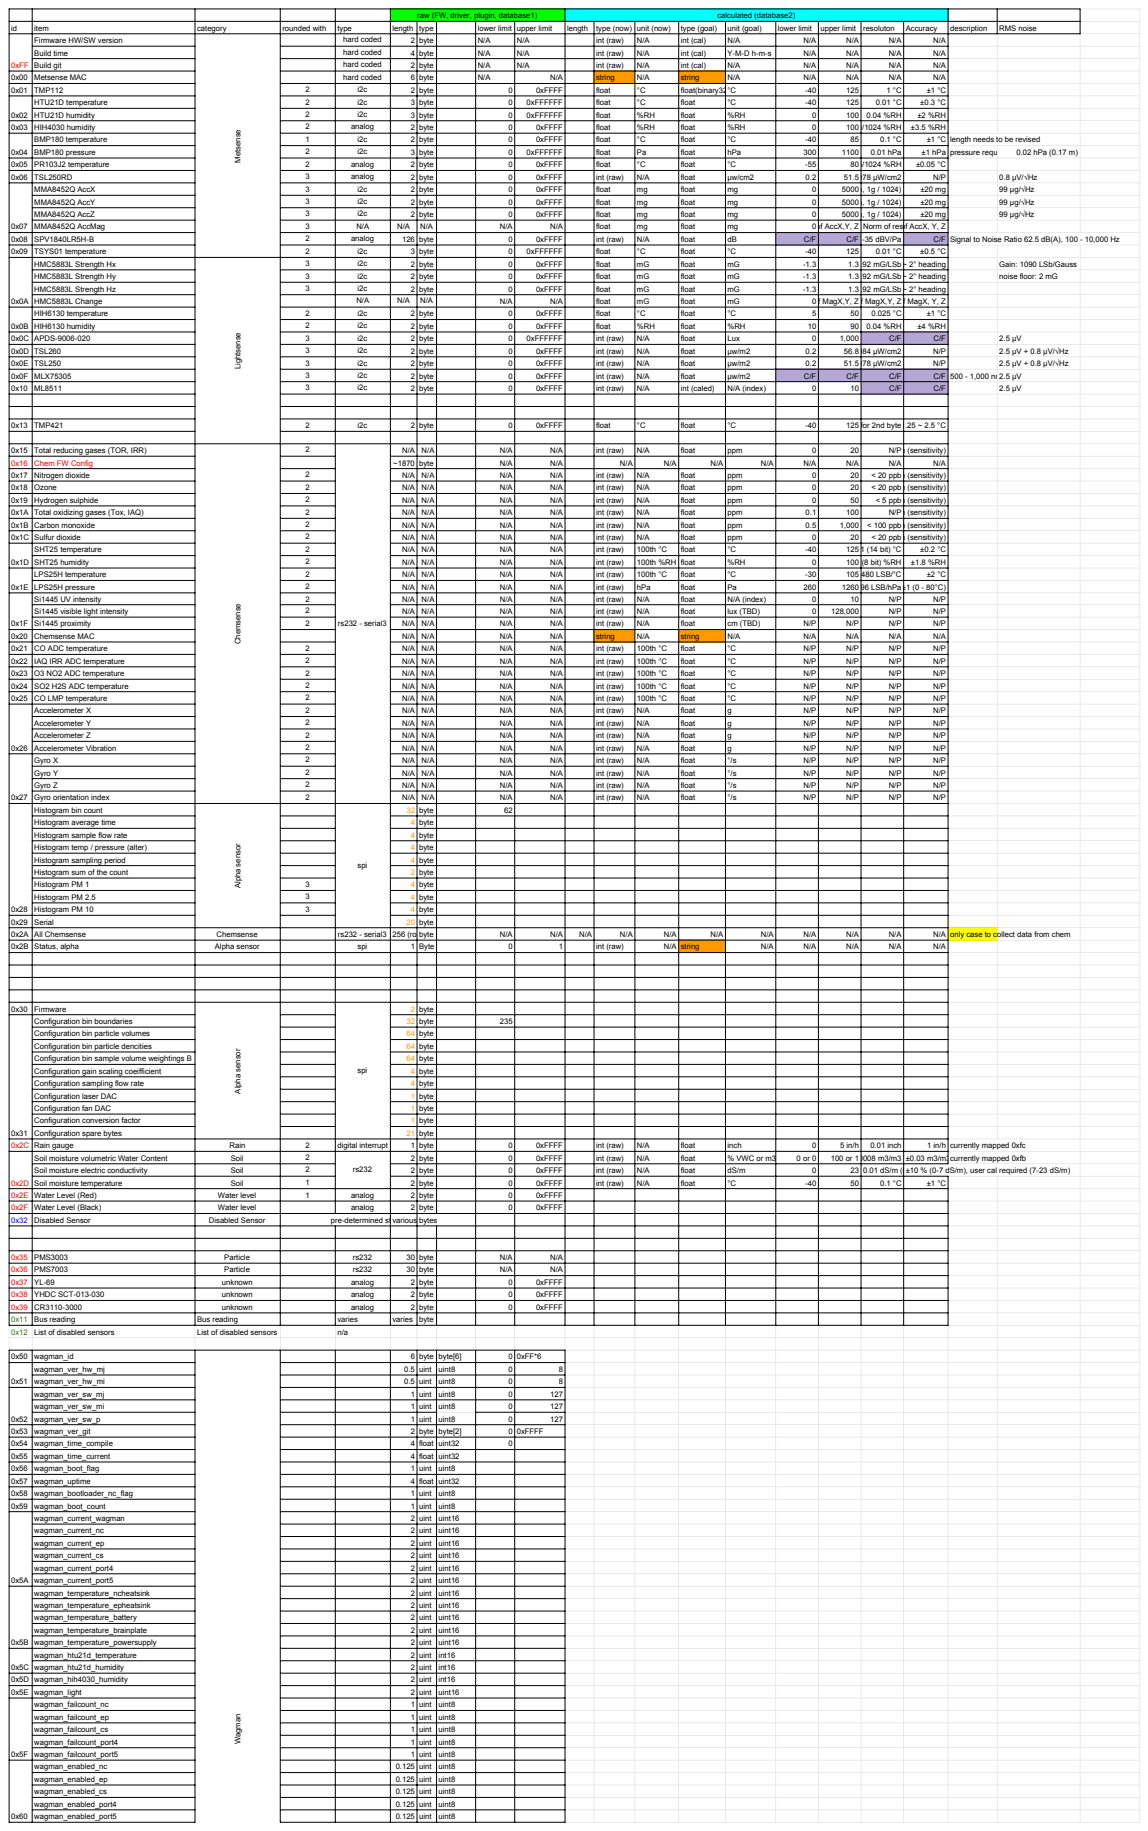
[picture p83: page 1]
raw (FW, driver, plugin, database1); calculated (database2); item; category; rounded with; type; length type; lower limit upper limit; length type (now) unit (now); type (goal); unit (goal); lower limit upper limit resoluton; Accuracy; description; RMS noise; 0xFF; Metsense; hard coded; 2 byte; int (raw); int (cal); Build time; 4 byte; Build git; Metsense MAC; 6 byte; string; TMP112; 0xFFFF; float; float(binary32)°C; HTU21D temperature; 3 byte; 0xFFFFFF; HTU21D humidity; HIH4030 humidity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

Firmware HW/SW version

Histogram bin count

0x2A All Chemsense Chemsense rs232 - serial3 256 (roughly, need to be checked) byte N/A N/A N/A N/A N/A N/A N/A N/A N/A N/A N/A | only case to collect data from chem
0x2B Status, alpha Alpha sensor spi 1 Byte 0 1 | int (raw) | N/A | string | N/A N/A N/A | N/A

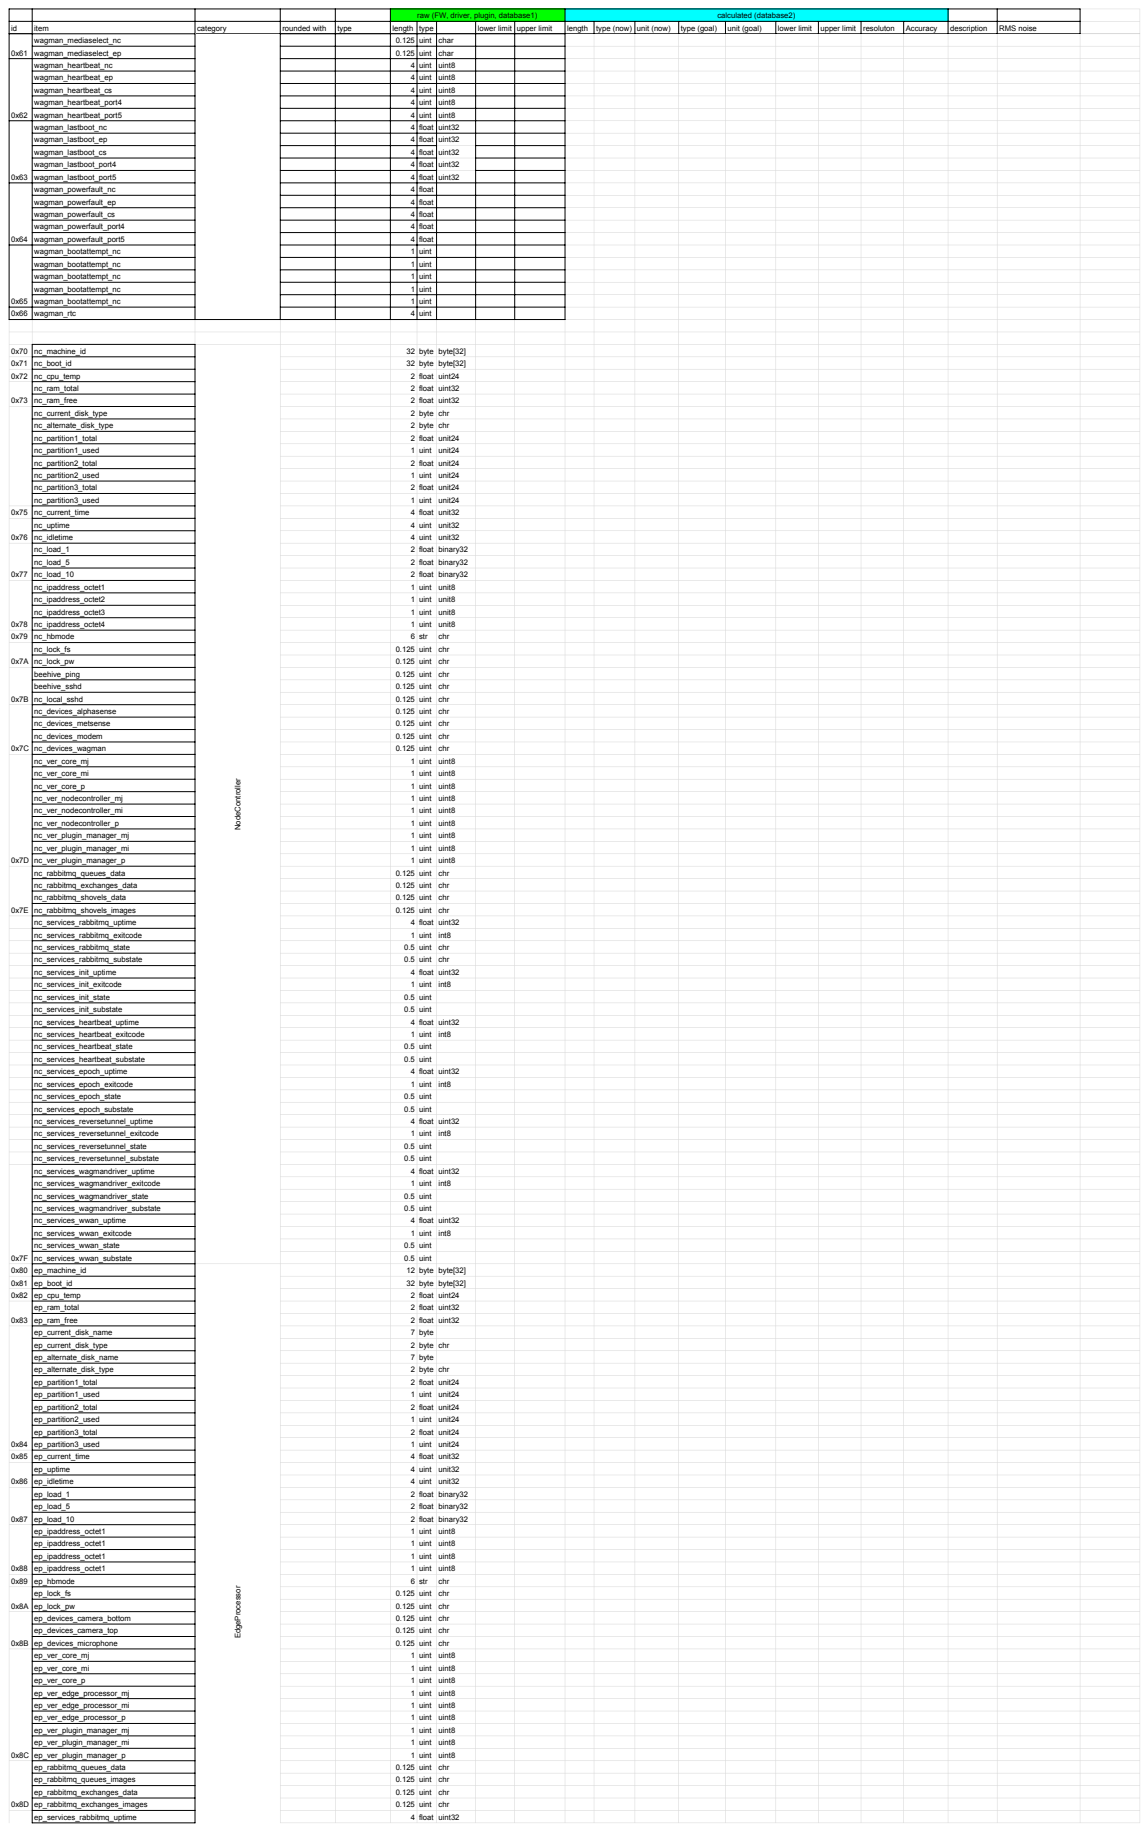
[picture p84: page 2]
nc_machine_id; NodeController; 32 byte byte[32]; nc_boot_id; nc_cpu_temp; 2 float uint24; nc_ram_total; 2 float uint32; nc_ram_free; nc_current_disk_type; 2 byte chr; nc_alternate_disk_type; nc_partition1_total; 2 float unit24; nc_partition1_used; 1 uint unit24; nc_partition2_total; nc_partition2_used; nc_partition3_total; nc_partition3_used; nc_current_time; 4 float unit32; nc_uptime; 4 uint unit32; nc_idletime; nc_load_1; 2 float binary32; nc_load_5; nc_load_10; nc_ipaddress_octet1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

0x61 | wagman_mediaselect_nc | 0.125 | uint | char

wagman_mediaselect_ep | 0.125 | uint | char

0x62 | wagman_heartbeat_nc | 4 | uint | uint8

wagman_heartbeat_ep | 4 | uint | uint8
wagman_heartbeat_cs | 4 | uint | uint8
wagman_heartbeat_port4 | 4 | uint | uint8
wagman_heartbeat_port5 | 4 | uint | uint8

0x63 | wagman_lastboot_nc | 4 | float | uint32

wagman_lastboot_ep | 4 | float | uint32 uint32
wagman_lastboot_cs | 4 | float
wagman_lastboot_port4 | 4 | float
wagman_lastboot_port5 | 4 | float

0x64 | wagman_powerfault_nc | 4 | float

wagman_powerfault_ep | 4 | float
wagman_powerfault_cs | 4 | float
wagman_powerfault_port4 | 4 | float
wagman_powerfault_port5 | 4 | float

0x65 | wagman_bootattempt_nc | 1 | uint

wagman_bootattempt_nc | 1 | uint

0x66 | wagman_rtc | 4 | uint

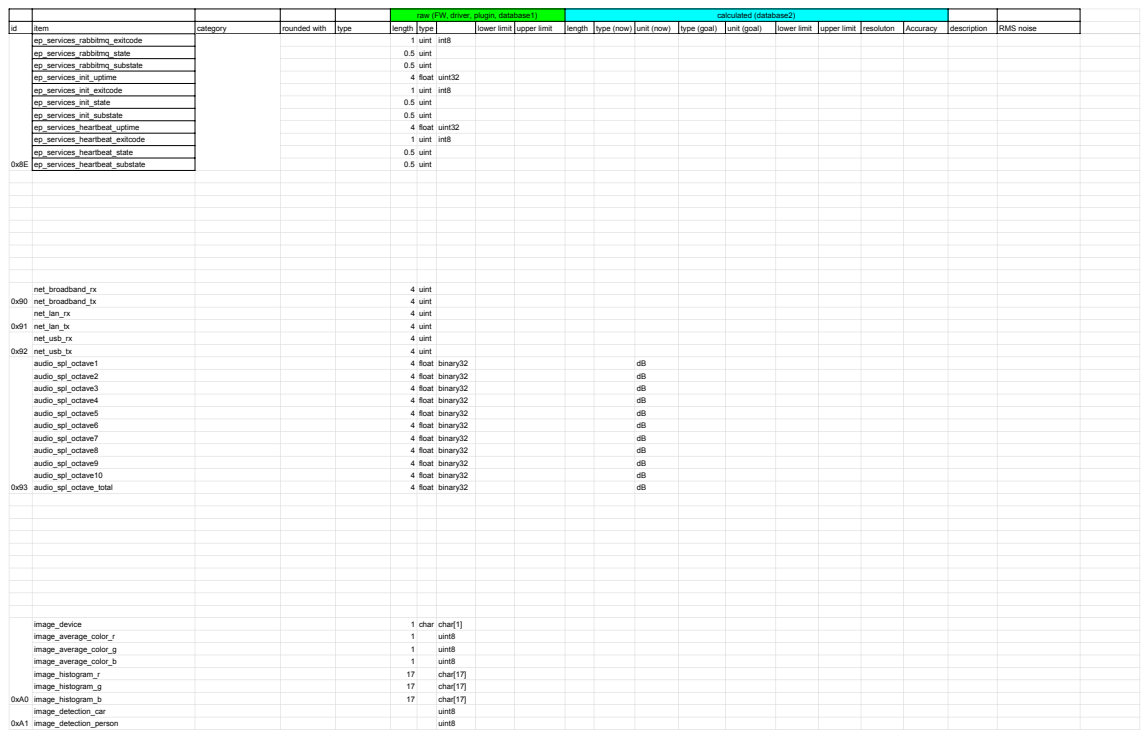
[picture p85: page 3]
ep_services_rabbitmq_exitcode; 1 uint int8; ep_services_rabbitmq_state; 0.5 uint; ep_services_rabbitmq_substate; ep_services_init_uptime; 4 float uint32; ep_services_init_exitcode; ep_services_init_state; ep_services_init_substate; ep_services_heartbeat_uptime; ep_services_heartbeat_exitcode; ep_services_heartbeat_state; ep_services_heartbeat_substate; net_broadband_rx; 4 uint; net_broadband_tx; net_lan_rx; net_lan_tx; net_usb_rx; net_usb_tx; audio_spl_octave1; 4 float binary32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
