waggle-sensor/sensors/v4/sensor_definition/v4_packets.pdf

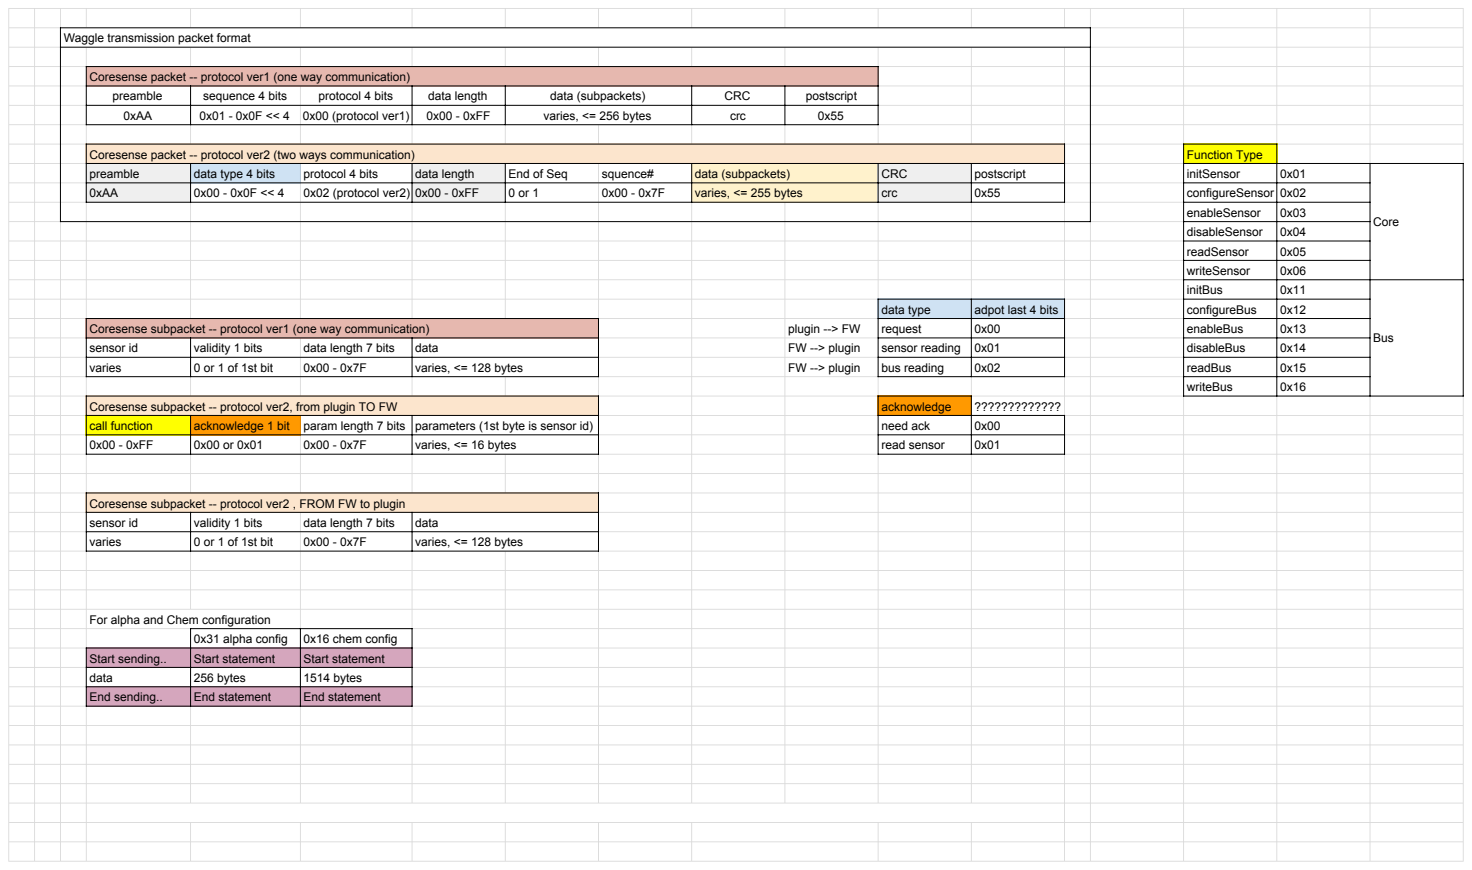
[picture p86: page 1]
Coresense packet -- protocol ver2 (two ways communication); Function Type; preamble; data type 4 bits; protocol 4 bits; data length; End of Seq; squence#; data (subpackets); CRC; postscript; initSensor; Core; 0xAA; 0x02 (protocol ver2); 0x00 - 0xFF; varies, <= 255 bytes; crc; configureSensor; data type; adpot last 4 bits; configureBus; Coresense subpacket -- protocol ver1 (one way communication); plugin --> FW; request; enableBus; sensor id; validity 1 bits; data length 7 bits; data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

Waggle transmission packet format

Coresense packet -- protocol ver1 (one way communication)

preamble | sequence 4 bits protocol 4 bits | data length | data (subpackets) | CRC | postscript
0xAA | 0x01 - 0x0F << 4 0x00 (protocol ver1) | 0x00 - 0xFF | varies, <= 256 bytes | crc | 0x55

enableSensor | 0x03
disableSensor | 0x04
readSensor | 0x05
writeSensor | 0x06
initBus | 0x11 | Bus

Coresense subpacket -- protocol ver2 , FROM FW to plugin

sensor id | validity 1 bits data length 7 bits | data
varies | 0 or 1 of 1st bit 0x00 - 0x7F | varies, <= 128 bytes

For alpha and Chem configuration

0x31 alpha config | 0x16 chem config

Start sending.. | Start statement | Start statement
data | 256 bytes | 1514 bytes
End sending.. | End statement | End statement
