waggle-sensor/sensors/(commit log)

2016-01-22 Sensor board code progress.
2016-01-26 Progress on sensor and wagman eval code.
2016-02-05 converted sensor ids from strings to numbers
2016-02-05 added units to sensor table. plan on using this to partially generate docs in the future.
2016-02-05 fixed small mistake with sensor data slicing
2016-02-05 fixed print / format bug
2016-02-05 fixed print
2016-03-03 Updating the sensor board documentation
2016-03-09 Progress on sensor stream docs.
2016-03-10 Progress on sensor code.
2016-03-22 Finished board Init Test.
2016-03-28 Progress on tests, added features so that the tests report PASS/FAIL for each test.
    [QA_Test.ods]
2016-03-29 Added a bunch of test features and reduced time required for QA.
    [QA_Test.ods]
2016-05-16 Readme file for PBay board parser.
2016-06-01 test code for chem sensors
2016-06-01 Update sensors_setup.ino
    minor change
2016-06-13 change code to find error
    [packet_assembler.ino]
2016-06-28 example for SPI
2016-07-11 clean up codes, generate a sensor doc
2016-08-11 add documentation, conversion equations, and clean up codes
    [sensor_id.csv]
2016-09-12 Some progress on FW code. Trying to seperate sensors based on communication and so on.
2016-10-03 Reorg inside the sensor fw folder.
    [sensor_id.csv]
2016-10-21 need to on sensor type option
2016-10-21 modity sensor setup
2016-10-26 new version of firmware and resolve v2 lightsense problem
    [initialization.ino, new_chemsense.ino, packet_assembler.ino]
2016-10-27 minor changes HMC lib and rain sensor detect
2016-11-15 averaging air/light sensors, resolve I2C hang out
    [firmware.ino, packet_assembler.ino]
2016-11-18 Fixing directory name and config files.
    [firmware.ino, initialization.ino, new_chemsense.ino, packet_assembler.ino]
2016-11-21 v2 i2c error fix
    [firmware.ino]
2016-11-22 Wire/Wire1 error fix
2016-12-15 simple sensor ID extractor with min software deps.
2016-12-21 QA testing improvements and reorg.
    [QA_Test.ods]
2016-12-22 get MAC addr of coresense
    [coresense.csv]
2017-03-06 Progress on light sensors.
    [diff.txt, diff1.txt, diff2.txt, diff_freeze.txt]
2017-03-06 Progress on files to parse raw data and graph them
    [PR103J2.csv, diff.txt, diff1.txt, diff2.txt, diff_freeze.txt]
2017-03-08 progress on cold boot assessment
    [diff_temp.txt, humid_diff.txt, temp_diff.txt]
2017-03-14 Test data from last week. Will create simple graphs in a few minutes for calibration related document.
    [PR103J2.csv, diff.txt, diff1.txt, diff2.txt, diff_freeze.txt, diff_temp.txt, humid_diff.txt, temp_diff.txt]
2017-03-14 Progress on graphs.
    [TSYS_diff_goretex.txt, TSYS_diff_nogoretex.txt, diff_humid.txt, diff_temp.txt]
2017-03-18 Merging sensor documentation and code.
2017-03-18 Cleaning up sensor description table.
2017-03-18 Sensors README file.
2017-05-30 adding sample commands.
2017-05-31 added arduino dep to stringutils.
2017-06-01 i2c to rs232 prot converter for v2 boards
2017-06-02 added stub for i2c-write
2017-06-02 reorganized framer
2017-06-02 split read frame into read until start + read body
2017-06-07 Removing Framer until we see we actually need it.
2017-06-07 Added Printf
2017-06-07 Added TODO about filtering nonprint characters.
2017-06-21 add codes, and talker (maybe prototype of plugin)
2017-06-27 clean up folders, add spi communication code
2017-07-09 use i2c libraries as they are, generate libraries for other i2c sensors
2017-07-11 serial and spi seperated communication
2017-07-14 grab any new sensor connected to coreboard
2017-07-20 combined i2c tables into single struct table
2017-07-20 cleaned up i2c / command lookups
2017-07-20 organizing i2c into tables
2017-07-20 refactoring out all metsense / lightsense into just devices
2017-07-20 refactored metsense into devices
2017-07-20 converted lightsense devices into common devices table
2017-07-21 forgot to add devices files
2017-07-24 added list devices
2017-07-24 getting printouts from all onboard sensors now
2017-10-09 Changing chemsense current unit
2017-10-13 Moving files in v4 folder so that it can be pulled into sensors repo.
2017-10-20 Some rework on FW base...
    [initialization.ino]
2017-10-27 clean up firmware builds, chemsense baudrate in v3/testing/avg from 19200 to 115200
    [Firmware Commands Version 18.xls]
2017-10-30 changes because of v3 test with alpha sensor and new chemsense board (baudrate changed to 115200) and adds for v4.1
2017-11-02 added chem/alpha sensor init/reading
2017-11-03 minor fix, remove serial.println
2017-11-09 minor fix
    [Firmware Commands Version 18.xls]
2017-11-09 minor fix is on going
    [initialization.ino]
2017-11-09 do flash in packet assembler
2017-11-16 Progress on Sensors code.
2017-11-17 add sensor.inos change others regards
2017-11-21 add and test i2c sensor reading, tmp112
2017-11-21 separate variables to each sensor*.ino, add Sensor*.h if necessary
2017-11-22 add i2c analog digital serial pwm spi bus functions, change with regards to the additional functions
2017-12-12 set heartbeat pin to output mode
2018-01-23 change sound level sensor pin for reading, but the collected data still does not seem properly changing
2018-01-24 change sound level sensor pin
2018-01-31 bug fix, make clean
    [firmware.ino]
2018-01-31 add disabled sensor noice
2018-02-16 chemsense conversion
    [calib_data.xlsx]
2018-02-16 add convertion only python
    [calib_data.csv]
2018-02-16 add conversion
    [calib_data.csv]
2018-02-16 change execution file
    [calib_data.csv]
2018-02-16 recover accidently removed file
    [calib_data.csv]
2018-02-16 error fix, sensor keys differ in nodes
2018-02-19 remove redundant print outs
2018-02-26 new chemical sensors calibration data
    [calib_data.csv]
2018-02-26 add final version of chemical sensors calibration data
    [calib_data.csv]
2018-02-28 remove no-need lines from calib_data.csv
    [calib_data.csv]
2018-02-28 change calib_data.csv file, removed no-need lines
    [calib_data.csv]
2018-02-28 add flowchart
2018-03-01 added one process in the flowchart
2018-03-08 maintaining current interface - added support for stdin -> stdout processing. editor converted lots of tabs to spaces...
2018-03-09 added csvs
    [sensor_table_v3.csv, sensor_table_v4.csv]
2018-03-09 changed csvs
    [sensor_table_v3.csv, sensor_table_v4.csv]
2018-03-12 change name and location
    [sensor_table.csv, sensor_table_v4.csv]
2018-03-14 Create SDF_V1.csv
    Creating an initial format for SDF and writing values.
    [SDF_V1.csv]
2018-03-16 adding sdf
    [SDF_V1.csv]
2018-03-19 Some code cleanup, adding new y axis to track conversions, changed filenames.
2018-03-20 added calling sensor enable function
2018-03-20 added pms7003 sensor
2018-03-21 PMS7003 particle sensor added
2018-03-22 clean up alpha sensor
2018-03-27 change on v3 to remove all i2c sensors
2018-03-27 solved lightsense error when i2c sensors commented out
    [firmware.ino]
2018-04-04 pms sensor reading i modified
2018-04-16 Added checking error code and firmware version of pms7003 sensor when read data
2018-04-26 Added Sensor12, removed Sensor16
2018-04-27 Remove Sensor12 to prevent crash on pywaggle and plugin
2018-05-17 Updated flowchart
2018-05-22 Finally adding adhoc sensors to the repo
2018-05-22 Added flowchart
2018-05-24 Added rain gauge, Decagon soil moisture sensor
2018-05-29 Added sensor definition and protocol traits
    [sensor_definition.csv, sensor_details.csv, v4_API.csv, v4_packets.csv]
2018-05-31 simple cleanuo
    [SDF_V1.csv]
2018-05-31 Added soil moisture sensor
2018-05-31 Renaming folders.
    [sensor_definition.csv, sensor_details.csv, v4_API.csv, v4_packets.csv]
2018-05-31 Renaming folders
    [sensor_definition.csv, sensor_details.csv, v4_API.csv, v4_packets.csv]
2018-05-31 moving file
    [SDF_V1.csv]
2018-06-02 Added soil moisture sensor, Decagon
2018-06-04 moving other opc-n2 docs here.
    [Firmware Commands Versions 16-17.xls]
